edumardo/VK-16.02-Leopard/images/top.png

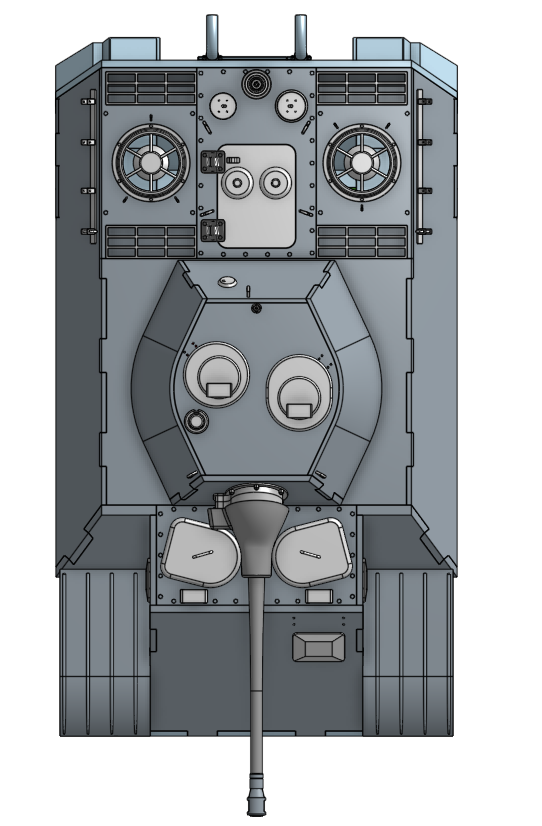
images/top.png
