edumardo/VK-16.02-Leopard/README.md

# STL files for 1/16 RC VK-16.02 Leopard

With this files you can 3D print and build a RC VK-16.02 Leopard tank. The [Leopard](https://en.wikipedia.org/wiki/VK_16.02_Leopard) was a German prototype of light reconnaissance tank, finally canceled and none was built.

## Required non-printable parts

Electronics:

* Gearboxes long shaft.
* For turret rotation, you can choose one:
  * 1 x Continuous rotation servo, like DM-S0090D.
  * 1 x Standard Heng Long motor unit.
* 2 x servos for recoil system and elevation, like MG90S.

Hardware:

* 14 x 5mmx2mm round neodymium magnets.
* 2  x M2x5mm screws.
* 8  x M2x8mm screws.

From Heng Long 3879 Panther or 3869 Jagdpanther:

* 2  x sprocket drive wheels.
* 2  x transmission covers (optional).
* 2  x idler wheels.
* 10 x wheel arms.
* 10 x wheel arm springs.
* 10 x arm screws.
* 10 x wheel bolt cover (optional).
* 6  x double wheels.
* 4  x single wheels.
* 2  x tracks (each one reduced to 67 links).
* 1  x rotating ring, the big one.

## How to build

Follw the assembly documents, preferably in order:

1. [Hull assembly](hull/hull%20assembly.pdf)
2. [Suspension assembly](suspension/suspension%20assembly.pdf)
3. [Rear stuff assembly](rear%20stuff/rear%20stuff%20assembly.pdf)
4. [Upper hull assembly](upper%20hull/upper%20hul%20assembly.pdf)
5. [Turret assembly](turret/turret%20assembly.pdf)

And the all parts STL files:

1. [hull - all parts.stl](hull/hull%20-%20all%20parts.stl)
2. [suspension - all parts.stl](suspension/suspension%20-%20all%20parts.stl)
3. [rear stuff - all parts.stl](rear%20stuff/rear%20stuff%20-%20all%20parts.sql.stl)
4. [upper hull - all parts.stl](upper%20hull/upper%20hull%20-%20all%20parts.stl)
5. [turret - all parts.stl](turret/turret%20-%20all%20parts.stl)
6. [VK16.02 Leopard - all parts.stl](VK16.02%20Leopard%20-%20all%20parts.stl) (entire model)

You can check the `all-parts` files and ungroup it to get the individual files with tools like 3D Builder or Meshmixer. Then, combine them if you want.

Additionally, you can follow the model development and construction on the following forums:

* Topic on [RCTankWarfare forum](https://www.rctankwarfare.co.uk/forums/viewtopic.php?f=23&t=32358) (english).
* Hilo en el foro [La Cadena Herrumbrosa](https://lacadenaherrumbrosa.foroactivo.com/t251-vk-16-02-leopard) (español).

## Bibliography and documentation

Primary source:

* Panzer Tracts 20-2 - Paper Panzers

Secondary sources:

* Panzer Tracts No. 05-1 - Panzerkampfwagen Panther Ausfuehrung D with Versuchs-Serie Panther, Fgst.Nr.V2
* Panzer Tracts No. 05-2 - Panzerkampfwagen Panther Ausfuehrung A
* Panzer Tracts No. 05-3 - Panzerkampfwagen Panther Ausfuehrung G
* Panzer Tracts No. 09-3 - Jagdpanther Panzerjaeger Panther (8.8 cm) (Sd.Kfz.173) Ausf.G 1 und G2

All books by Thomas L. Jentz and Hilary Louis Doyle.
