edumardo/VK-16.02-Leopard/images/front.png

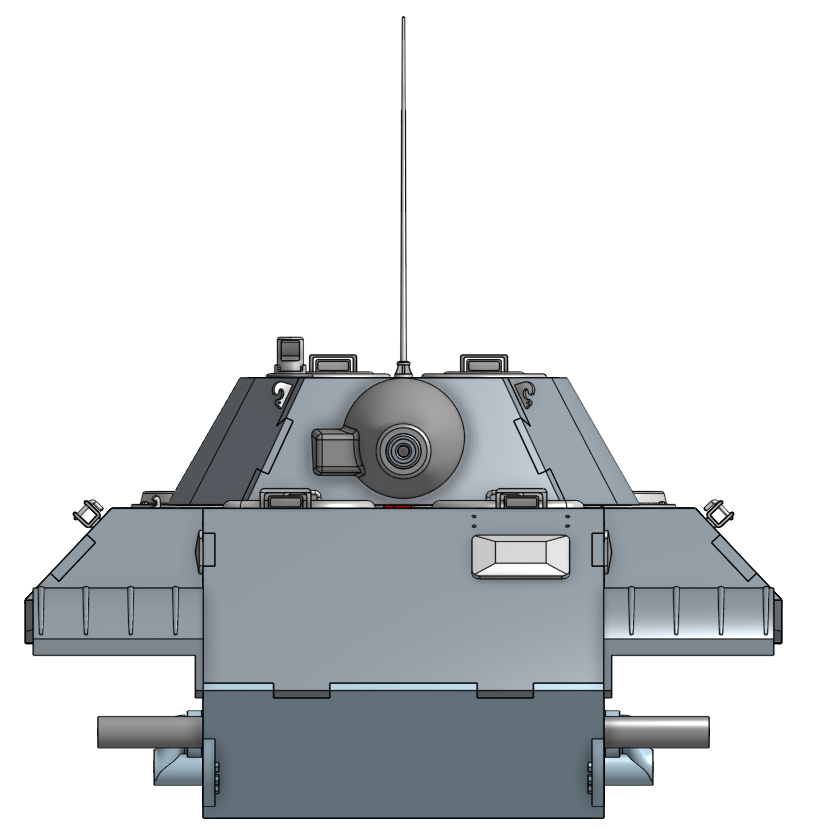
images/front.png
