edumardo/VK-16.02-Leopard/images/isometric 1.png

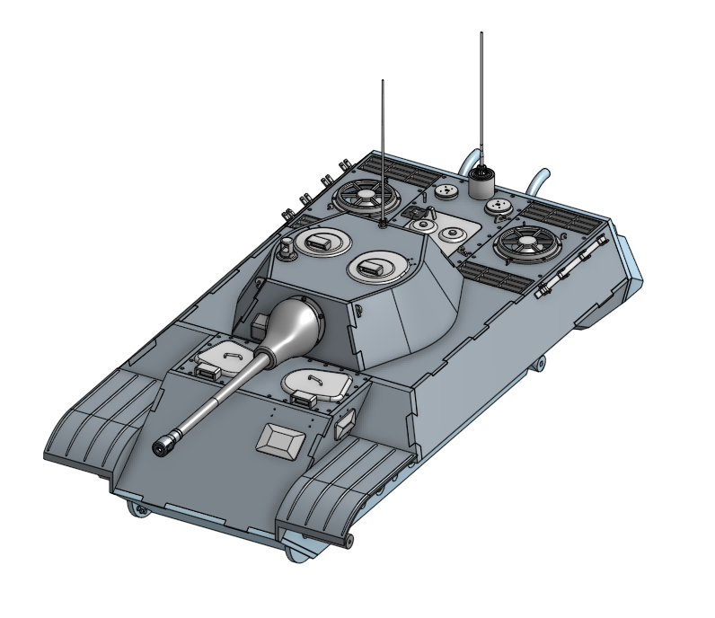
images/isometric 1.png
