edumardo/VK-16.02-Leopard/images/isometric 2.png

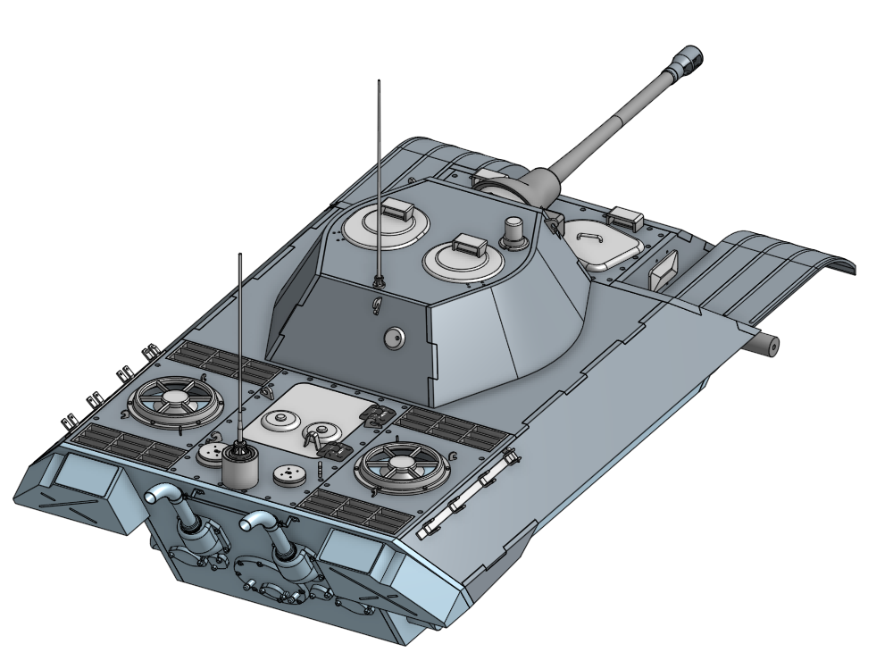
images/isometric 2.png
