edumardo/VK-16.02-Leopard/images/left.png

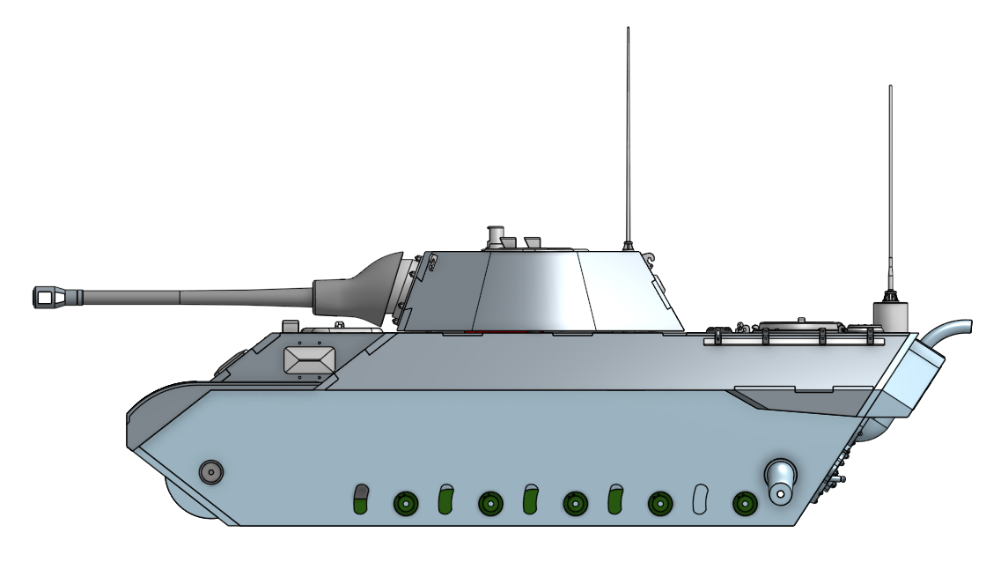
images/left.png
