edumardo/VK-16.02-Leopard/images/rear.png

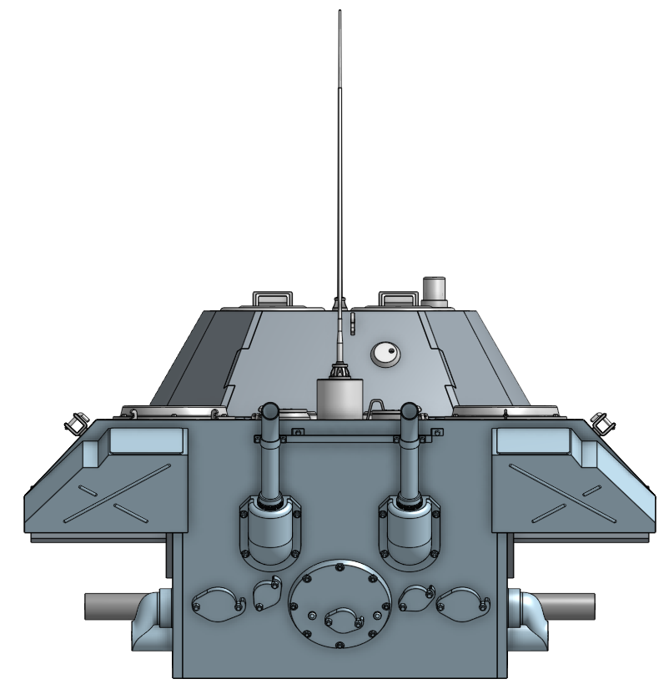
images/rear.png
