edumardo/VK-16.02-Leopard/images/right.png

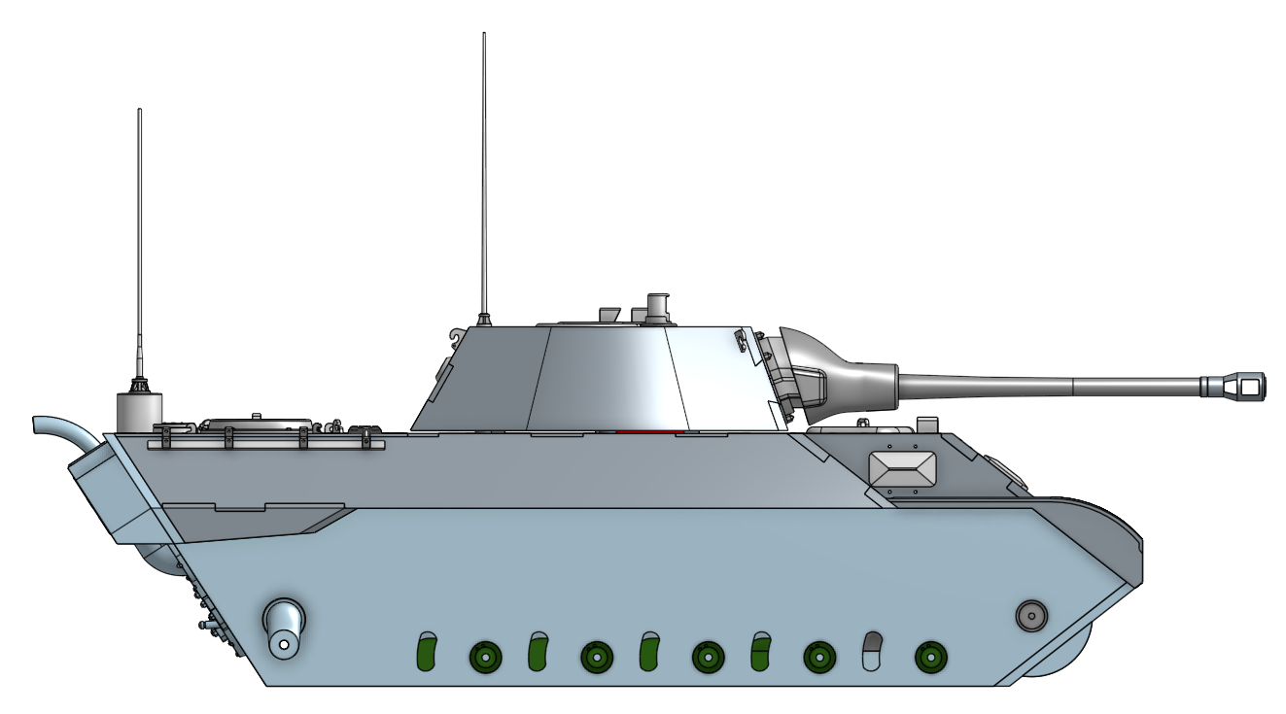
images/right.png
