edumardo/VK-16.02-Leopard/hull/lower hull.stl

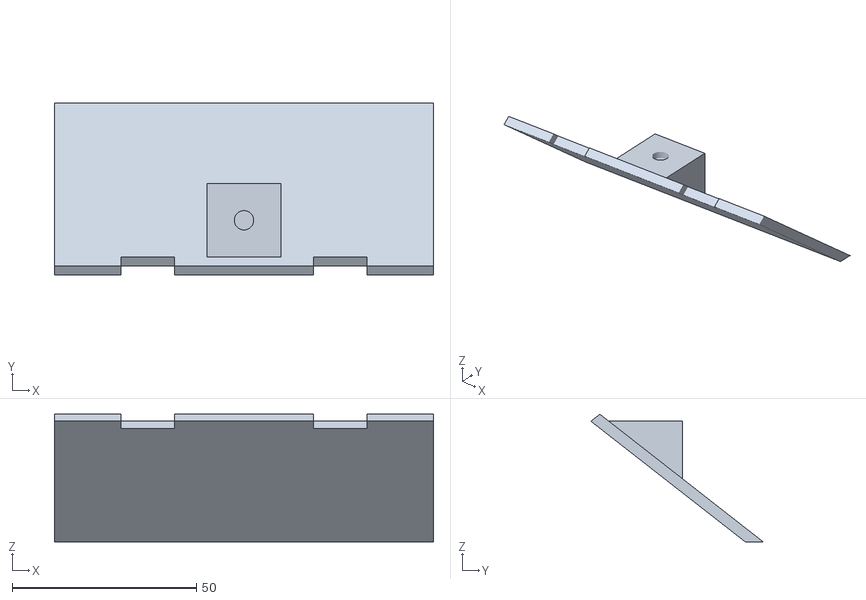
[picture p8: CAD file, 2022-06-27]
hull/lower hull.stl
102.8 x 46.7 x 34.6
