edumardo/VK-16.02-Leopard/rear stuff/exhaust pipe v2 left.stl

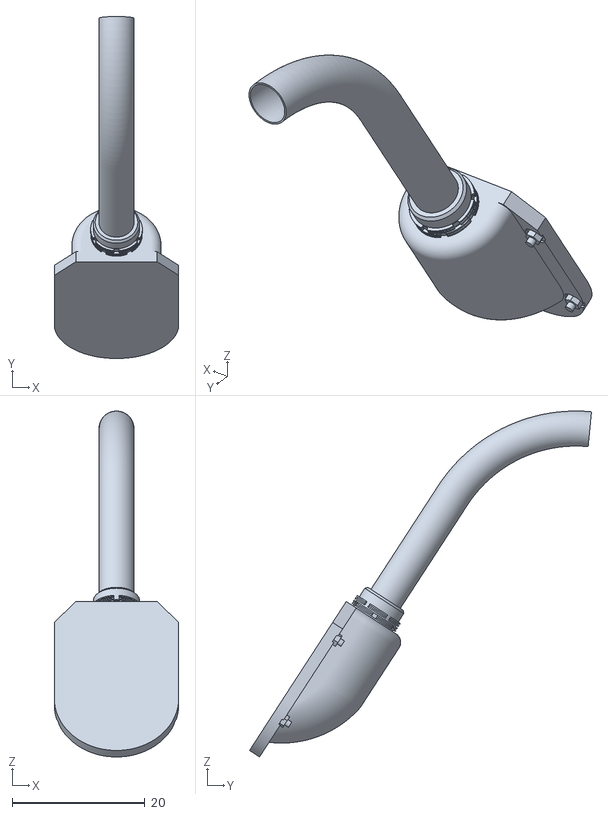
[picture p9: CAD file, 2022-04-29]
rear stuff/exhaust pipe v2 left.stl
18.7 x 51.5 x 52.1
