edumardo/VK-16.02-Leopard/suspension/swing arm support motor left.stl

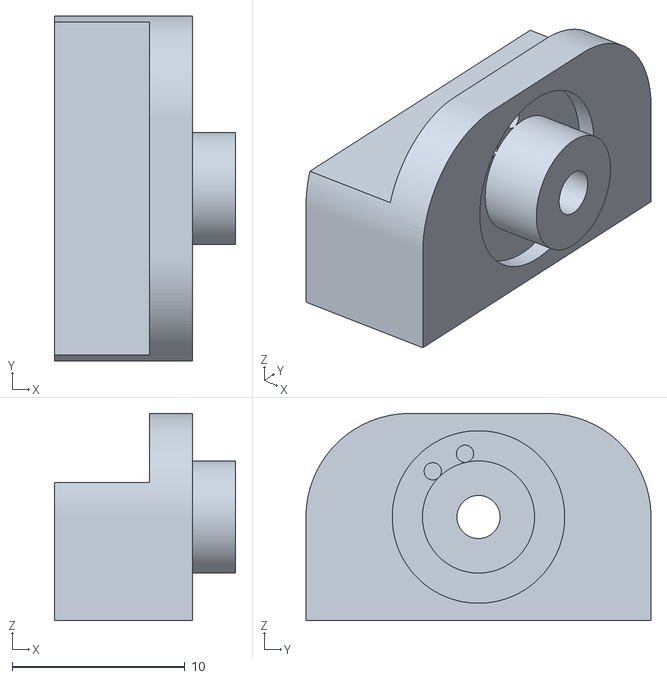
[picture p10: CAD file, 2022-06-21]
suspension/swing arm support motor left.stl
10.5 x 20.0 x 12.0
