edumardo/VK-16.02-Leopard/turret/gun barrel - hollow part b.stl

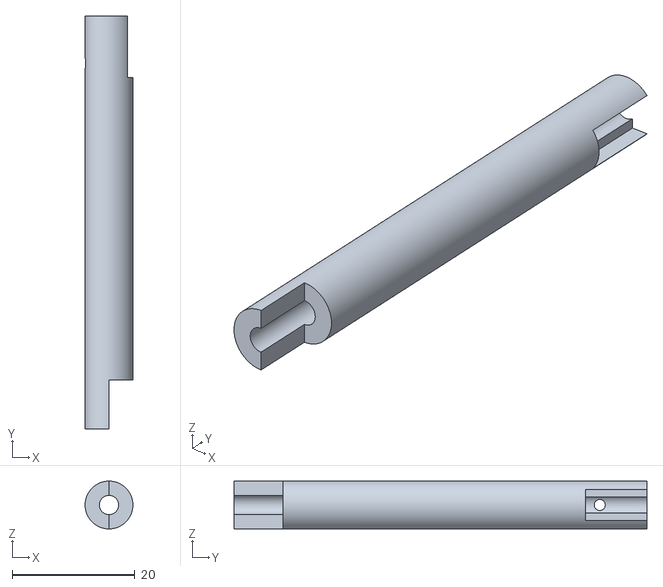
[picture p11: CAD file, 2026-04-24]
turret/gun barrel - hollow part b.stl
7.80 x 67.3 x 7.80
