edumardo/VK-16.02-Leopard/upper hull/radio hatch.stl

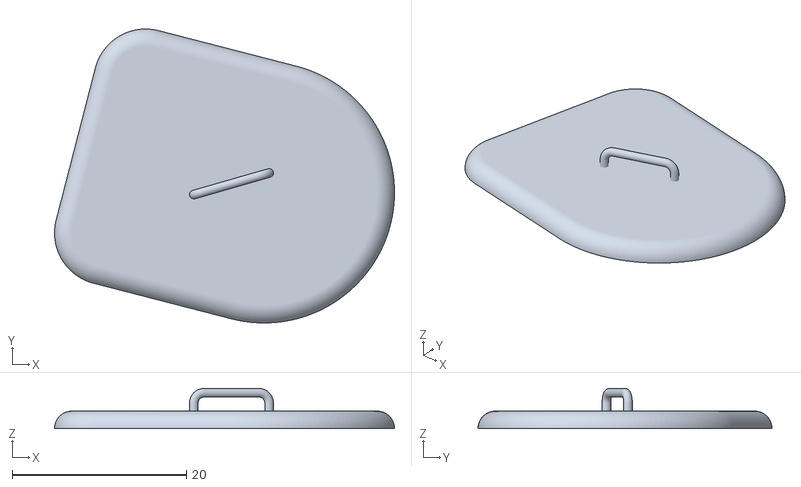
[picture p12: CAD file, 2022-10-20]
upper hull/radio hatch.stl
39.0 x 33.8 x 4.60
