edumardo/VK-16.02-Leopard/hull/hull - all parts.stl

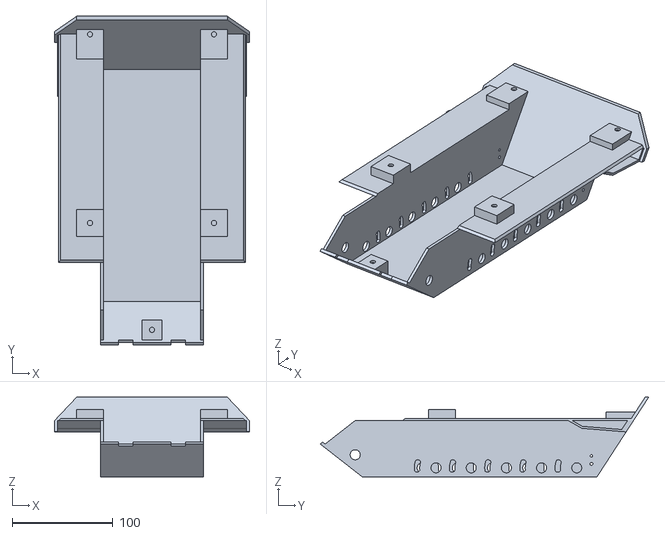
[picture p13: CAD file, 2022-06-27]
hull/hull - all parts.stl
194.0 x 326.8 x 79.4
