edumardo/VK-16.02-Leopard/rear stuff/rear stowage bin right.stl

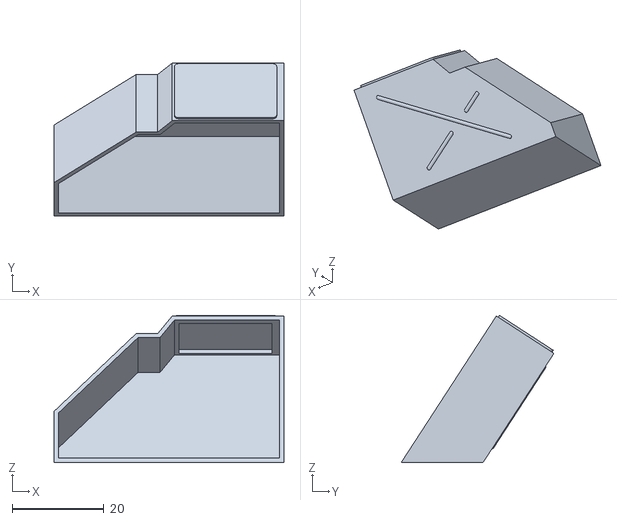
[picture p14: CAD file, 2022-04-29]
rear stuff/rear stowage bin right.stl
50.2 x 33.4 x 32.2
