edumardo/VK-16.02-Leopard/turret/gun barrel hollow.stl

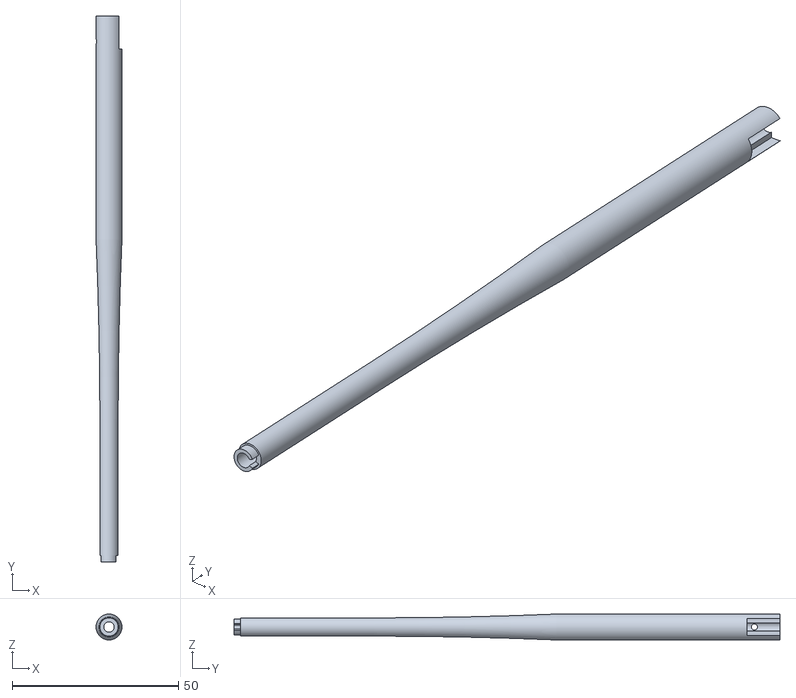
[picture p15: CAD file, 2026-04-24]
turret/gun barrel hollow.stl
7.80 x 164.3 x 7.80
