edumardo/VK-16.02-Leopard/upper hull/spare track link pin.stl

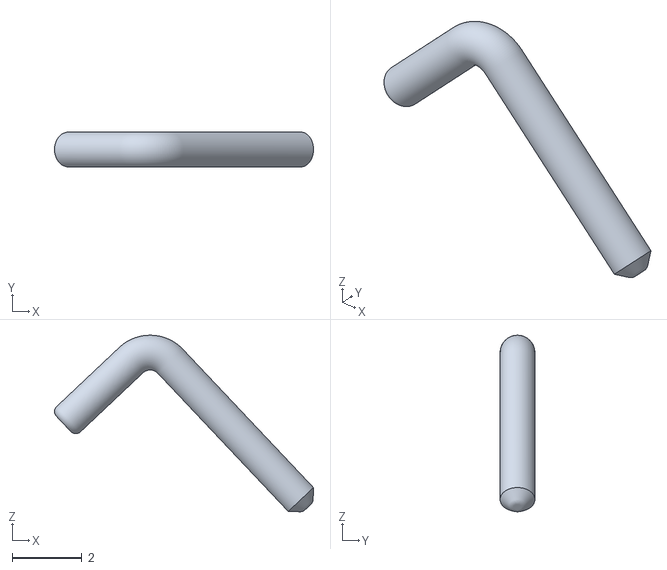
[picture p16: CAD file, 2022-10-20]
upper hull/spare track link pin.stl
7.44 x 1 x 5.07
