edumardo/VK-16.02-Leopard/hull/pannier right.stl

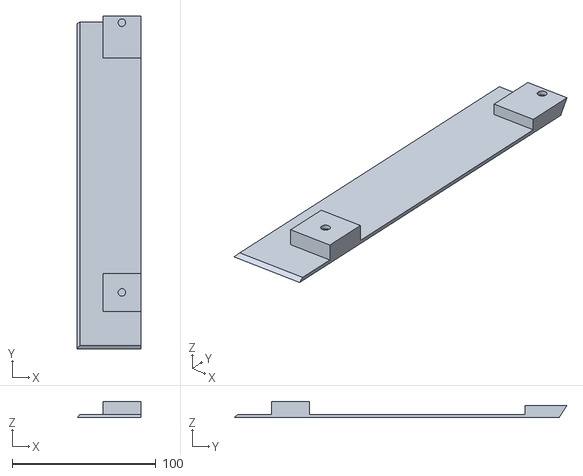
[picture p17: CAD file, 2022-06-15]
hull/pannier right.stl
44.5 x 231.8 x 11.2
