edumardo/VK-16.02-Leopard/suspension/idler arm left.stl

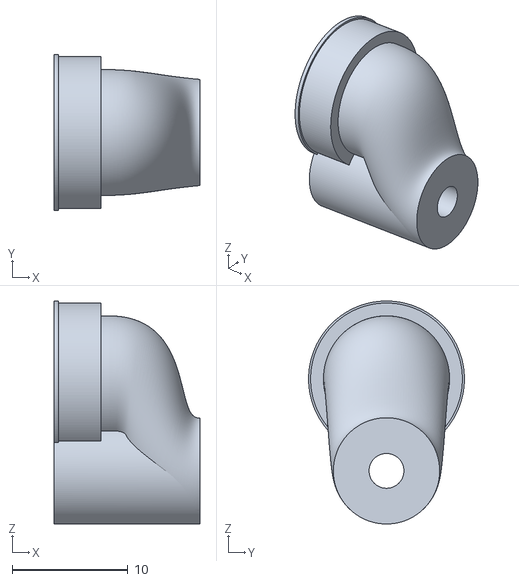
[picture p18: CAD file, 2022-06-15]
suspension/idler arm left.stl
12.6 x 13.4 x 19.2
