edumardo/VK-16.02-Leopard/turret/gun barrel - hollow part a.stl

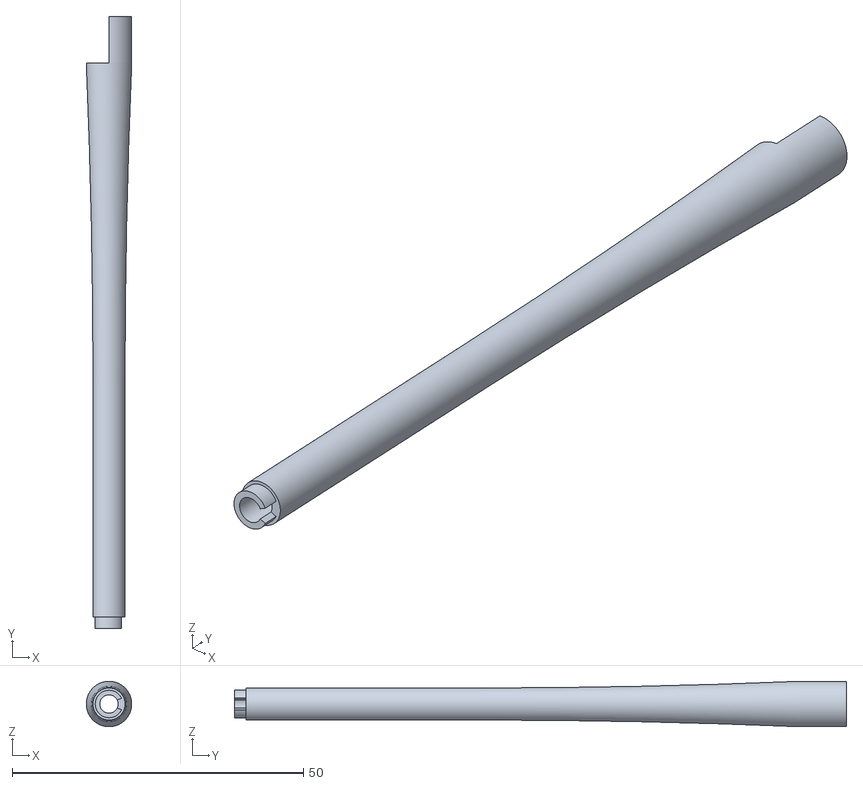
[picture p19: CAD file, 2026-04-24]
turret/gun barrel - hollow part a.stl
7.80 x 105.0 x 7.80
