edumardo/VK-16.02-Leopard/upper hull/spare track link holder.stl

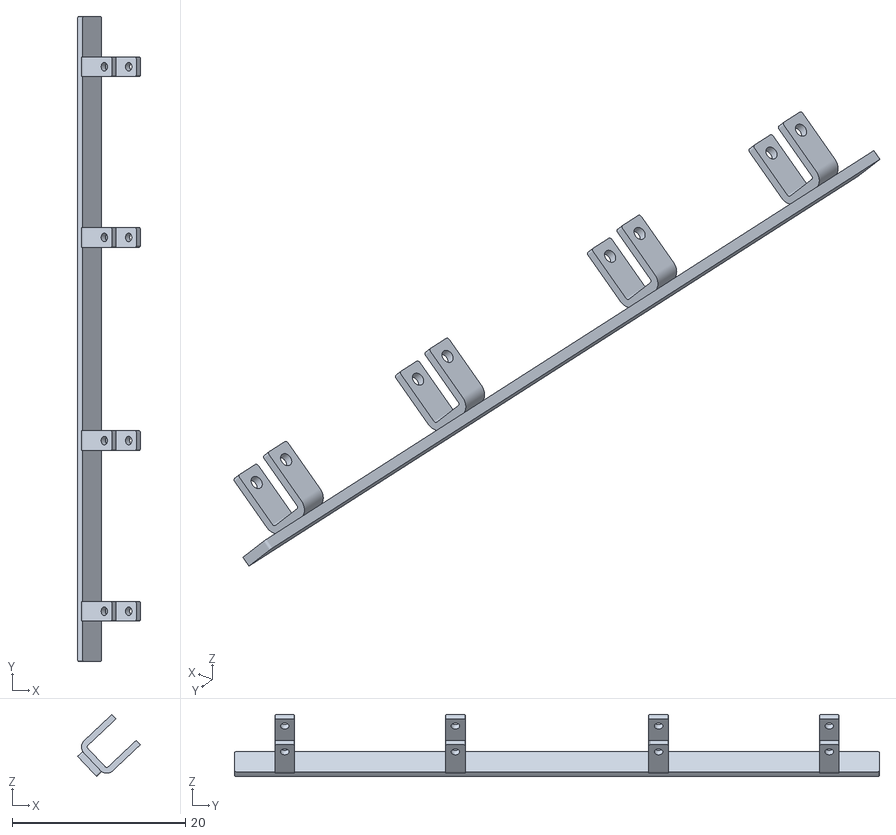
[picture p20: CAD file, 2022-10-20]
upper hull/spare track link holder.stl
7.25 x 74.4 x 7.16
