edumardo/VK-16.02-Leopard/hull/hull right.stl

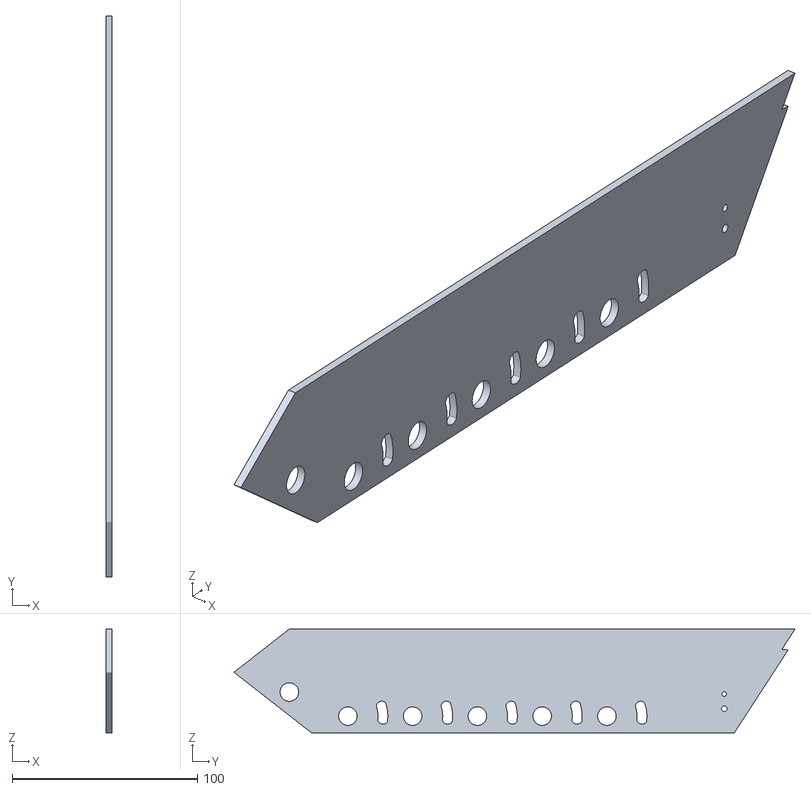
[picture p21: CAD file, 2022-06-15]
hull/hull right.stl
3.00 x 303.2 x 56.0
