edumardo/VK-16.02-Leopard/rear stuff/exhaust brackets inner.stl

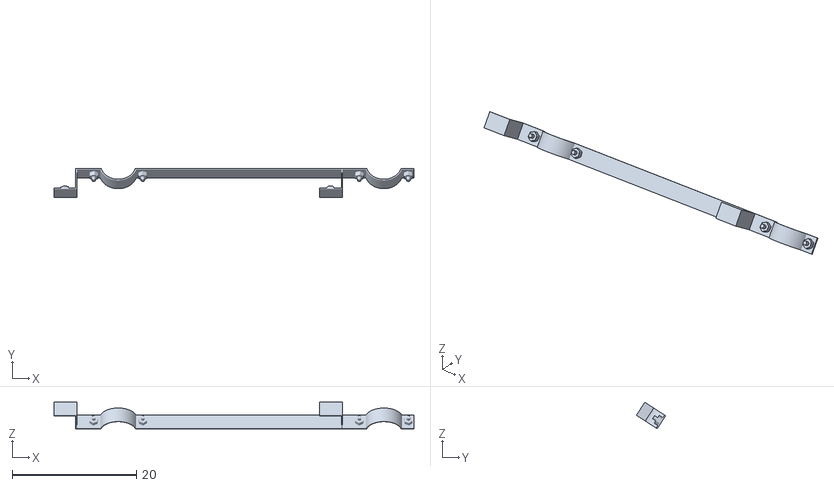
[picture p22: CAD file, 2022-04-29]
rear stuff/exhaust brackets inner.stl
58.0 x 4.72 x 4.28
