edumardo/VK-16.02-Leopard/turret/turret base.stl

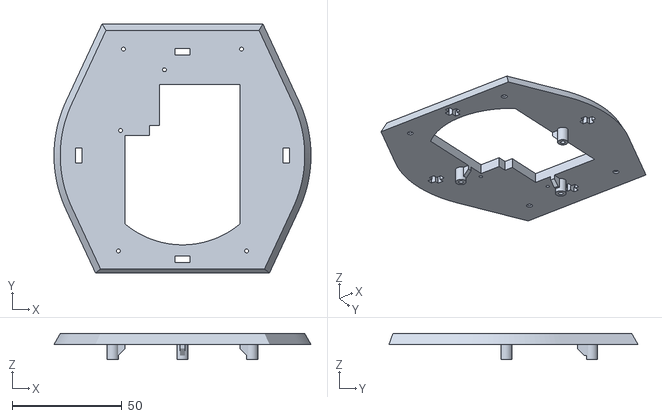
[picture p23: CAD file, 2026-04-24]
turret/turret base.stl
117.2 x 113.6 x 12.0
