edumardo/VK-16.02-Leopard/rear stuff/rear big cover 2.stl

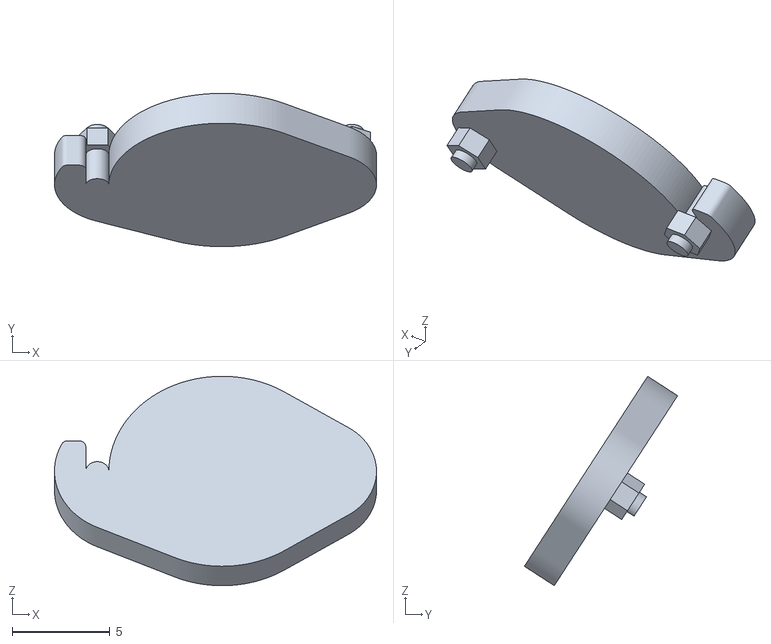
[picture p24: CAD file, 2022-04-29]
rear stuff/rear big cover 2.stl
16.4 x 7.82 x 10.7
