edumardo/VK-16.02-Leopard/suspension/transmission cover left.stl

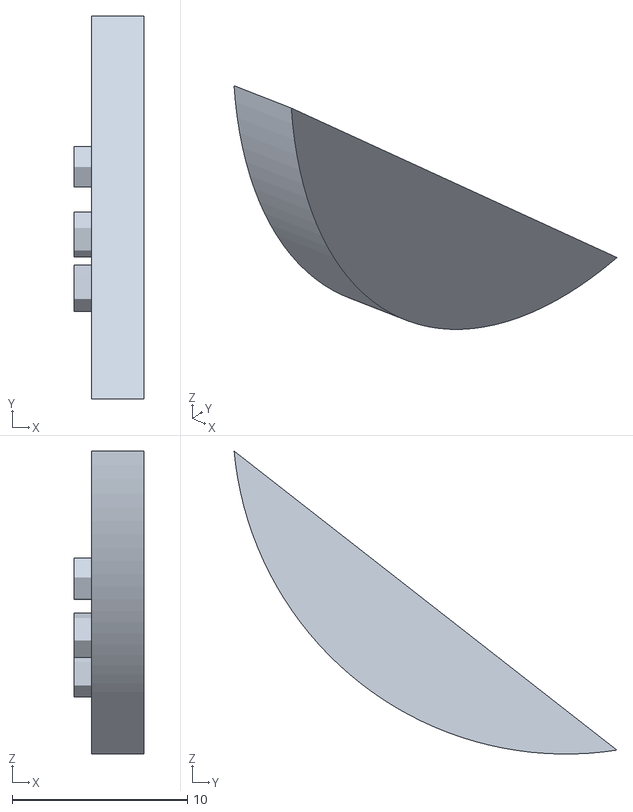
[picture p25: CAD file, 2022-02-18]
suspension/transmission cover left.stl
4.00 x 21.8 x 17.3
