edumardo/VK-16.02-Leopard/turret/gun barrel - part a.stl

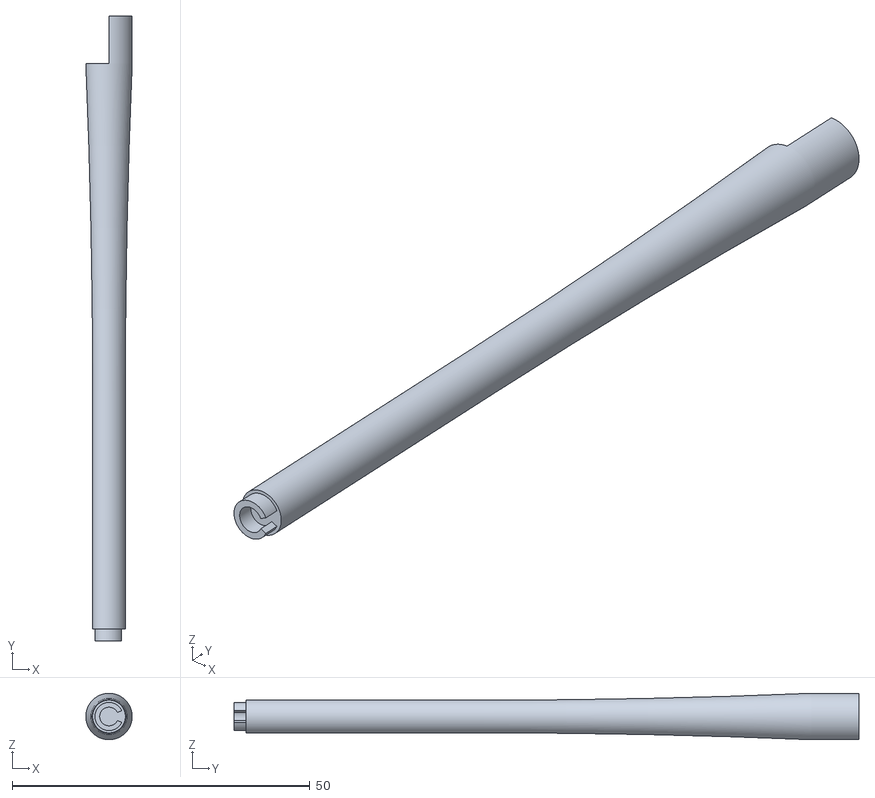
[picture p26: CAD file, 2022-11-24]
turret/gun barrel - part a.stl
7.80 x 105.0 x 7.80
