edumardo/VK-16.02-Leopard/upper hull/upper hull right.stl

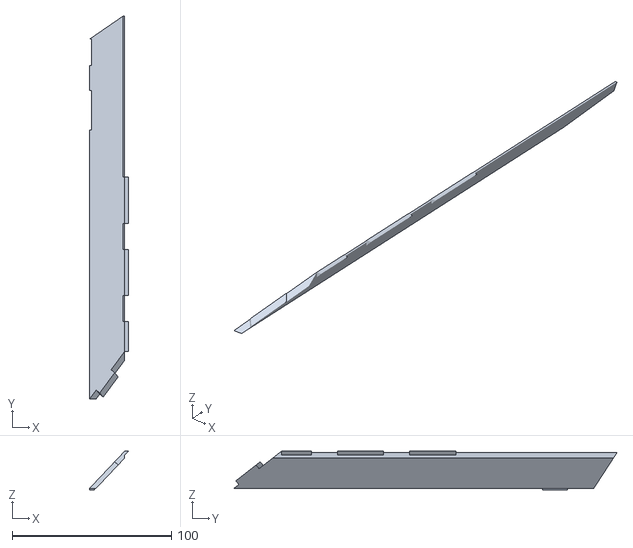
[picture p27: CAD file, 2022-07-21]
upper hull/upper hull right.stl
24.4 x 240.9 x 24.4
