edumardo/VK-16.02-Leopard/rear stuff/rear small cover.stl

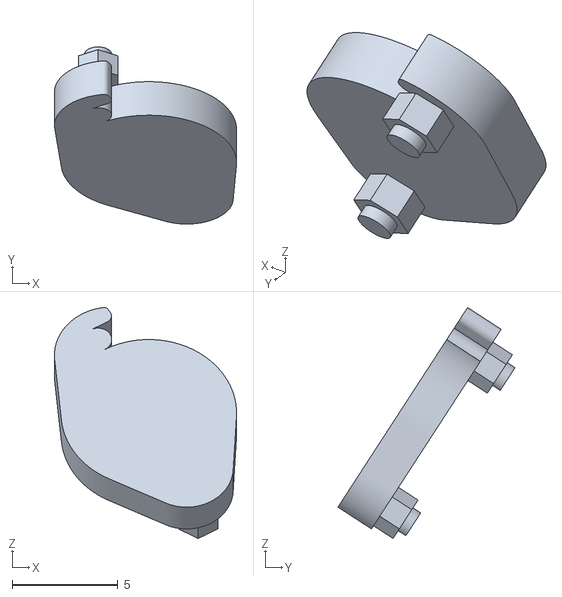
[picture p28: CAD file, 2022-04-29]
rear stuff/rear small cover.stl
8.60 x 8.37 x 10.9
