edumardo/VK-16.02-Leopard/turret/turret right.stl

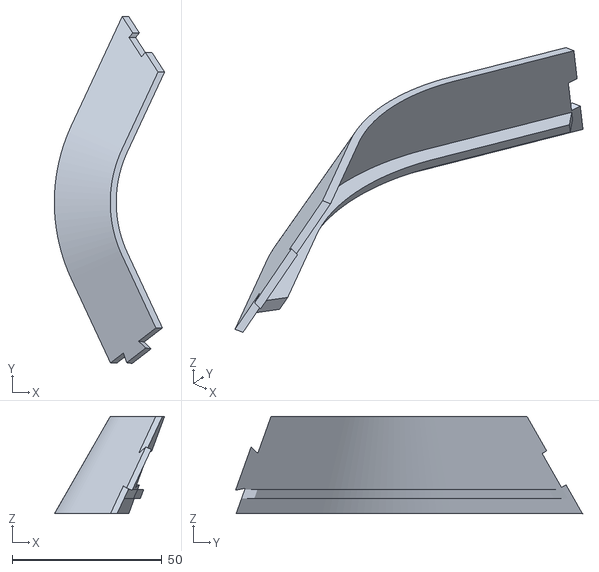
[picture p29: CAD file, 2022-11-24]
turret/turret right.stl
36.8 x 115.8 x 32.5
