edumardo/VK-16.02-Leopard/upper hull/small hook x6.stl

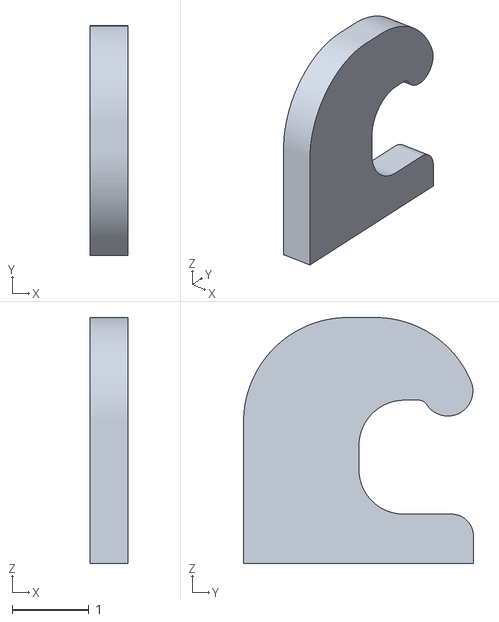
[picture p30: CAD file, 2022-07-21]
upper hull/small hook x6.stl
0.5 x 3.00 x 3.21
