edumardo/VK-16.02-Leopard/hull/pannier right extra.stl

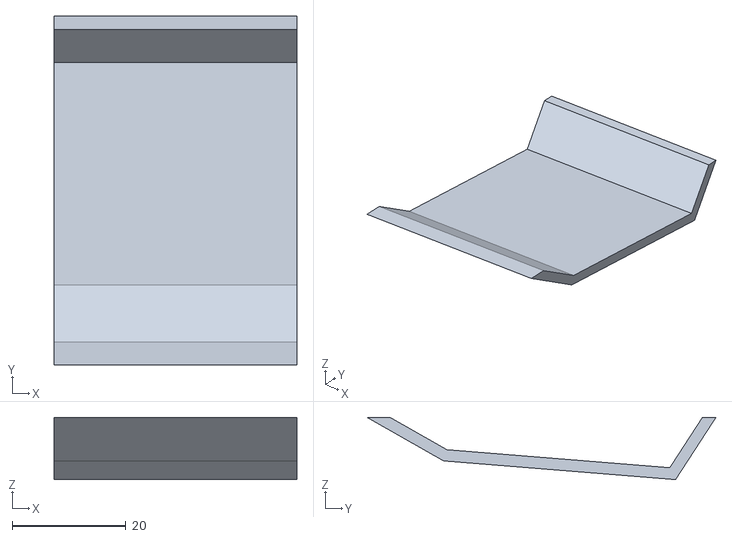
[picture p31: CAD file, 2022-01-26]
hull/pannier right extra.stl
42.6 x 61.3 x 10.9
