edumardo/VK-16.02-Leopard/rear stuff/exhaust bracket outer right.stl

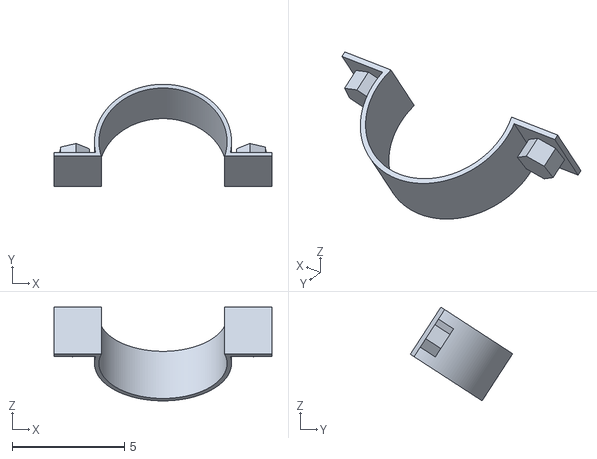
[picture p32: CAD file, 2022-04-29]
rear stuff/exhaust bracket outer right.stl
9.70 x 4.56 x 4.17
