edumardo/VK-16.02-Leopard/turret/antenna.stl

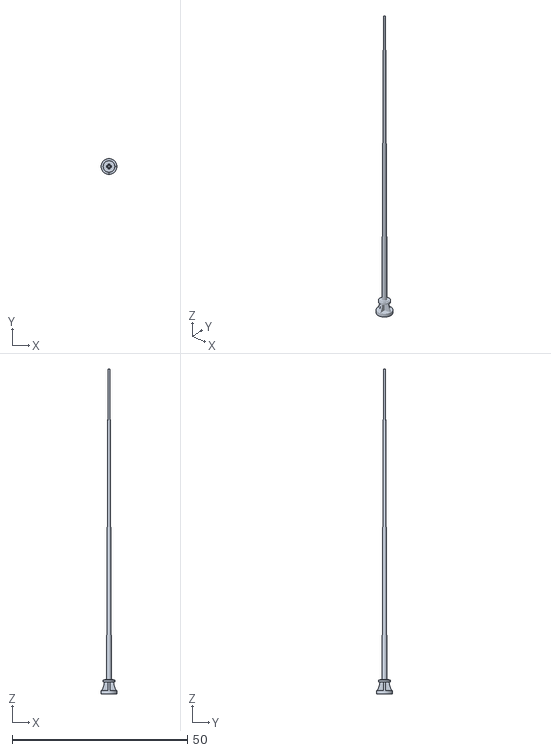
[picture p33: CAD file, 2022-11-24]
turret/antenna.stl
4.50 x 4.50 x 92.6
