edumardo/VK-16.02-Leopard/upper hull/extra side left.stl

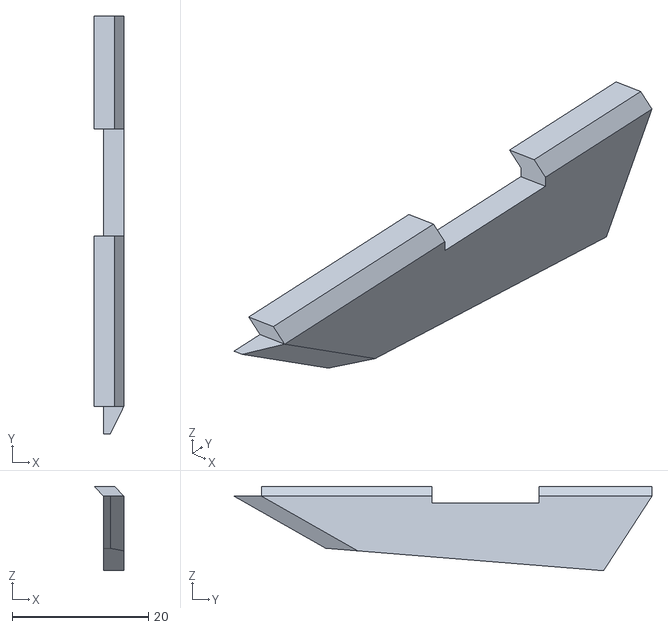
[picture p34: CAD file, 2022-07-21]
upper hull/extra side left.stl
4.37 x 61.3 x 12.4
