edumardo/VK-16.02-Leopard/hull/belly.stl

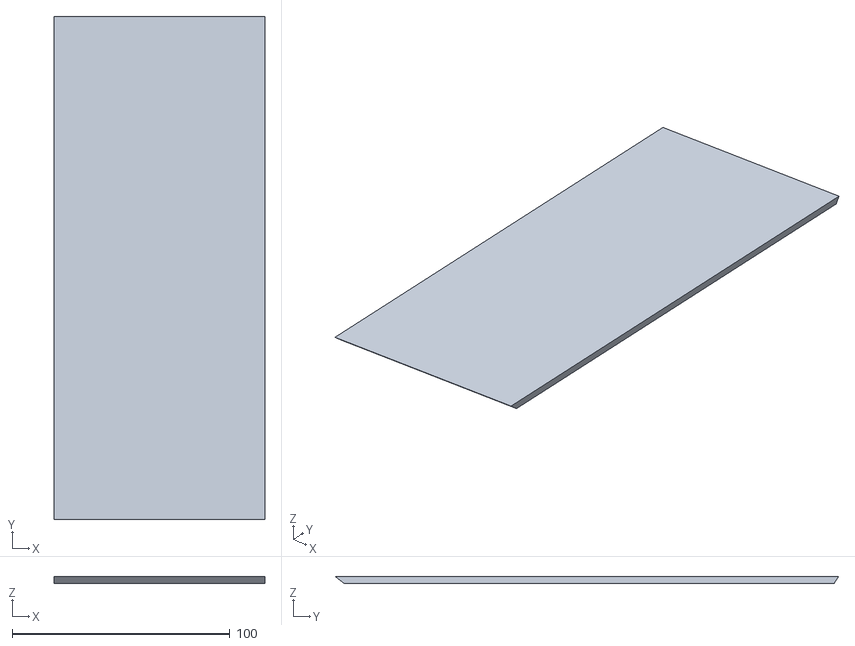
[picture p35: CAD file, 2022-01-26]
hull/belly.stl
96.8 x 230.8 x 3.00
