edumardo/VK-16.02-Leopard/turret/periscope turret x2.stl

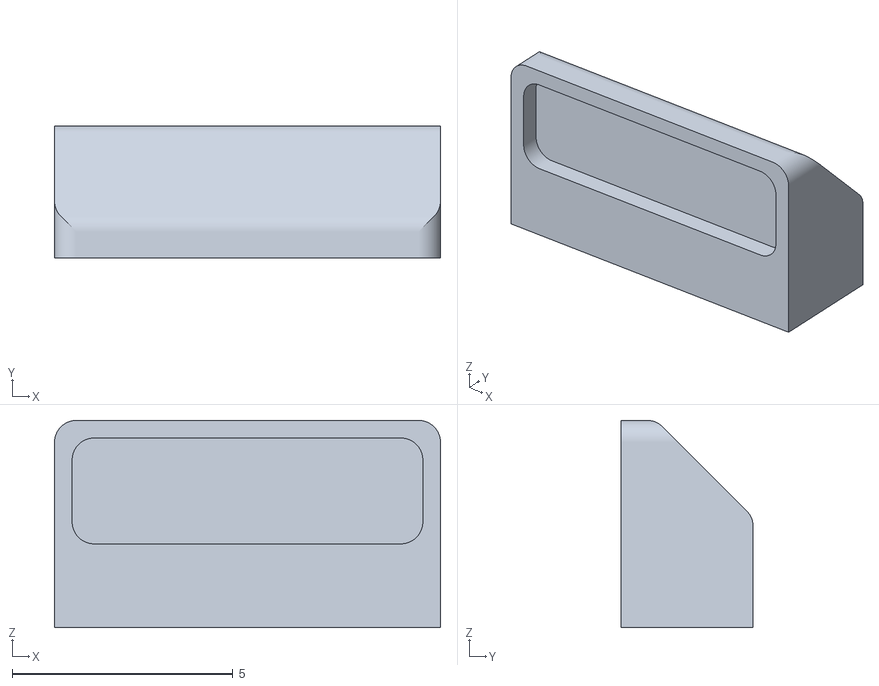
[picture p36: CAD file, 2022-11-24]
turret/periscope turret x2.stl
8.75 x 3.00 x 4.70
