edumardo/VK-16.02-Leopard/upper hull/air intake cover front x2.stl

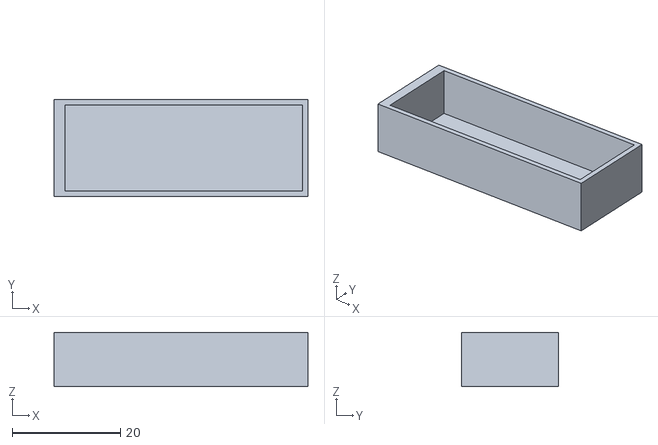
[picture p37: CAD file, 2022-07-21]
upper hull/air intake cover front x2.stl
47.0 x 18.0 x 10.0
