edumardo/VK-16.02-Leopard/hull/rear.stl

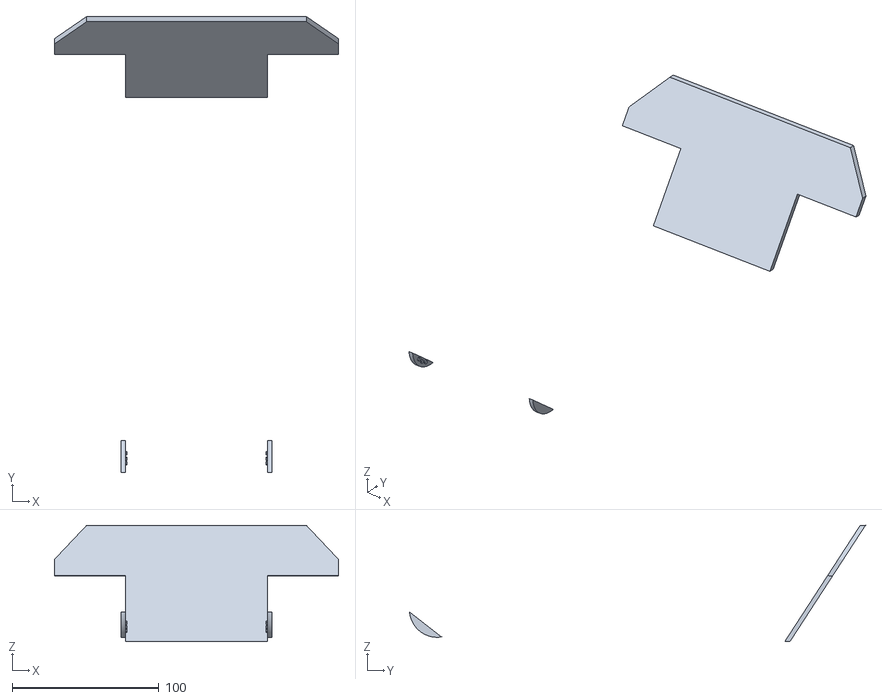
[picture p38: CAD file, 2022-01-26]
hull/rear.stl
194.0 x 311.0 x 79.4
