edumardo/VK-16.02-Leopard/rear stuff/rear engine access hatch.stl

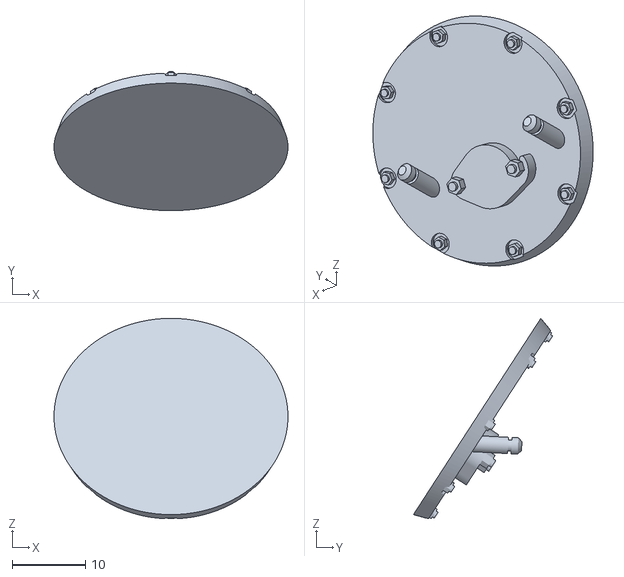
[picture p39: CAD file, 2022-04-29]
rear stuff/rear engine access hatch.stl
31.9 x 19.0 x 27.3
