edumardo/VK-16.02-Leopard/turret/rotation servo bracket 2.stl

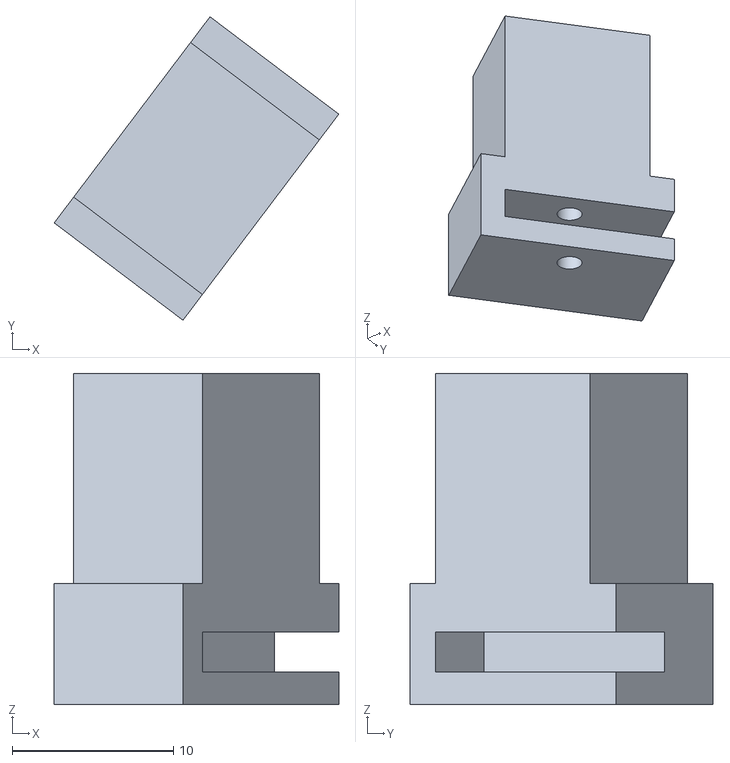
[picture p40: CAD file, 2022-11-24]
turret/rotation servo bracket 2.stl
17.6 x 18.8 x 20.5
