edumardo/VK-16.02-Leopard/upper hull/fender left.stl

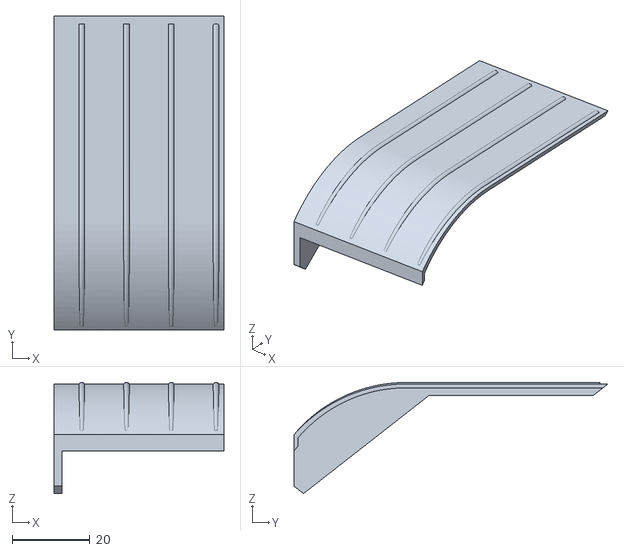
[picture p41: CAD file, 2022-07-21]
upper hull/fender left.stl
43.6 x 80.7 x 28.6
