edumardo/VK-16.02-Leopard/turret/rotation servo gear.stl

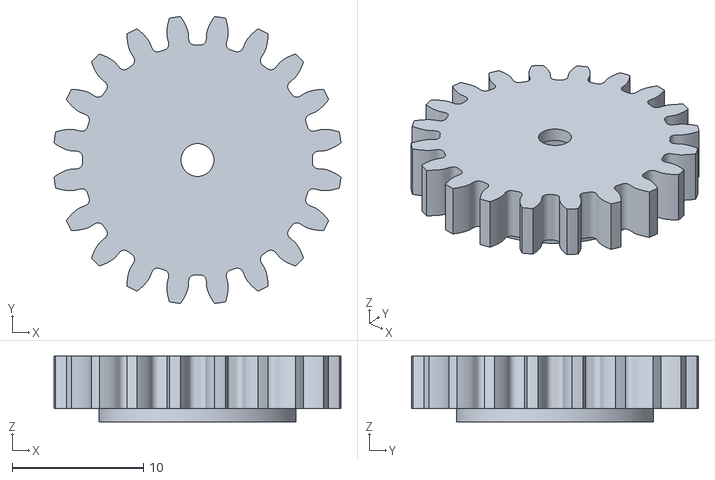
[picture p42: CAD file, 2022-11-24]
turret/rotation servo gear.stl
21.8 x 21.8 x 5.00
