edumardo/VK-16.02-Leopard/upper hull/engine hatch air intake x2.stl

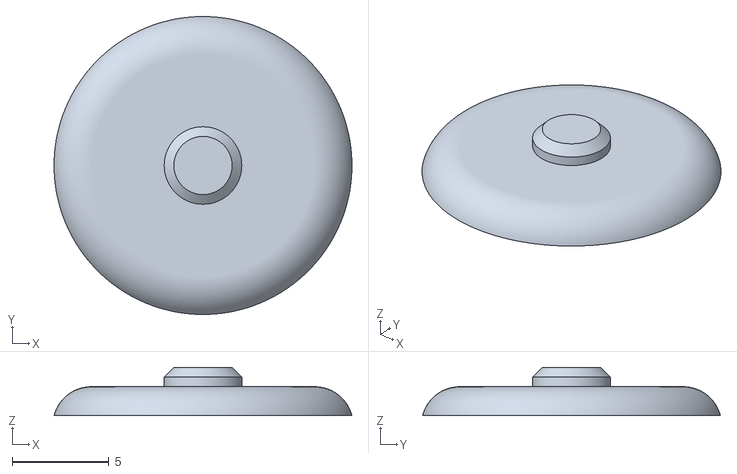
[picture p43: CAD file, 2022-07-21]
upper hull/engine hatch air intake x2.stl
15.4 x 15.4 x 2.50
