edumardo/VK-16.02-Leopard/hull/transmission cover right.stl

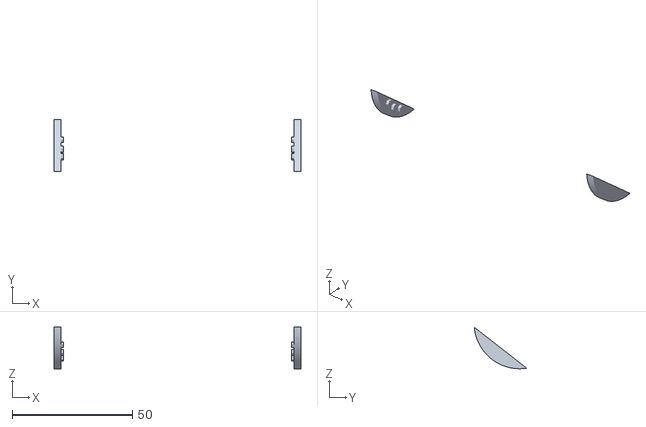
[picture p44: CAD file, 2022-01-26]
hull/transmission cover right.stl
102.8 x 21.8 x 17.3
