edumardo/VK-16.02-Leopard/rear stuff/rear small cover 2.stl

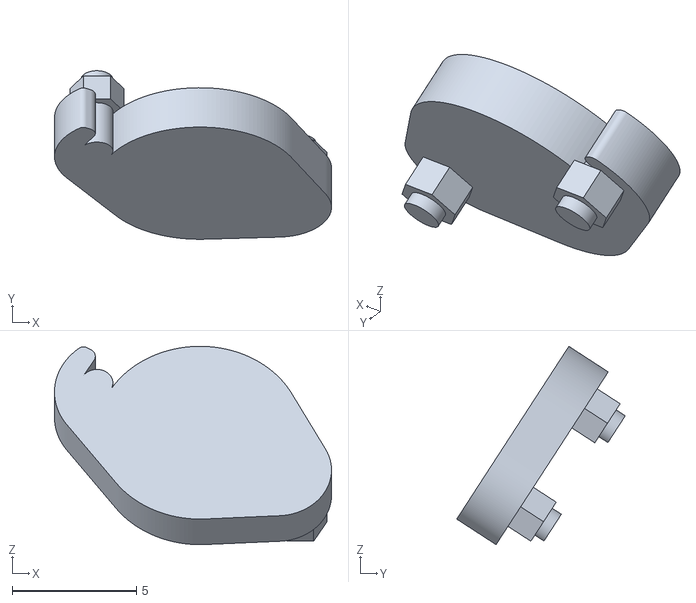
[picture p45: CAD file, 2022-04-29]
rear stuff/rear small cover 2.stl
11.2 x 6.79 x 7.98
