edumardo/VK-16.02-Leopard/turret/servo elevation fixer right.stl

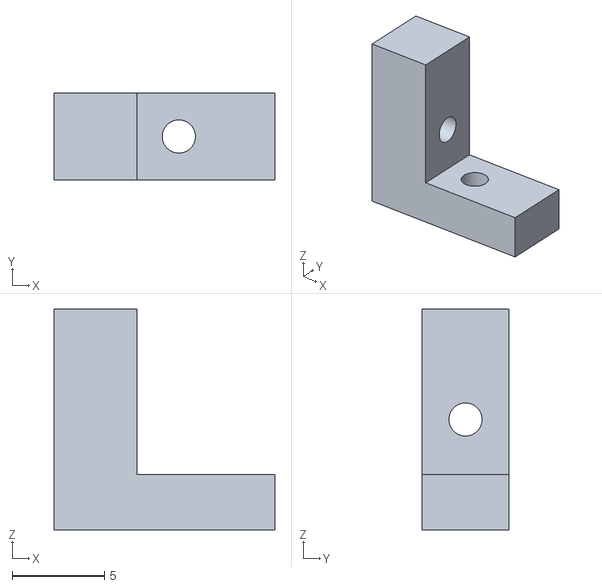
[picture p46: CAD file, 2022-11-24]
turret/servo elevation fixer right.stl
12.0 x 4.70 x 12.0
