edumardo/VK-16.02-Leopard/upper hull/side vision port x2.stl

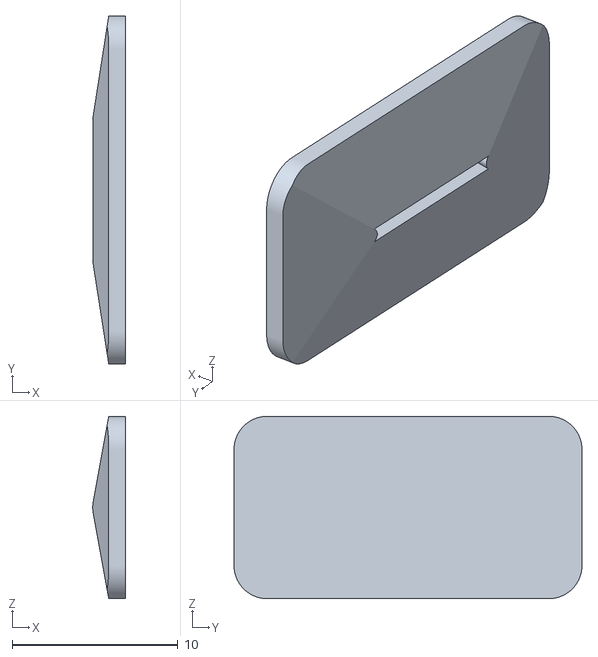
[picture p47: CAD file, 2022-07-21]
upper hull/side vision port x2.stl
1.97 x 21.0 x 11.0
