edumardo/VK-16.02-Leopard/turret/turret front.stl

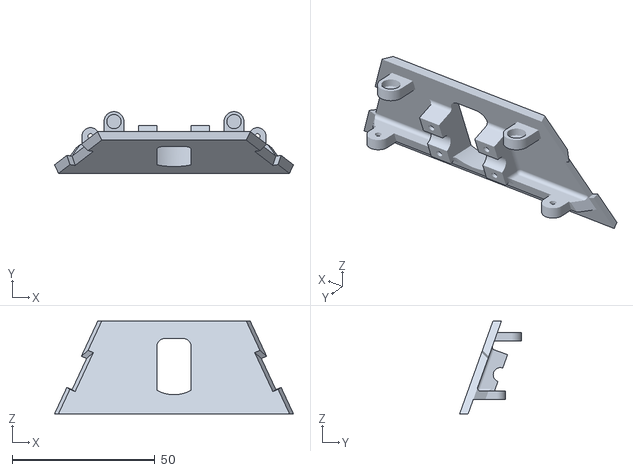
[picture p48: CAD file, 2022-11-24]
turret/turret front.stl
83.8 x 21.7 x 32.5
