edumardo/VK-16.02-Leopard/upper hull/sternantenne.stl

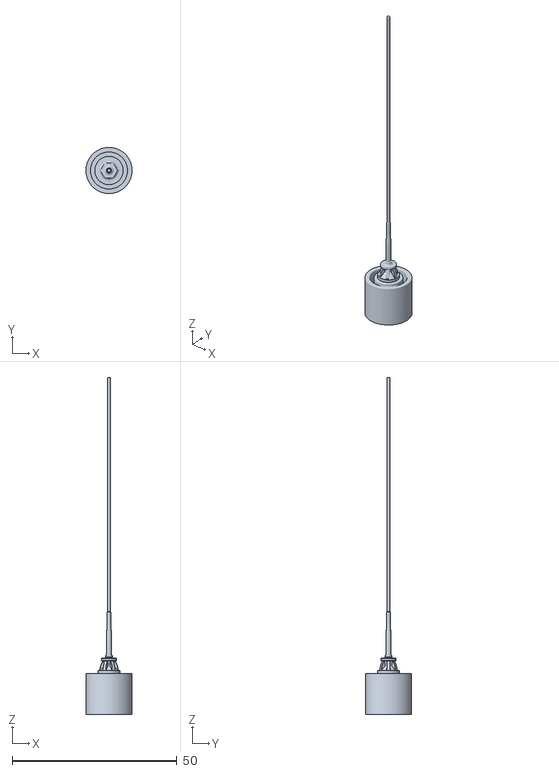
[picture p49: CAD file, 2022-07-21]
upper hull/sternantenne.stl
14.0 x 14.0 x 102.2
