edumardo/VK-16.02-Leopard/turret/gun support.stl

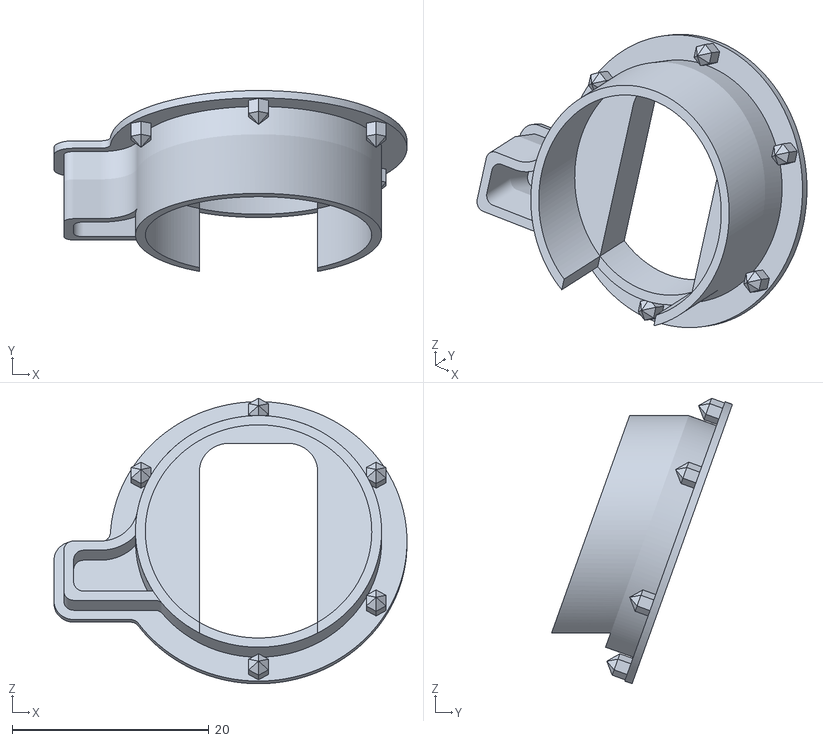
[picture p50: CAD file, 2022-11-24]
turret/gun support.stl
35.9 x 18.4 x 29.0
