edumardo/VK-16.02-Leopard/upper hull/periscope armor guard x2.stl

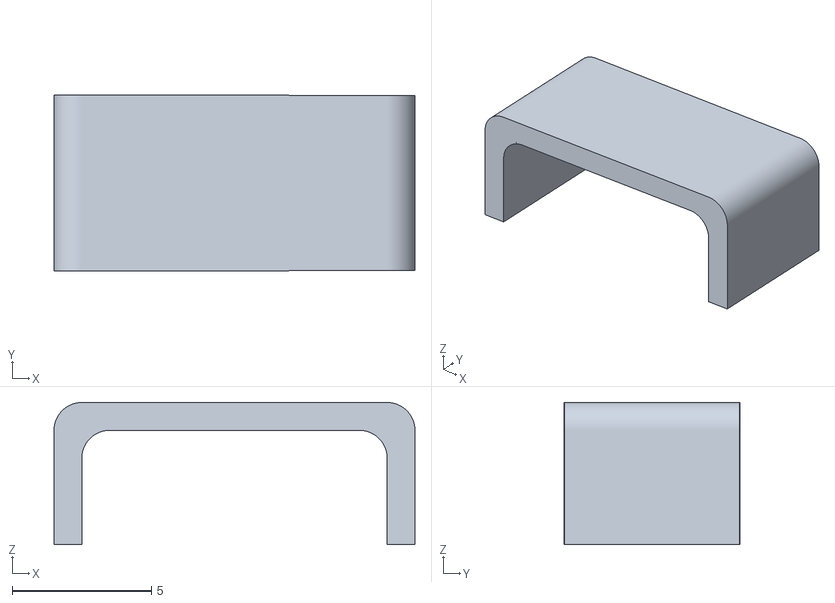
[picture p51: CAD file, 2022-07-21]
upper hull/periscope armor guard x2.stl
13.0 x 6.33 x 5.10
