edumardo/VK-16.02-Leopard/turret/gun pivot support.stl

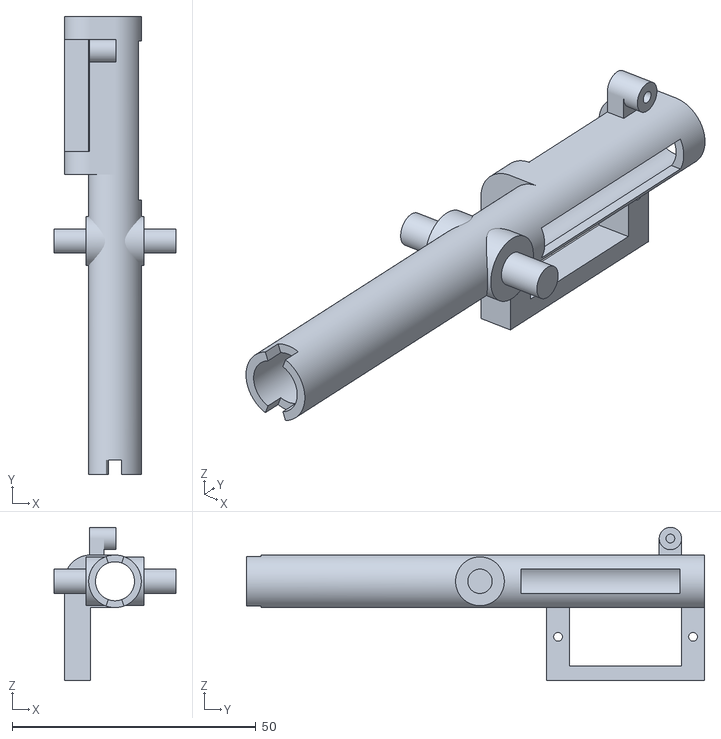
[picture p52: CAD file, 2022-11-24]
turret/gun pivot support.stl
25.0 x 94.0 x 31.5
