edumardo/VK-16.02-Leopard/upper hull/glacis left.stl

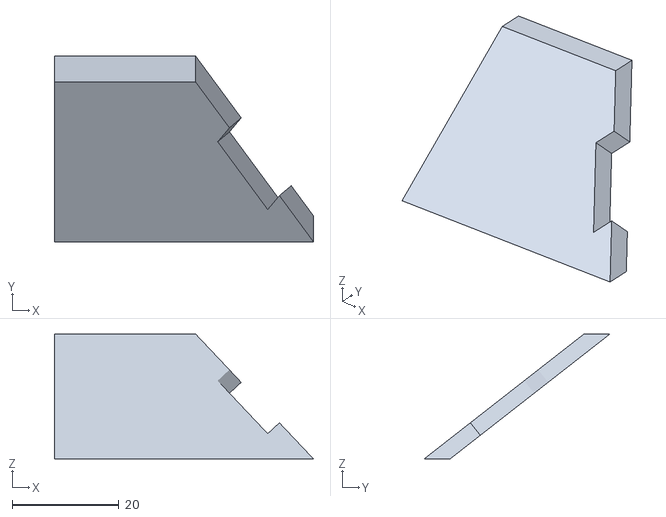
[picture p53: CAD file, 2022-07-21]
upper hull/glacis left.stl
48.6 x 34.8 x 23.4
