edumardo/VK-16.02-Leopard/turret/turret roof.stl

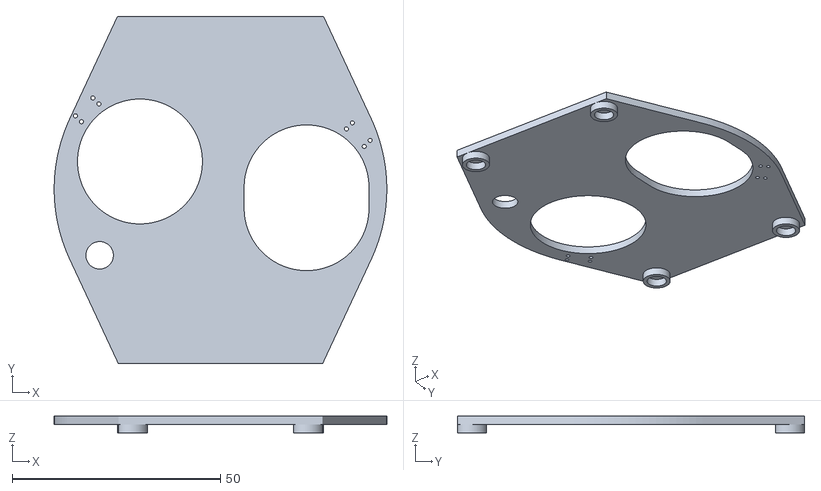
[picture p54: CAD file, 2022-11-24]
turret/turret roof.stl
79.9 x 83.4 x 4.00
