edumardo/VK-16.02-Leopard/upper hull/deck A.stl

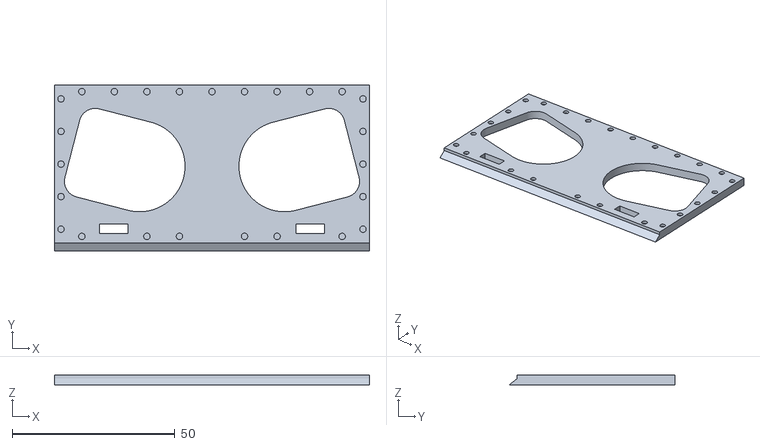
[picture p55: CAD file, 2022-07-21]
upper hull/deck A.stl
96.8 x 50.9 x 3.00
