edumardo/VK-16.02-Leopard/turret/turret hatch 1.stl

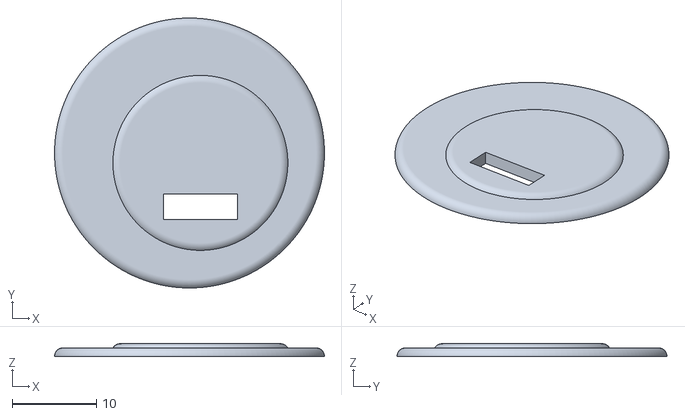
[picture p56: CAD file, 2022-11-24]
turret/turret hatch 1.stl
32.0 x 32.0 x 1.50
