edumardo/VK-16.02-Leopard/upper hull/stop for opened engine hatch.stl

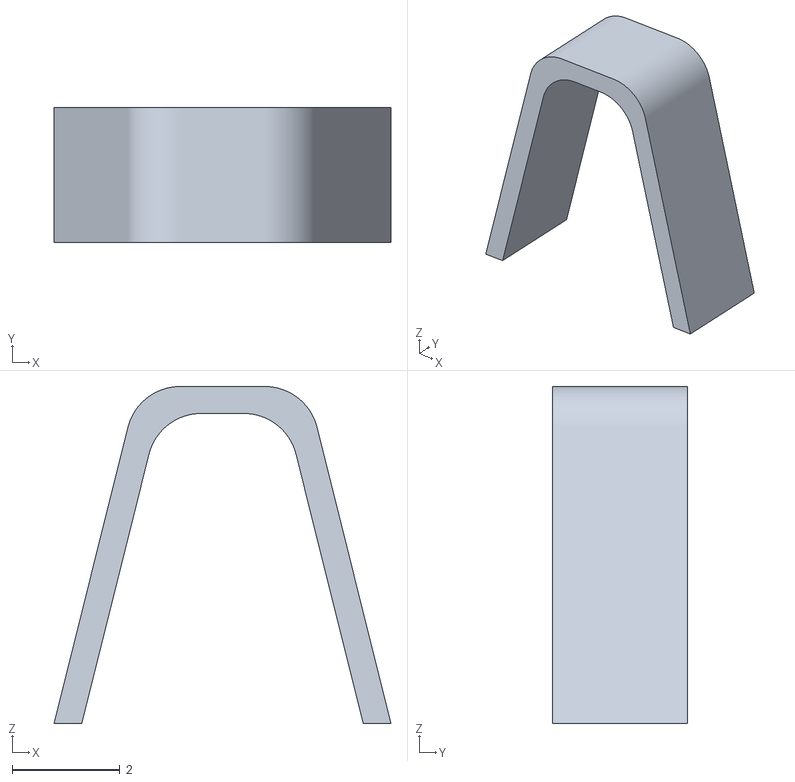
[picture p57: CAD file, 2022-07-21]
upper hull/stop for opened engine hatch.stl
6.25 x 2.50 x 6.25
