edumardo/VK-16.02-Leopard/turret/gun bracket x2.stl

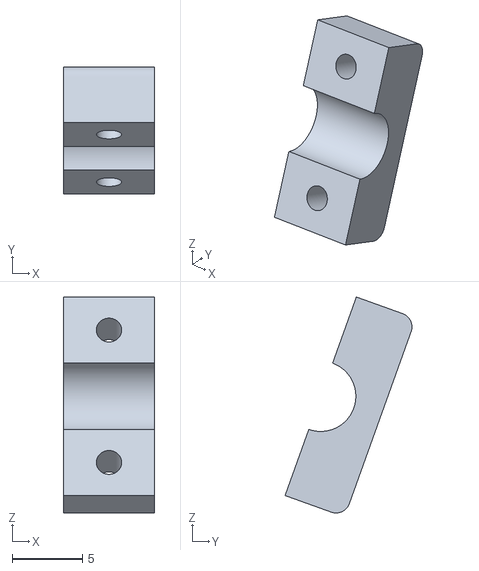
[picture p58: CAD file, 2022-11-24]
turret/gun bracket x2.stl
6.50 x 9.03 x 15.4
