edumardo/VK-16.02-Leopard/upper hull/fuel filler cap.stl

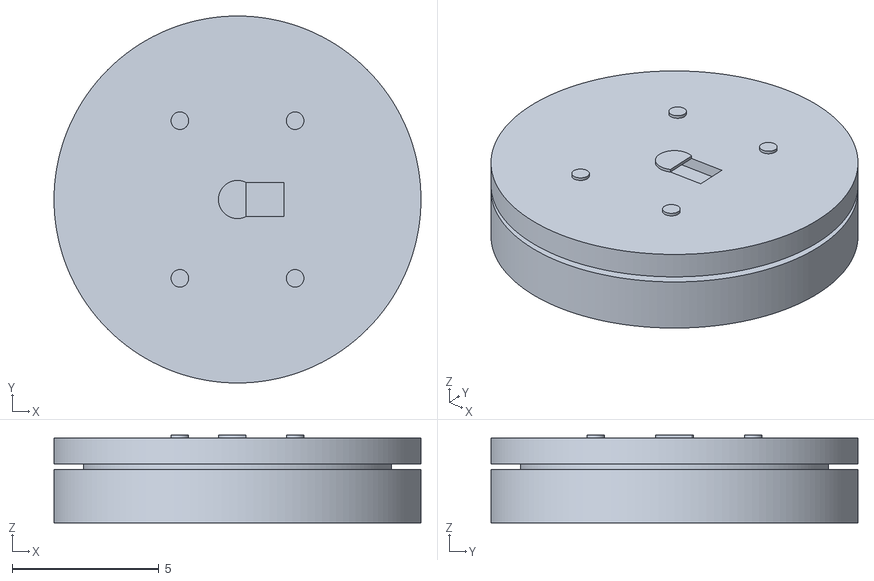
[picture p59: CAD file, 2022-07-21]
upper hull/fuel filler cap.stl
12.5 x 12.5 x 3.00
