edumardo/VK-16.02-Leopard/turret/turret rear.stl

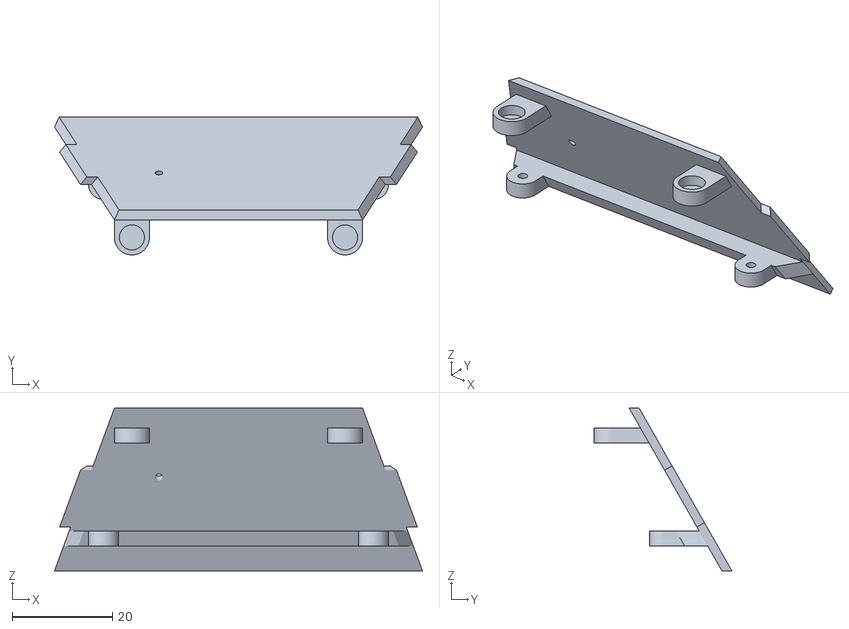
[picture p60: CAD file, 2022-11-24]
turret/turret rear.stl
73.4 x 27.5 x 32.5
