edumardo/VK-16.02-Leopard/upper hull/glacis.stl

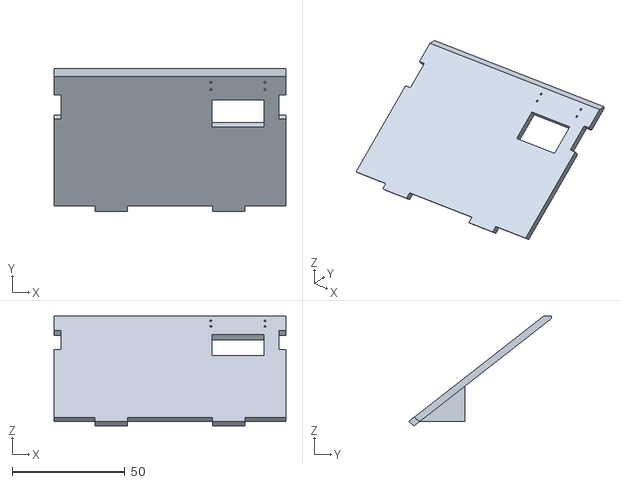
[picture p61: CAD file, 2022-07-21]
upper hull/glacis.stl
102.8 x 63.2 x 48.6
