edumardo/VK-16.02-Leopard/turret/periscope armor guard x2.stl

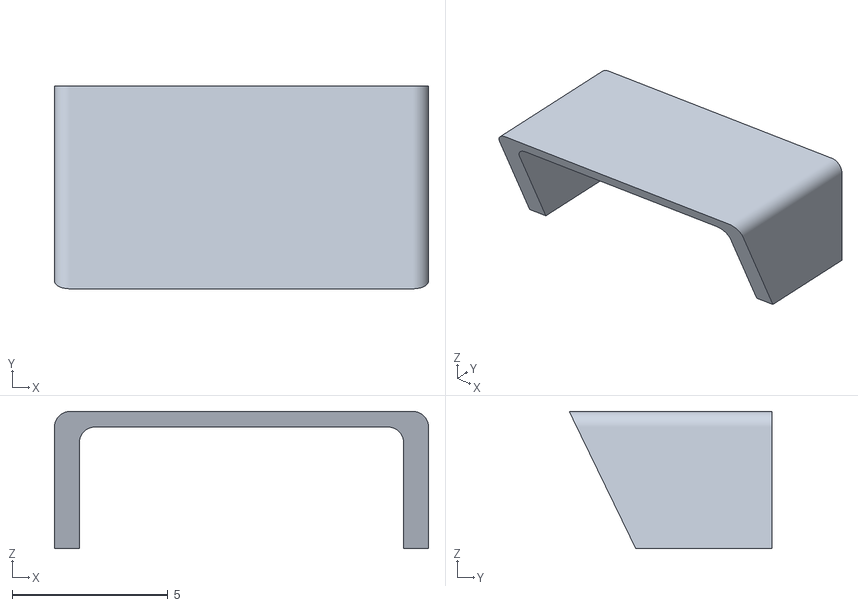
[picture p62: CAD file, 2022-11-24]
turret/periscope armor guard x2.stl
12.0 x 6.50 x 4.40
