edumardo/VK-16.02-Leopard/upper hull/deck D.stl

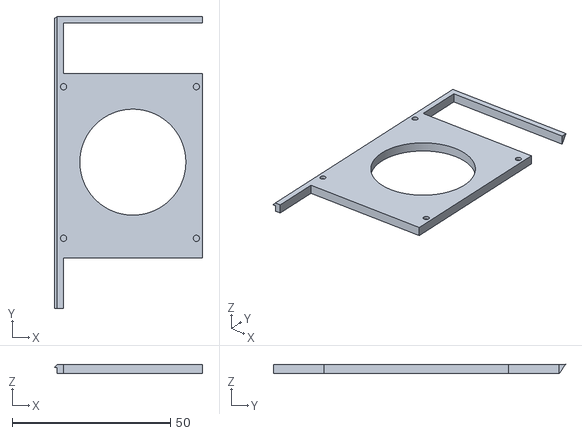
[picture p63: CAD file, 2022-07-21]
upper hull/deck D.stl
46.9 x 92.3 x 3.00
