edumardo/VK-16.02-Leopard/upper hull/hull left little.stl

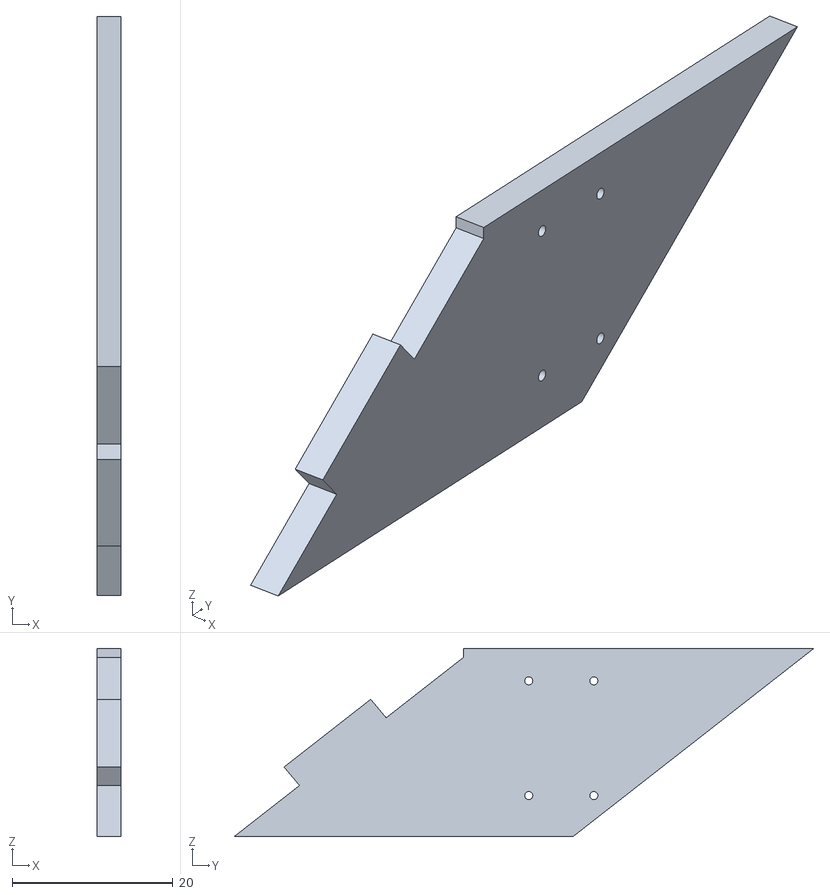
[picture p64: CAD file, 2022-07-21]
upper hull/hull left little.stl
3.00 x 72.2 x 23.4
