edumardo/VK-16.02-Leopard/turret/gun servo recoil arm.stl

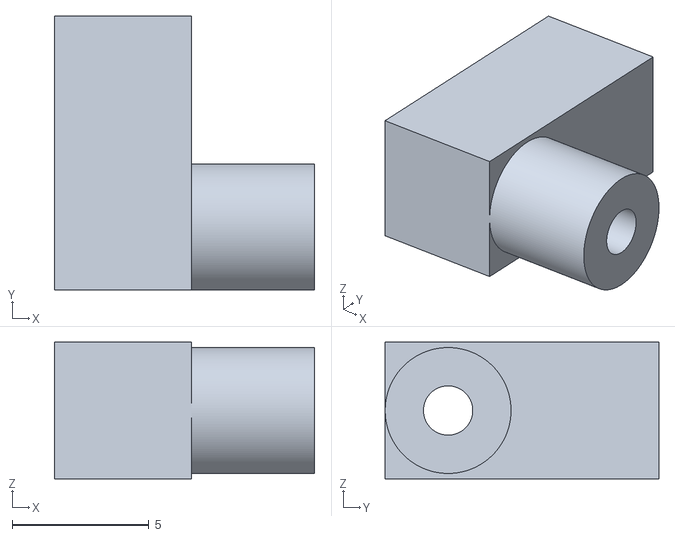
[picture p65: CAD file, 2022-11-24]
turret/gun servo recoil arm.stl
9.50 x 10.0 x 5.00
