edumardo/VK-16.02-Leopard/upper hull/engine hatch bumper.stl

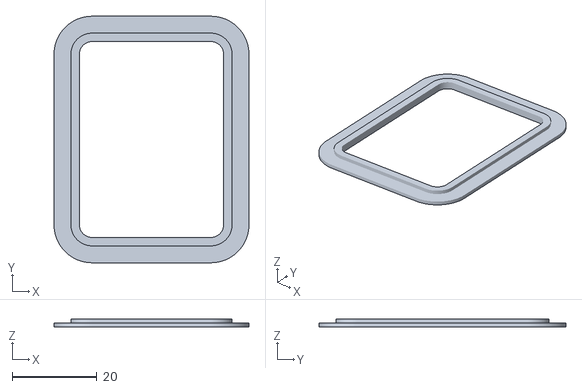
[picture p66: CAD file, 2022-07-21]
upper hull/engine hatch bumper.stl
46.1 x 58.3 x 2.00
