edumardo/VK-16.02-Leopard/turret/gun mantlet.stl

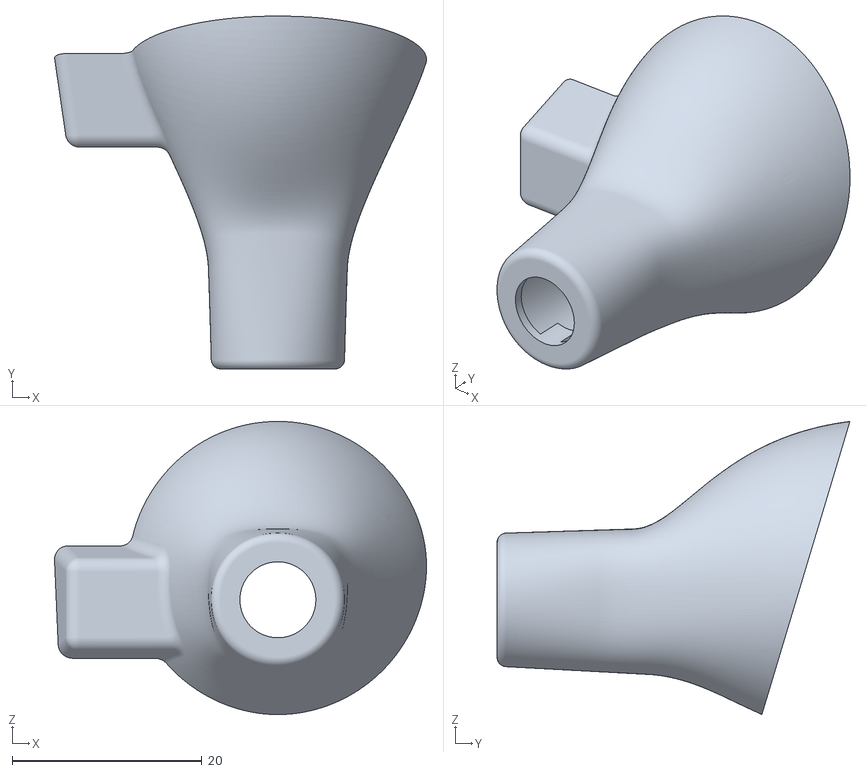
[picture p67: CAD file, 2022-11-24]
turret/gun mantlet.stl
39.2 x 37.2 x 30.9
