edumardo/VK-16.02-Leopard/turret/turret hatch 2.stl

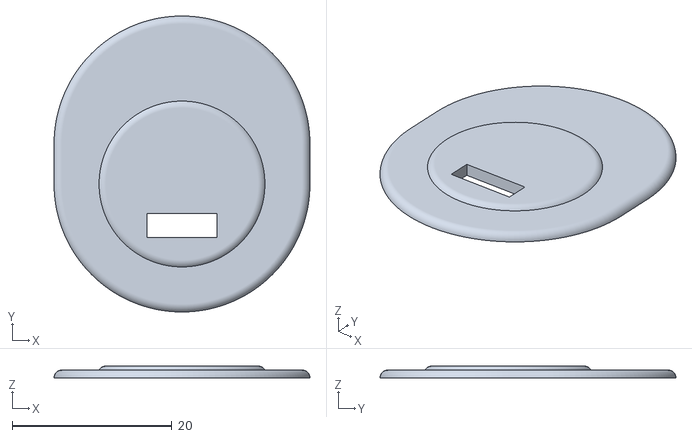
[picture p68: CAD file, 2022-11-24]
turret/turret hatch 2.stl
32.0 x 37.0 x 1.50
