edumardo/VK-16.02-Leopard/upper hull/coolant filler cap.stl

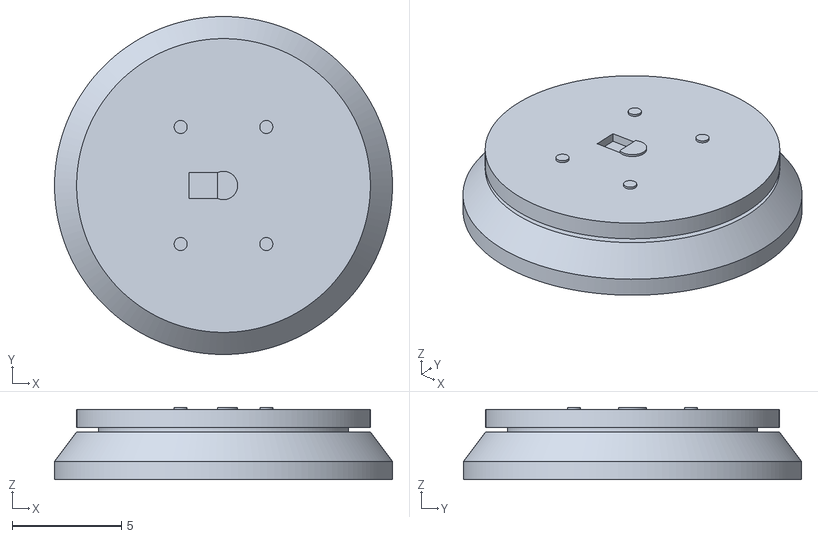
[picture p69: CAD file, 2022-07-21]
upper hull/coolant filler cap.stl
15.5 x 15.5 x 3.32
