edumardo/VK-16.02-Leopard/turret/big hook x3.stl

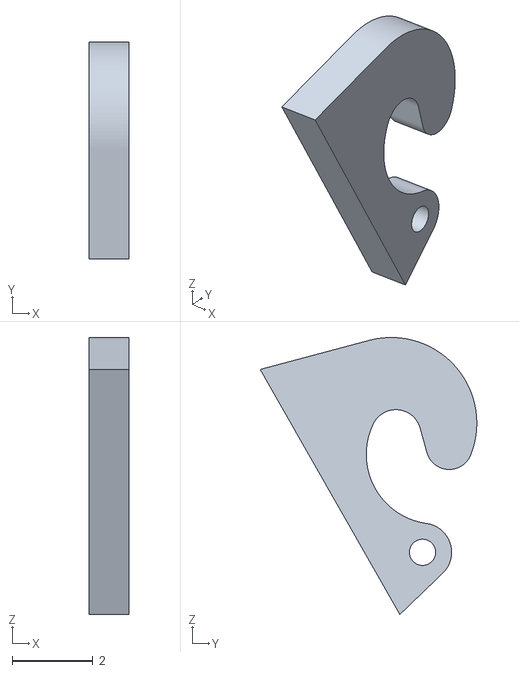
[picture p71: CAD file, 2022-11-24]
turret/big hook x3.stl
1.00 x 5.38 x 6.87
