edumardo/VK-16.02-Leopard/upper hull/big hook x6.stl

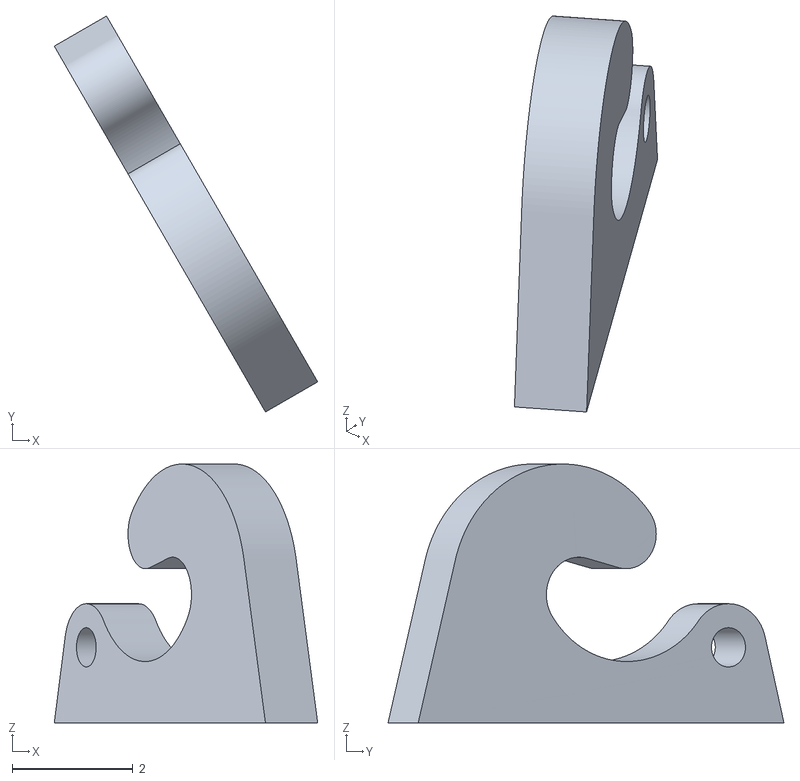
[picture p72: CAD file, 2022-07-21]
upper hull/big hook x6.stl
4.37 x 6.56 x 4.29
