edumardo/VK-16.02-Leopard/turret/servo elevation fixer left.stl

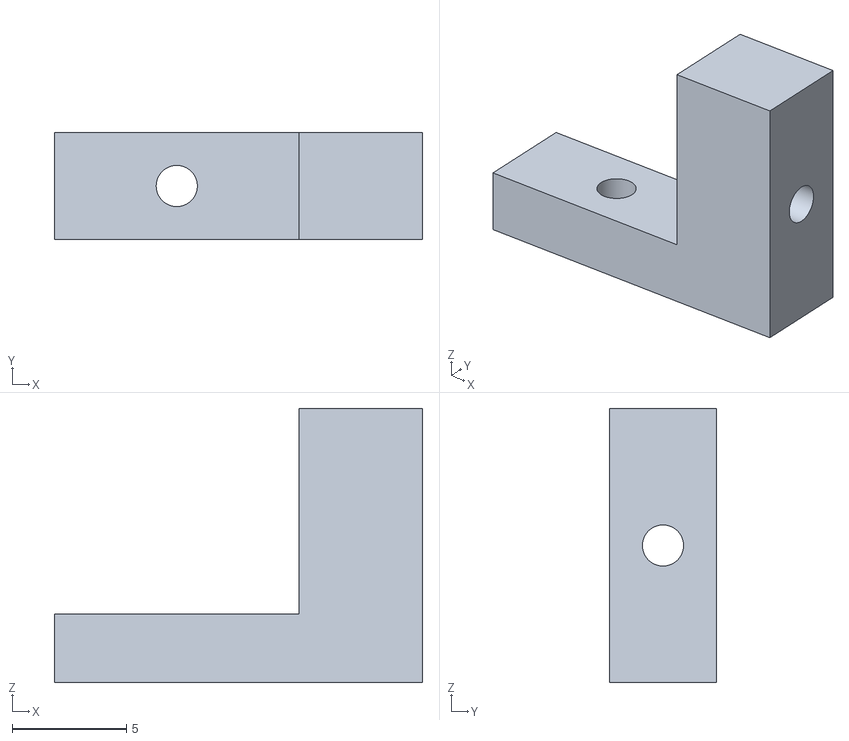
[picture p73: CAD file, 2022-11-24]
turret/servo elevation fixer left.stl
16.1 x 4.70 x 12.0
