edumardo/VK-16.02-Leopard/upper hull/deck B.stl

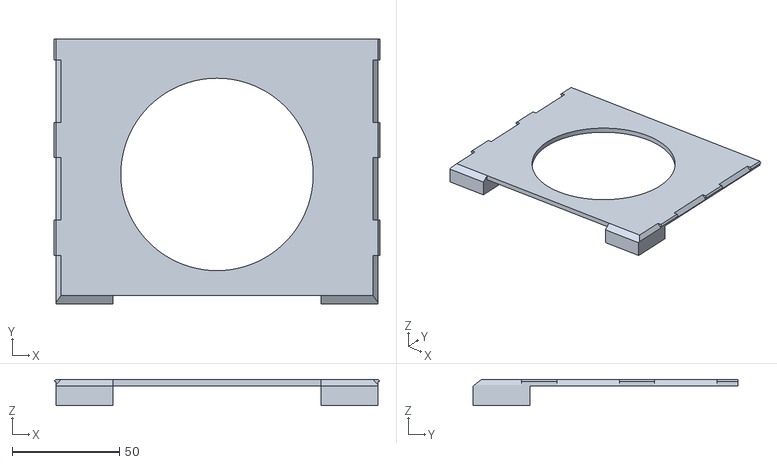
[picture p74: CAD file, 2022-07-21]
upper hull/deck B.stl
151.7 x 123.1 x 12.2
