edumardo/VK-16.02-Leopard/turret/rotation servo bracket 1.stl

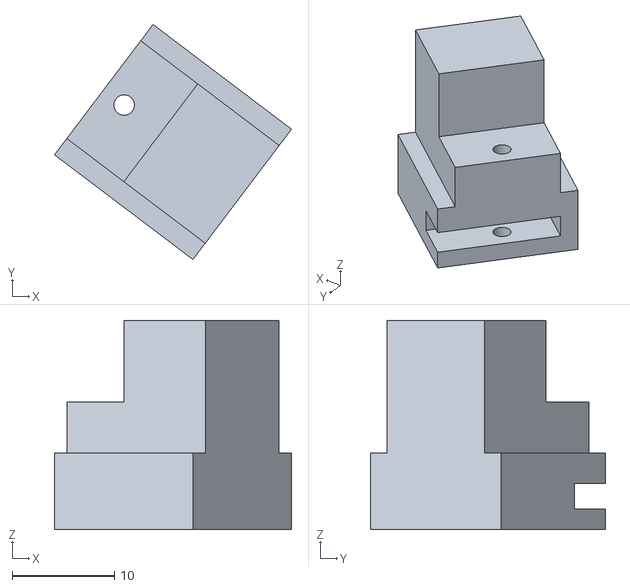
[picture p75: CAD file, 2022-11-24]
turret/rotation servo bracket 1.stl
23.2 x 23.0 x 20.5
