edumardo/VK-16.02-Leopard/turret/gun barrel.stl

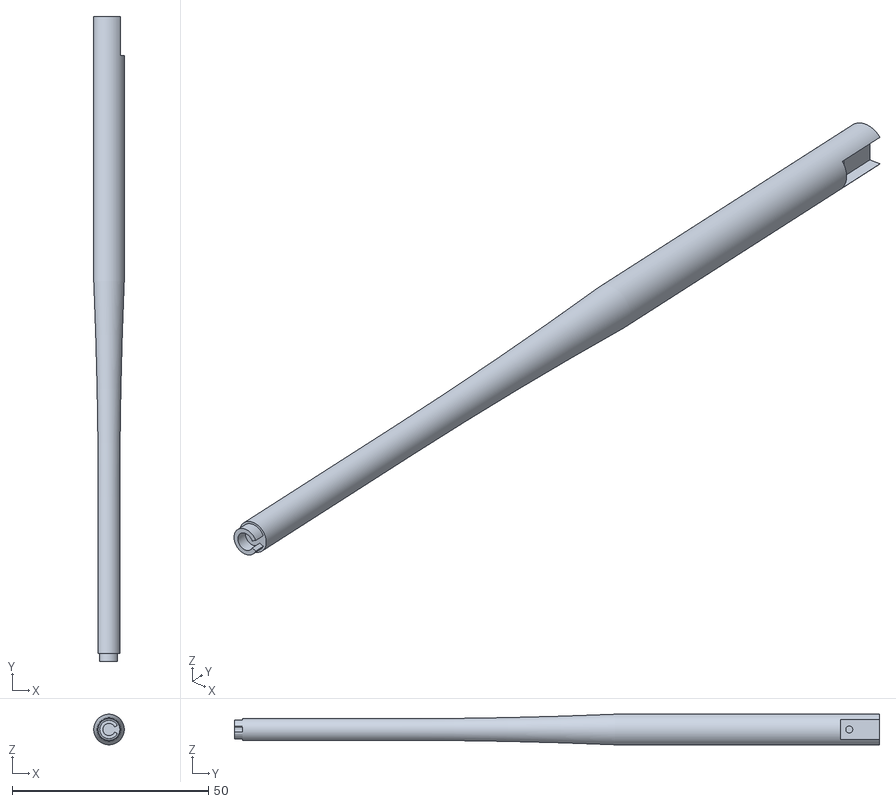
[picture p76: CAD file, 2022-11-24]
turret/gun barrel.stl
7.80 x 164.3 x 7.80
