edumardo/VK-16.02-Leopard/upper hull/deck E.stl

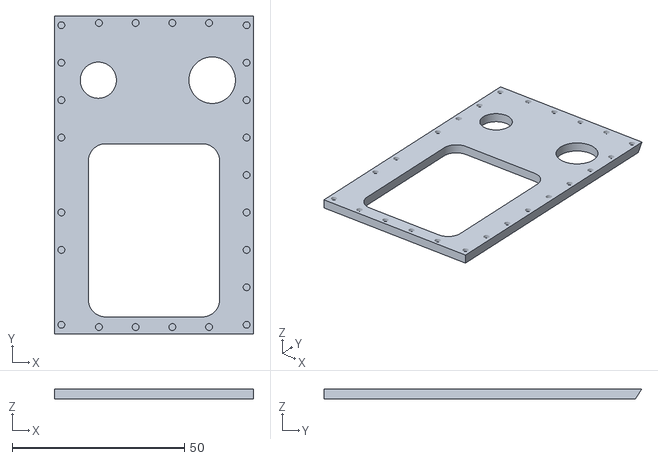
[picture p77: CAD file, 2022-07-21]
upper hull/deck E.stl
57.8 x 92.3 x 3.00
