edumardo/VK-16.02-Leopard/turret/gunner sight.stl

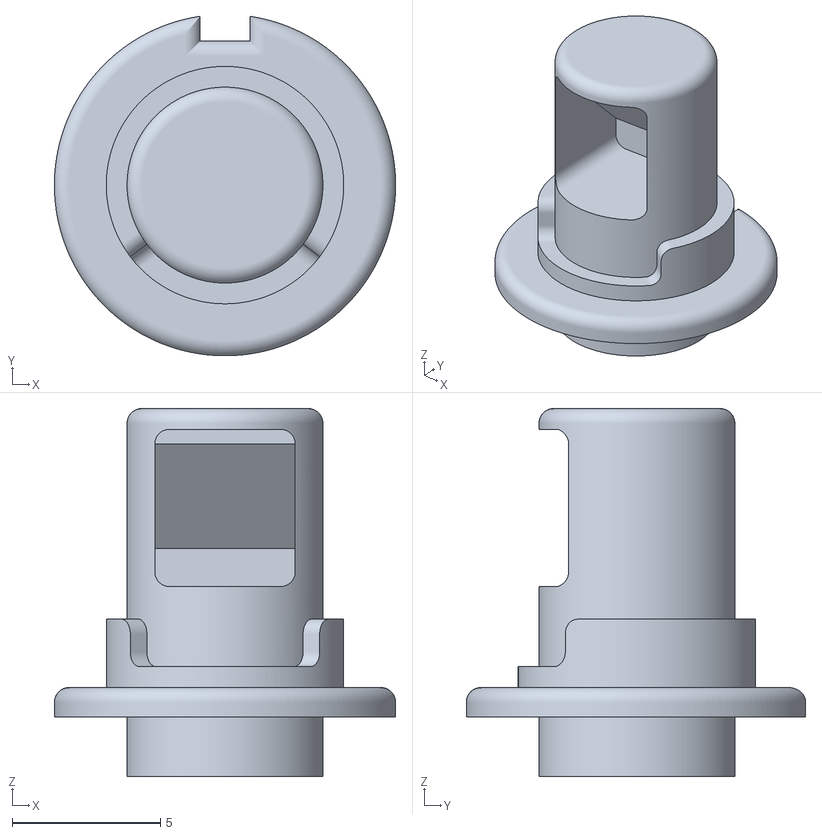
[picture p78: CAD file, 2022-11-24]
turret/gunner sight.stl
11.5 x 11.4 x 12.4
