edumardo/VK-16.02-Leopard/upper hull/driver vision port.stl

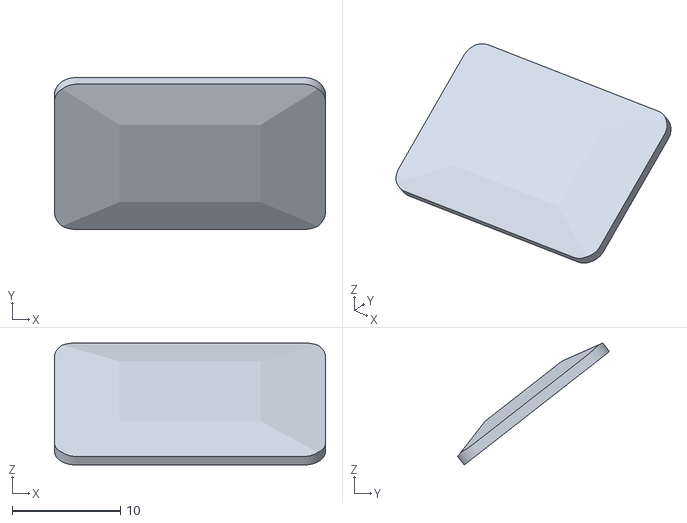
[picture p79: CAD file, 2022-07-21]
upper hull/driver vision port.stl
25.0 x 14.0 x 11.3
