edumardo/VK-16.02-Leopard/turret/turret pistol port.stl

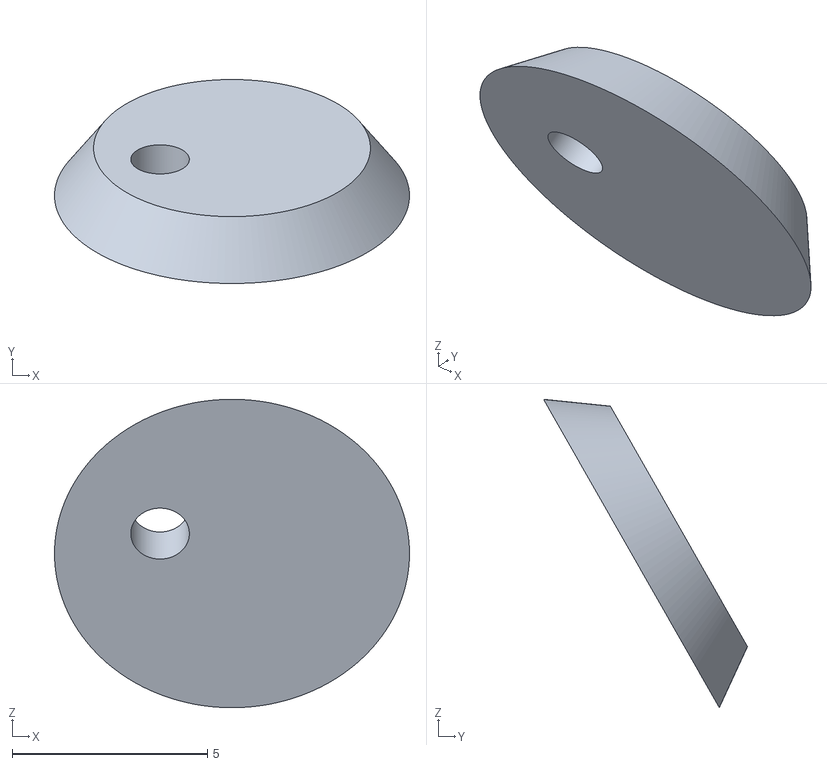
[picture p80: CAD file, 2022-11-24]
turret/turret pistol port.stl
9.08 x 5.22 x 7.89
