edumardo/VK-16.02-Leopard/upper hull/air intake x4.stl

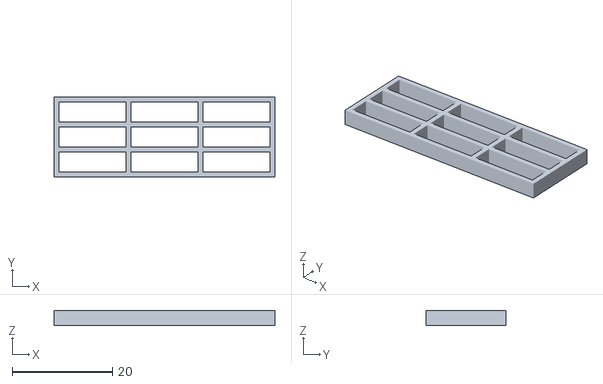
[picture p81: CAD file, 2022-07-21]
upper hull/air intake x4.stl
44.0 x 16.0 x 3.00
