edumardo/VK-16.02-Leopard/upper hull/periscope x2.stl

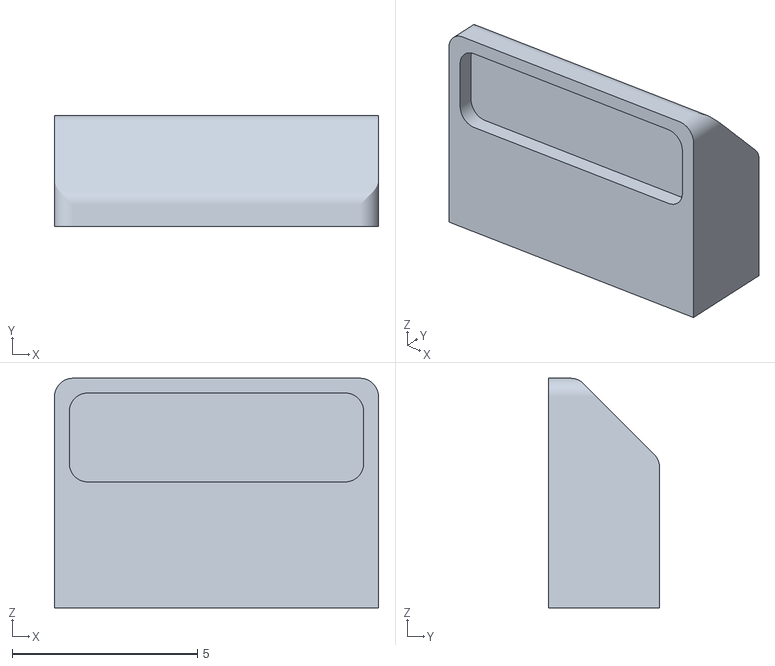
[picture p82: CAD file, 2022-07-21]
upper hull/periscope x2.stl
8.75 x 3.00 x 6.20
