edumardo/VK-16.02-Leopard/upper hull/air exhaust cover x2.stl

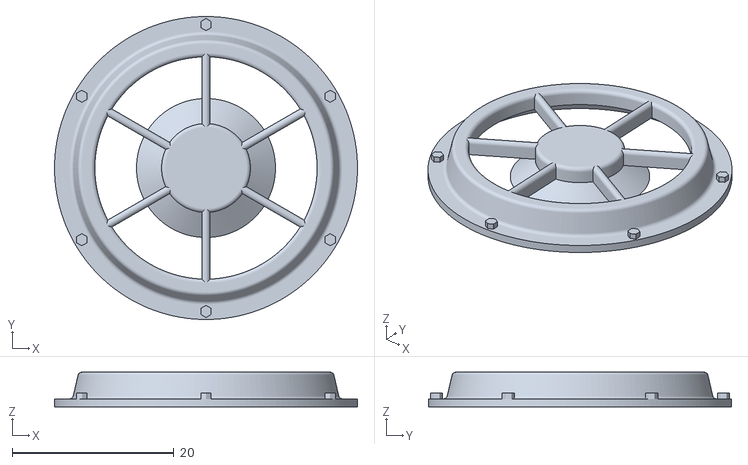
[picture p83: CAD file, 2022-07-21]
upper hull/air exhaust cover x2.stl
37.5 x 37.5 x 4.30
