edumardo/VK-16.02-Leopard/upper hull/air intake cover rear x2.stl

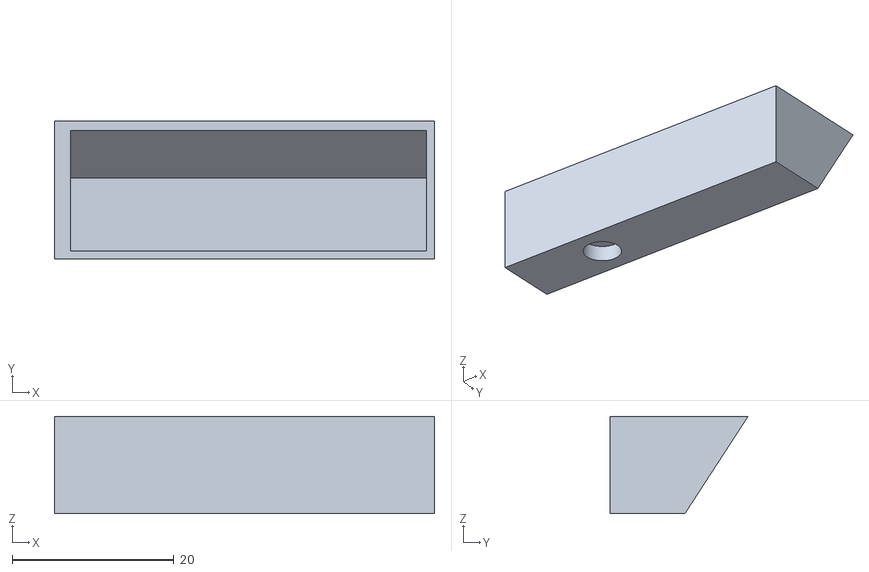
[picture p84: CAD file, 2022-07-21]
upper hull/air intake cover rear x2.stl
47.0 x 17.1 x 12.0
