edumardo/VK-16.02-Leopard/upper hull/engine hatch.stl

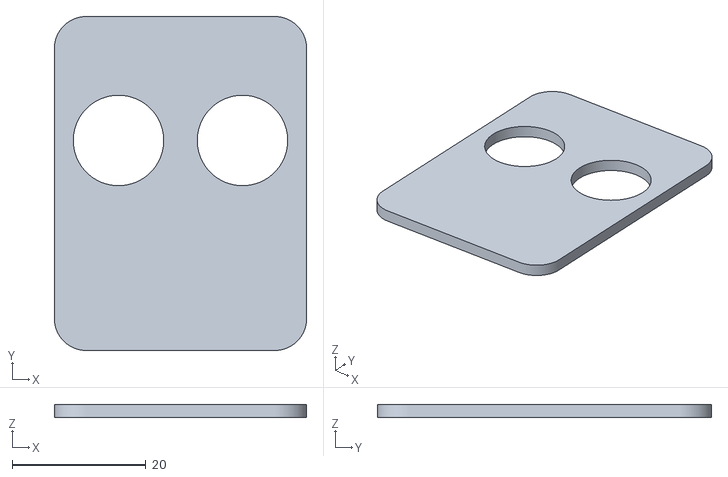
[picture p85: CAD file, 2022-07-21]
upper hull/engine hatch.stl
37.7 x 49.9 x 2.00
