edumardo/VK-16.02-Leopard/(list of files, cad)

Other CAD files:
suspension/swing arm support motor right.stl
rear stuff/rear stowage bin left.stl
suspension/idler arm right.stl
upper hull/driver hatch.stl
hull/hull left.stl
hull/pannier left.stl
suspension/transmission cover right.stl
suspension/swing arm support left x4.stl
rear stuff/exhaust bracket outer left.stl
suspension/swing arm support right x4.stl
hull/pannier left extra.stl
rear stuff/exhaust pipe v2 right.stl
hull/transmission cover left.stl
rear stuff/rear big cover.stl
turret/turret left.stl
upper hull/upper hull left.stl
upper hull/glacis right.stl
upper hull/deck C.stl
upper hull/hull right little.stl
upper hull/extra side right.stl
upper hull/fender right.stl
