edumardo/VK-16.02-Leopard/hull/hull assembly.png

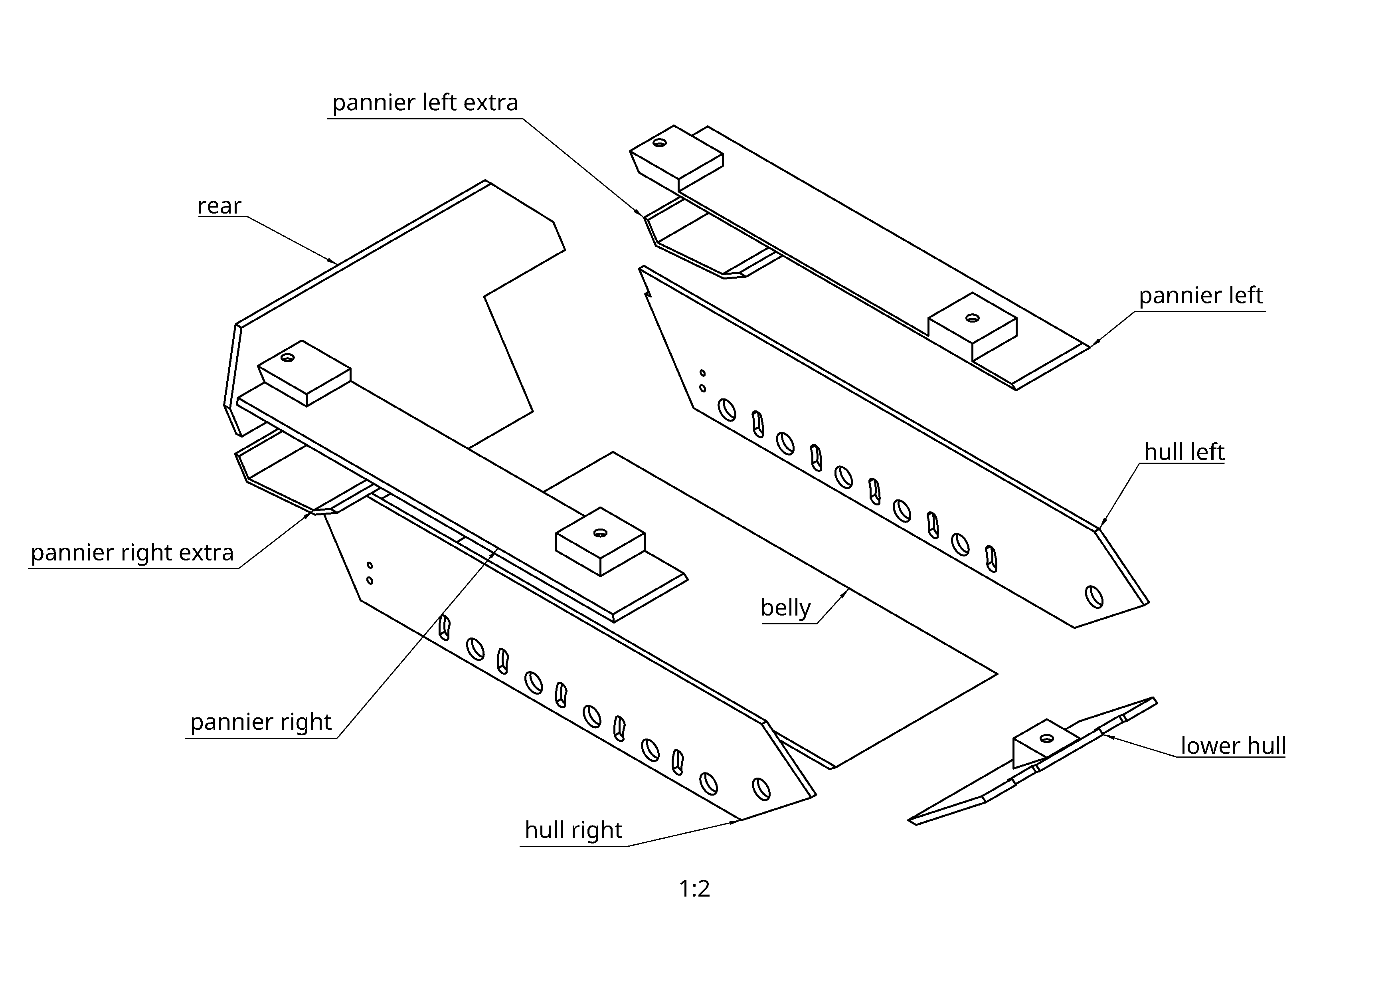
hull/hull assembly.png
