edumardo/VK-16.02-Leopard/rear stuff/rear stuff assembly.png

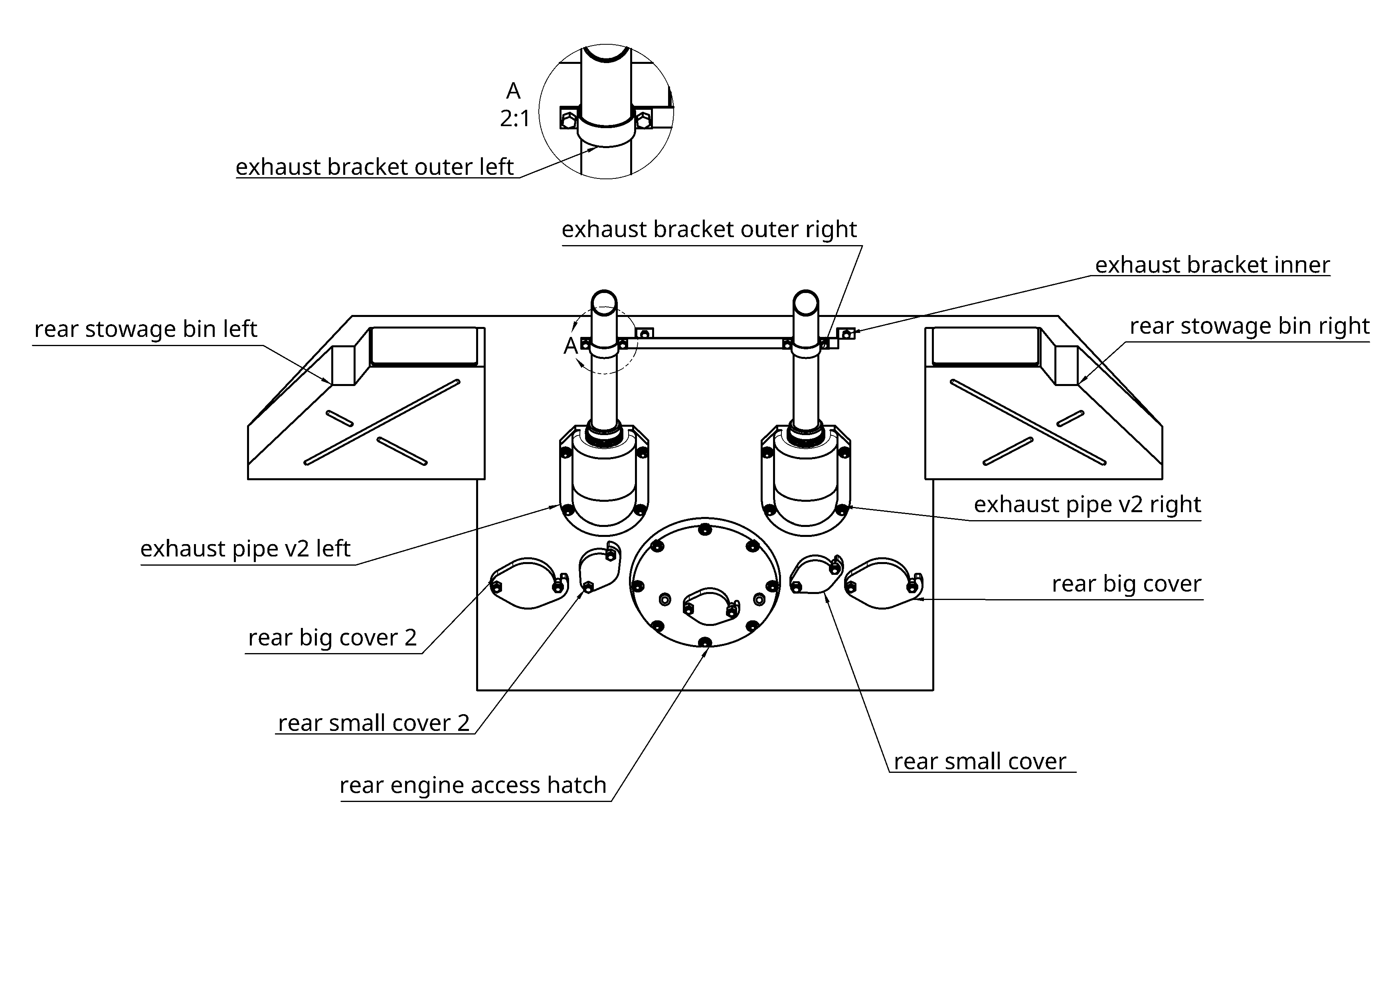
rear stuff/rear stuff assembly.png
