edumardo/VK-16.02-Leopard/suspension/suspension assembly.png

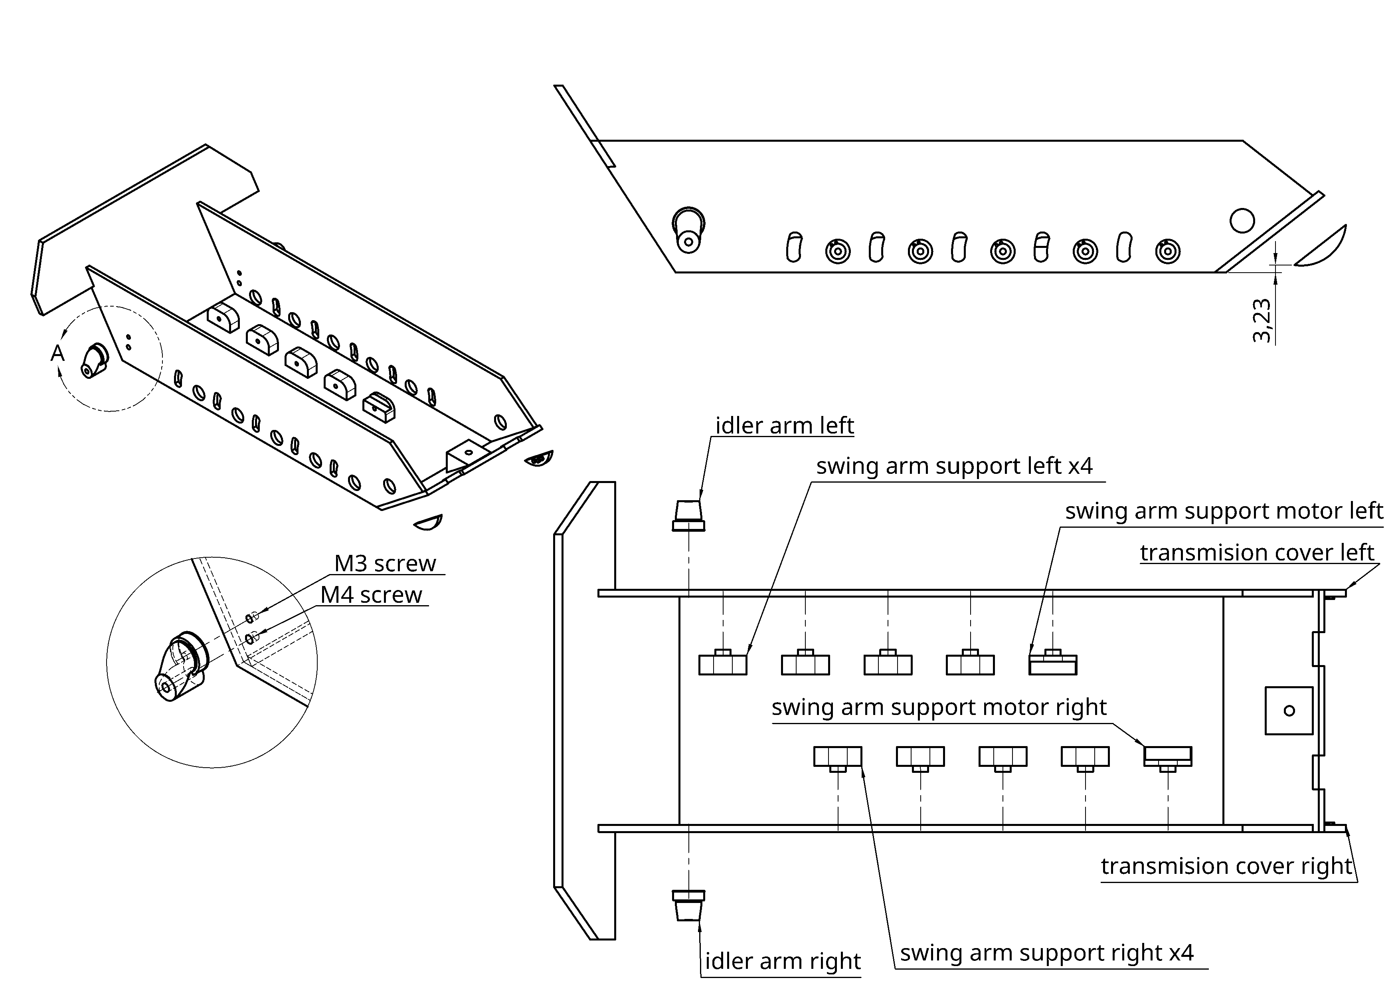
suspension/suspension assembly.png
