edumardo/VK-16.02-Leopard/turret/turret assembly 1.png

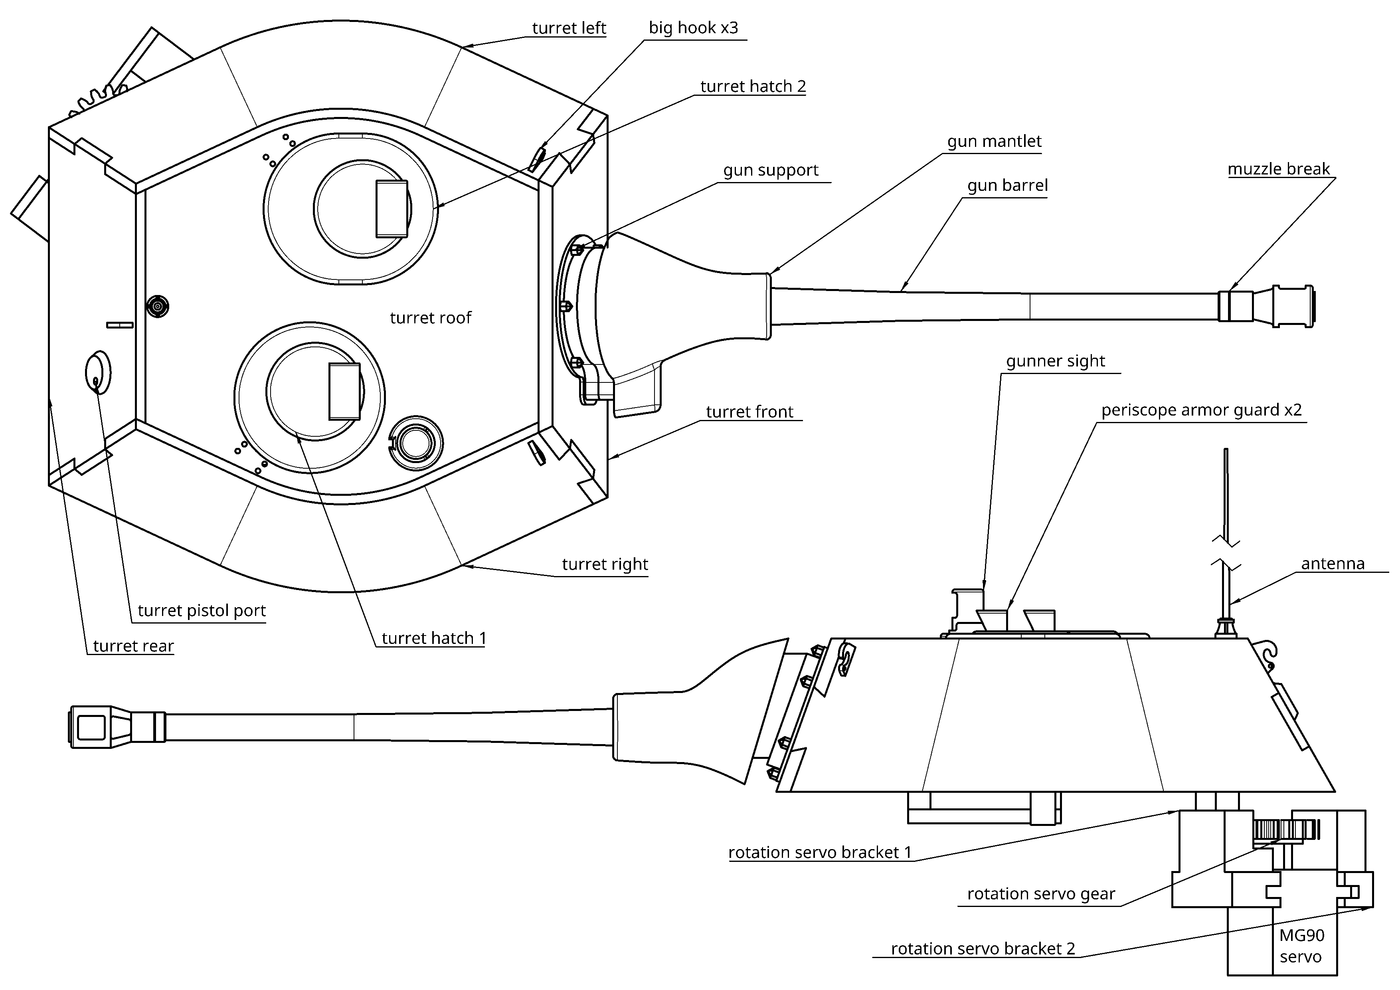
turret/turret assembly 1.png
