edumardo/VK-16.02-Leopard/turret/turret assembly 2.png

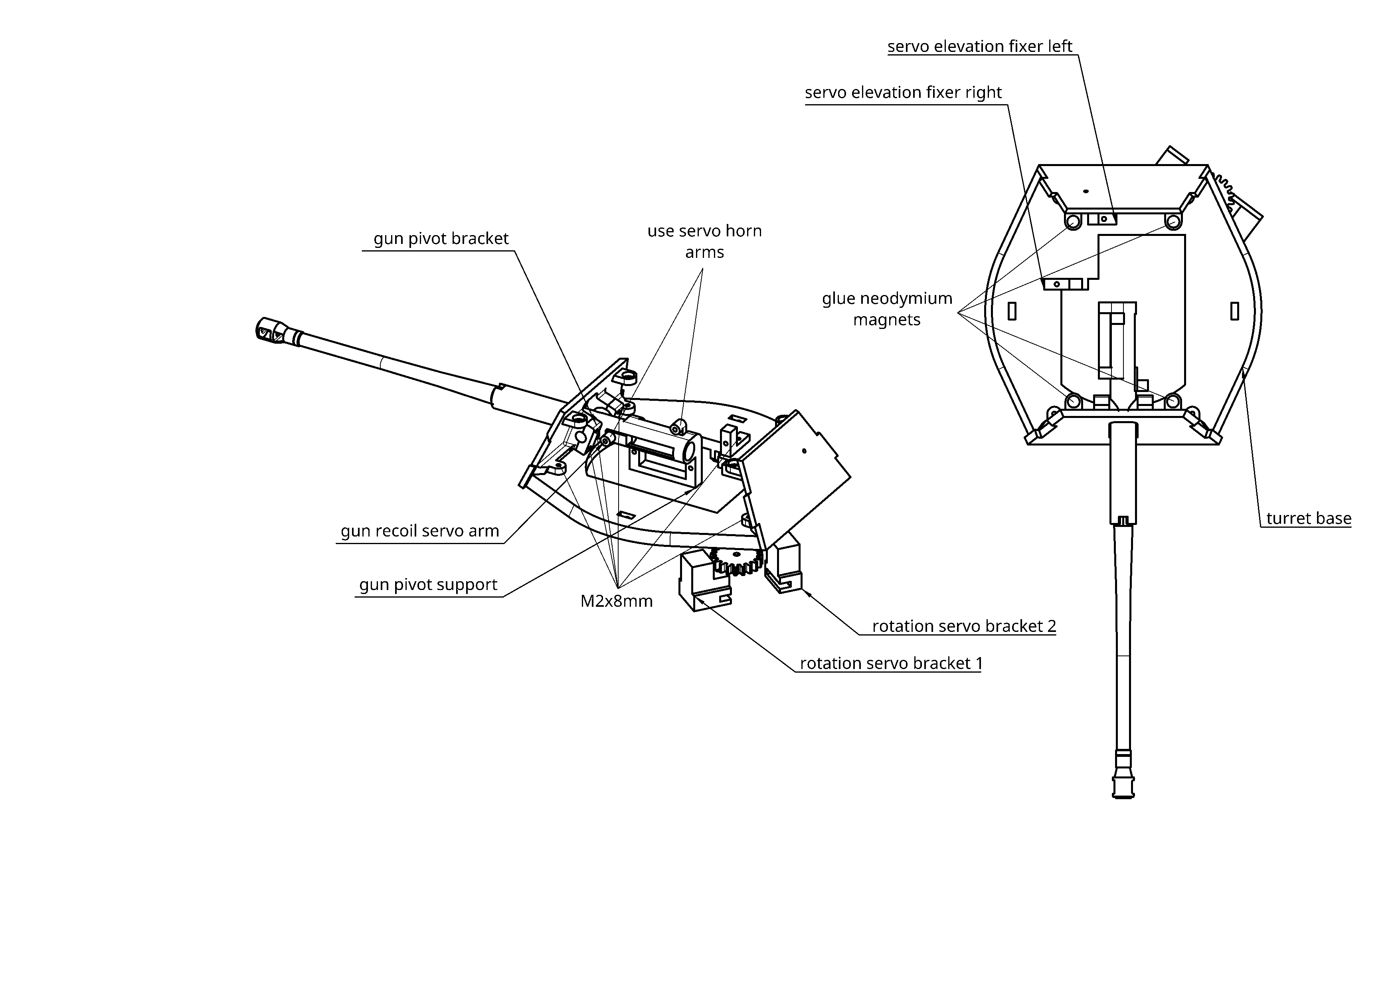
turret/turret assembly 2.png
