edumardo/VK-16.02-Leopard/upper hull/upper hull assembly 1.png

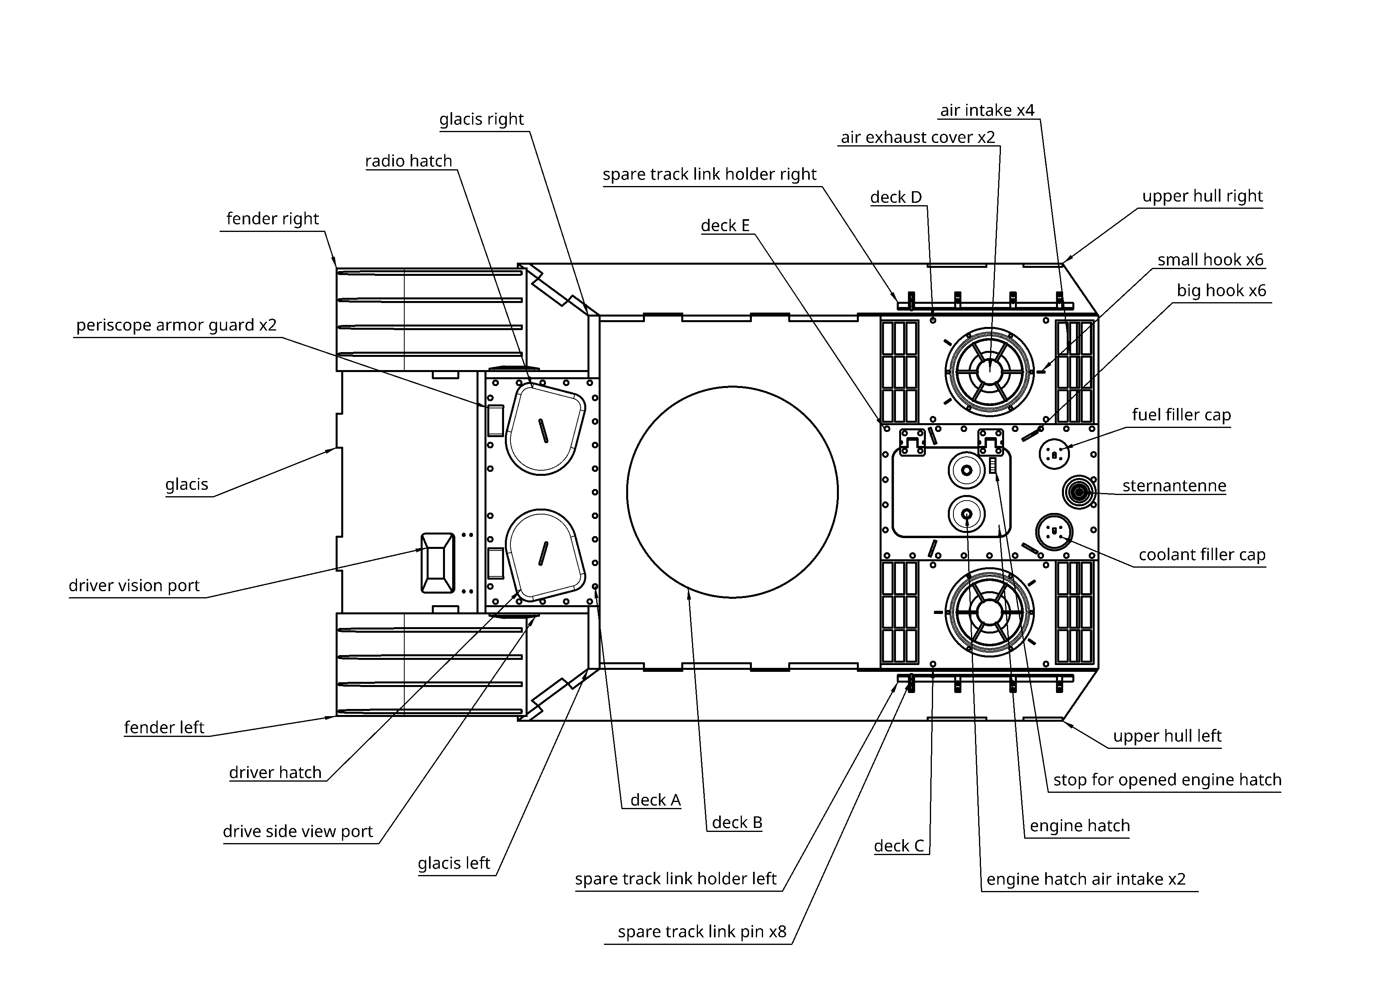
upper hull/upper hull assembly 1.png
