edumardo/VK-16.02-Leopard/turret/turret assembly 2.pdf

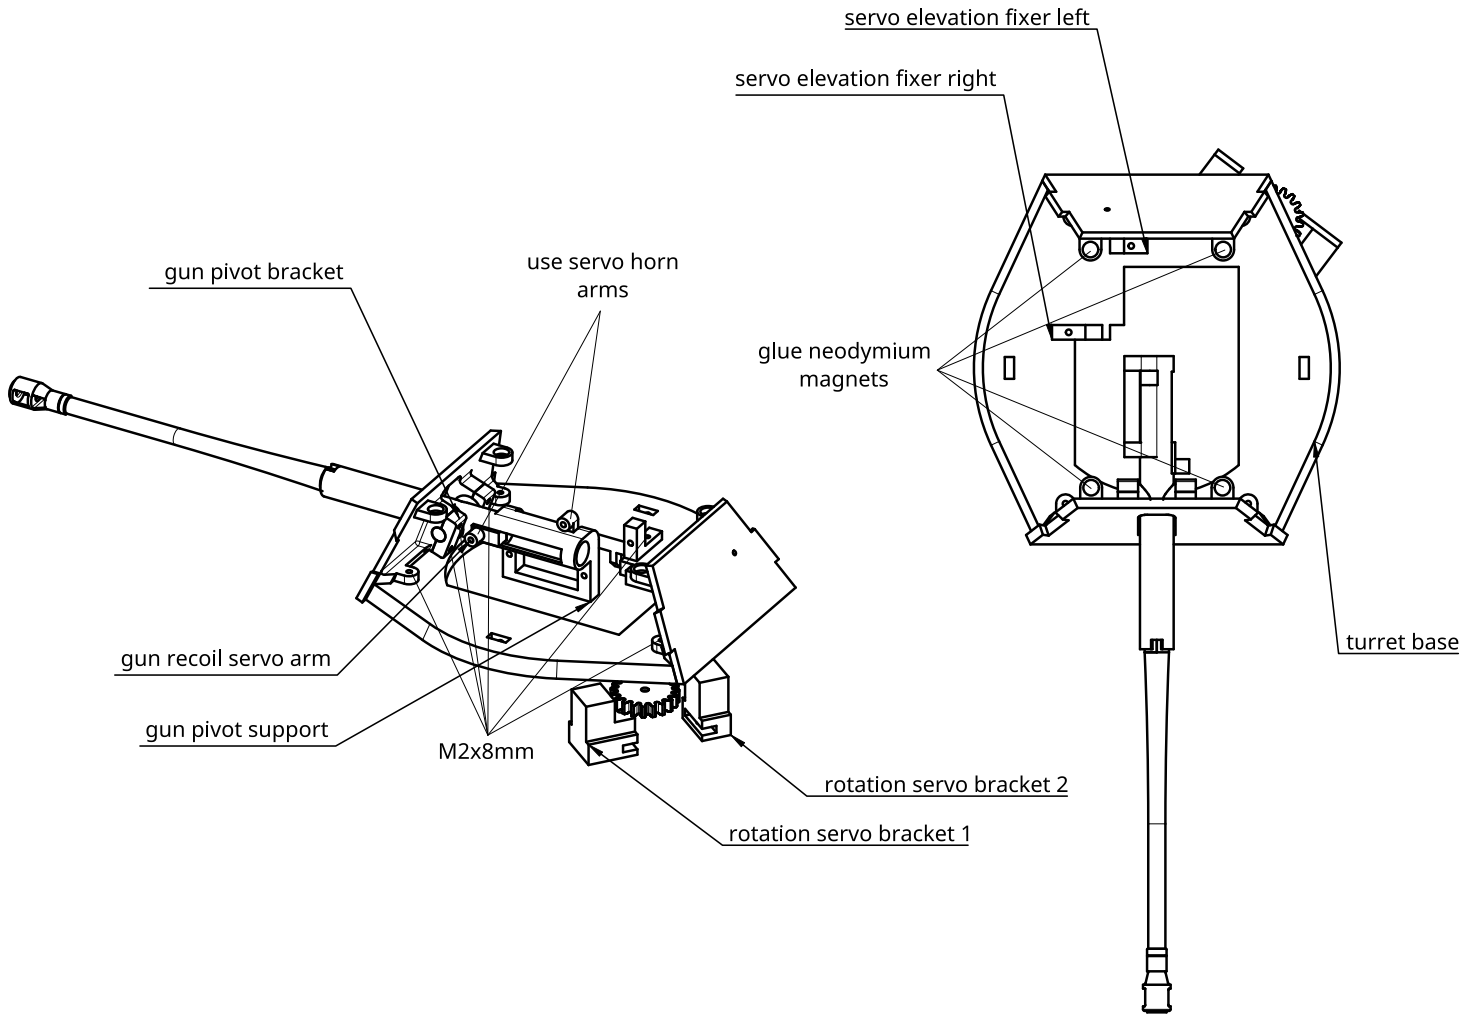
[picture p93: page 1]
