edumardo/VK-16.02-Leopard/turret/turret assembly 1.pdf

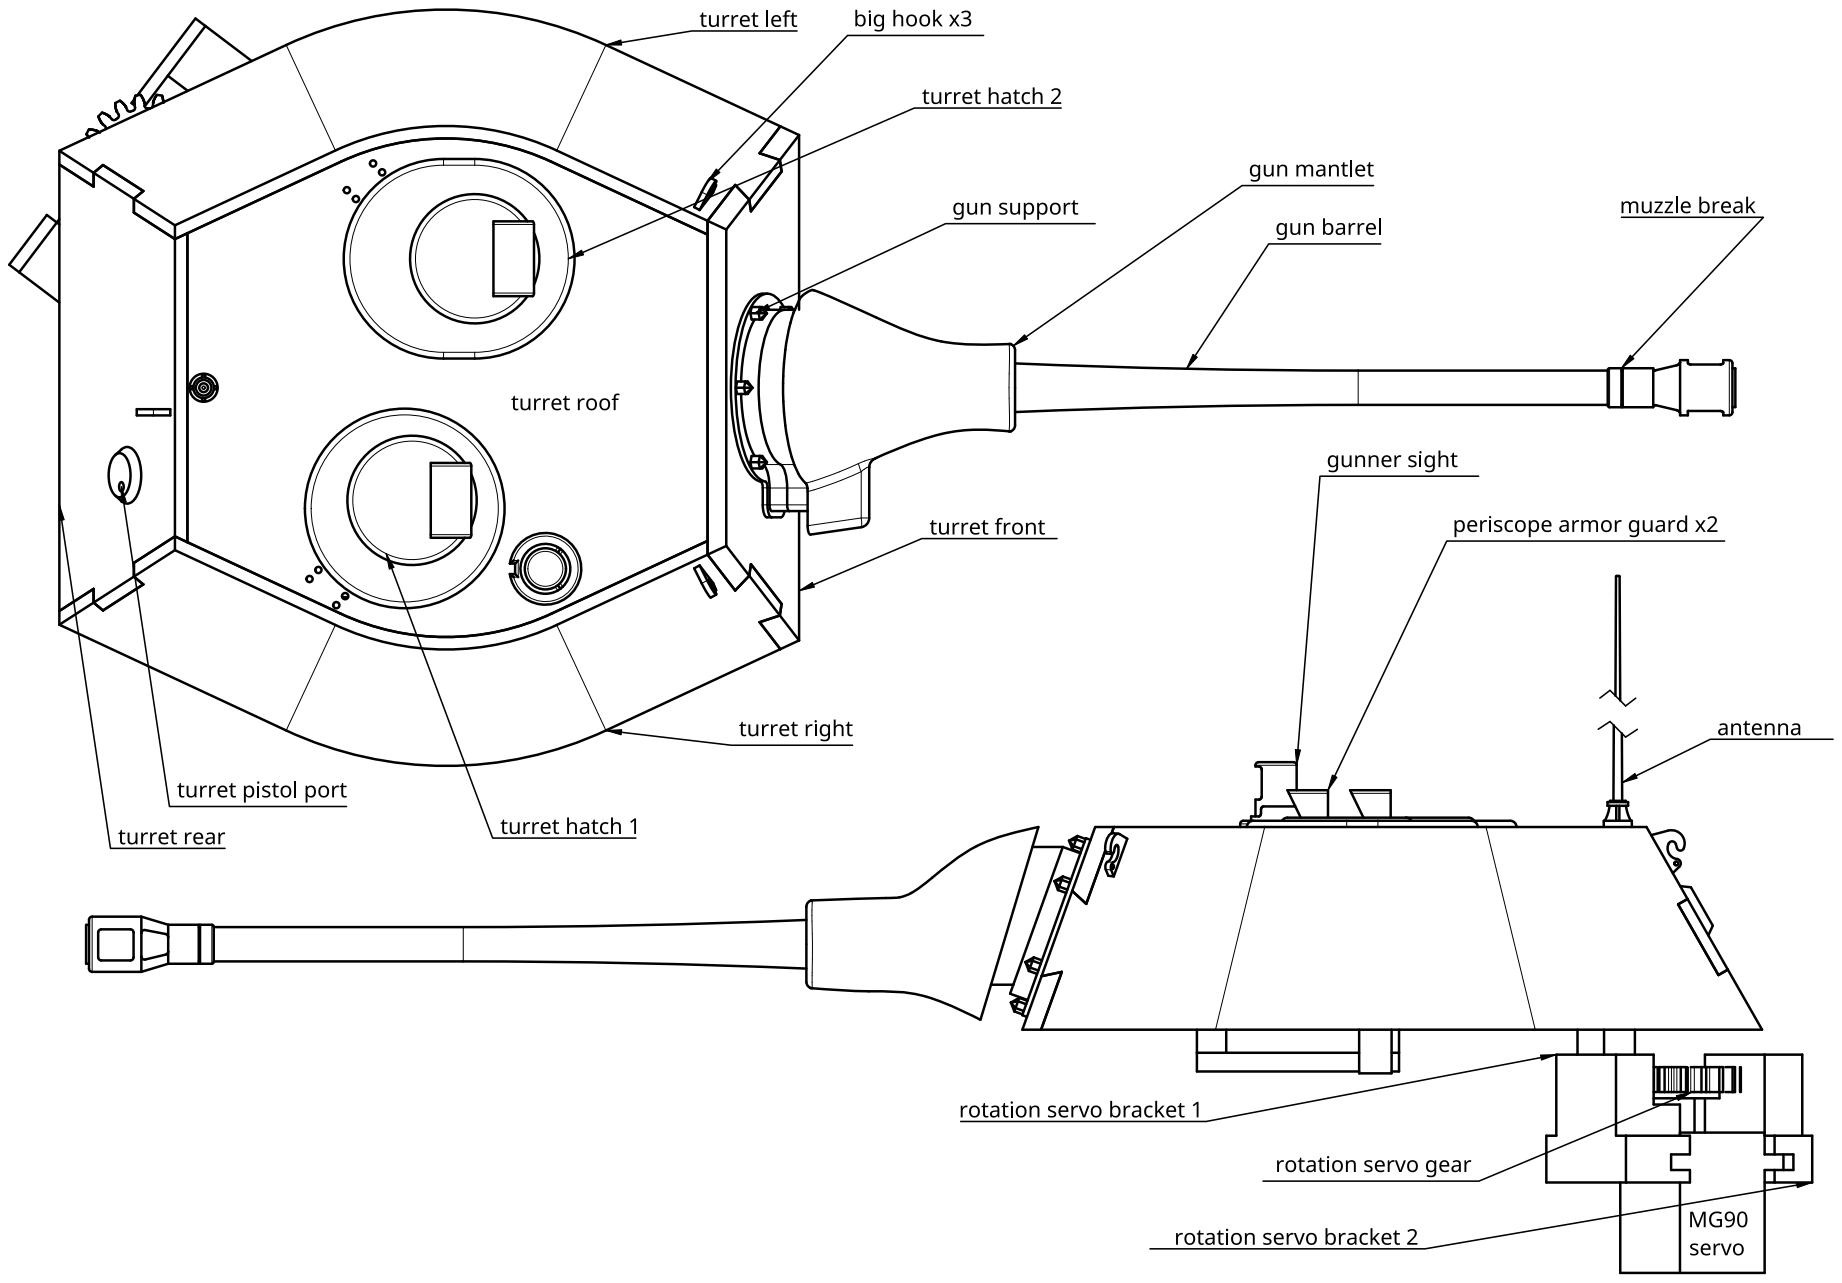
[picture p94: page 1]
