edumardo/VK-16.02-Leopard/turret/turret assembly.pdf

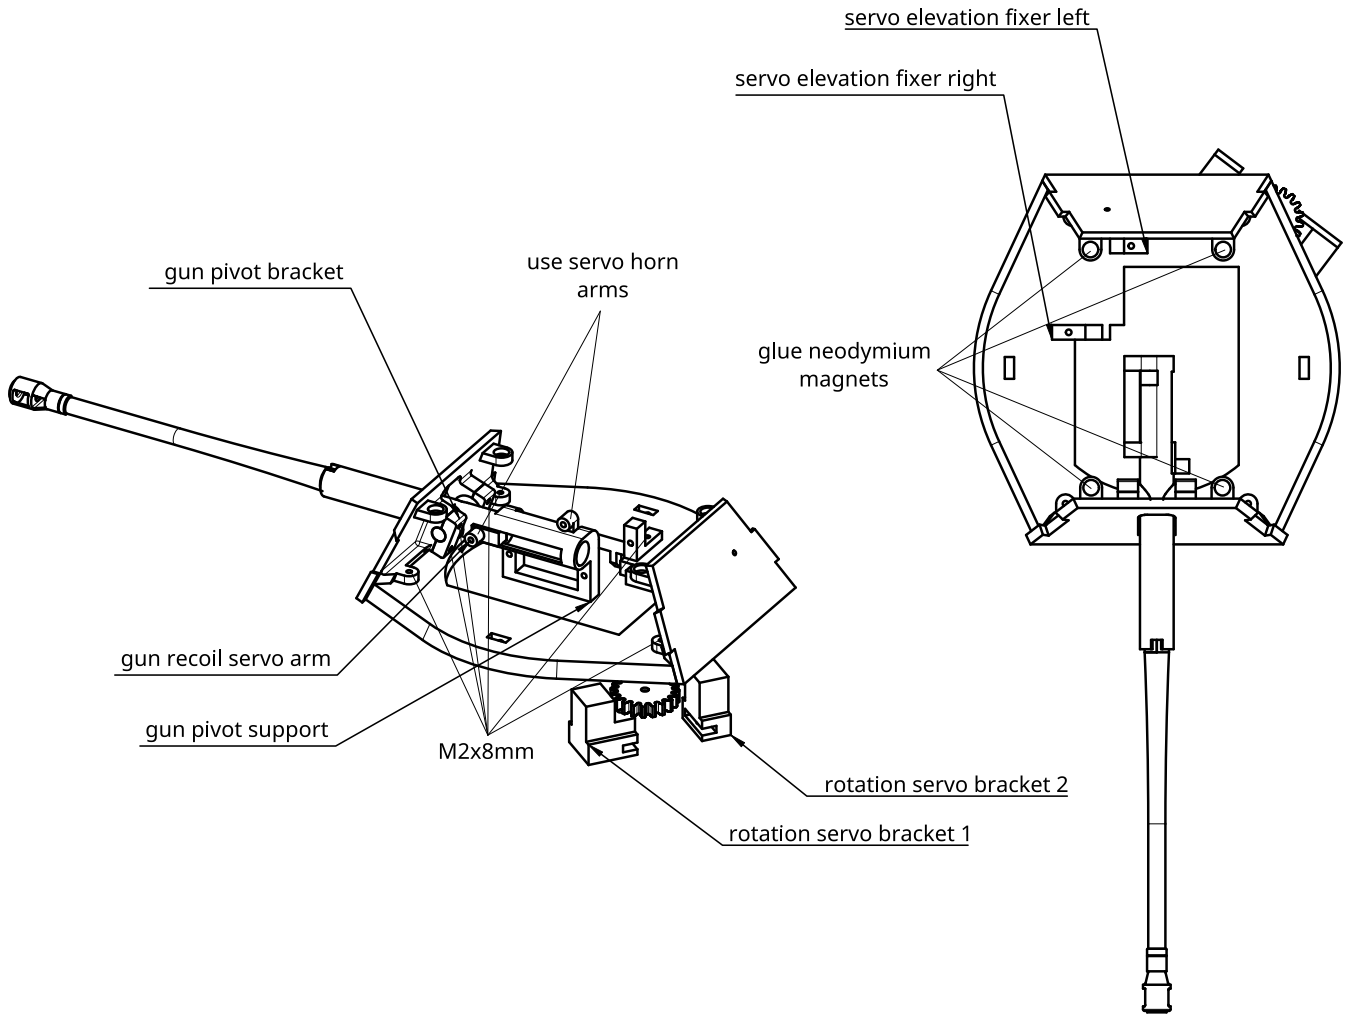
[picture p95: page 2]
