edumardo/VK-16.02-Leopard/upper hull/upper hull assembly 1.pdf

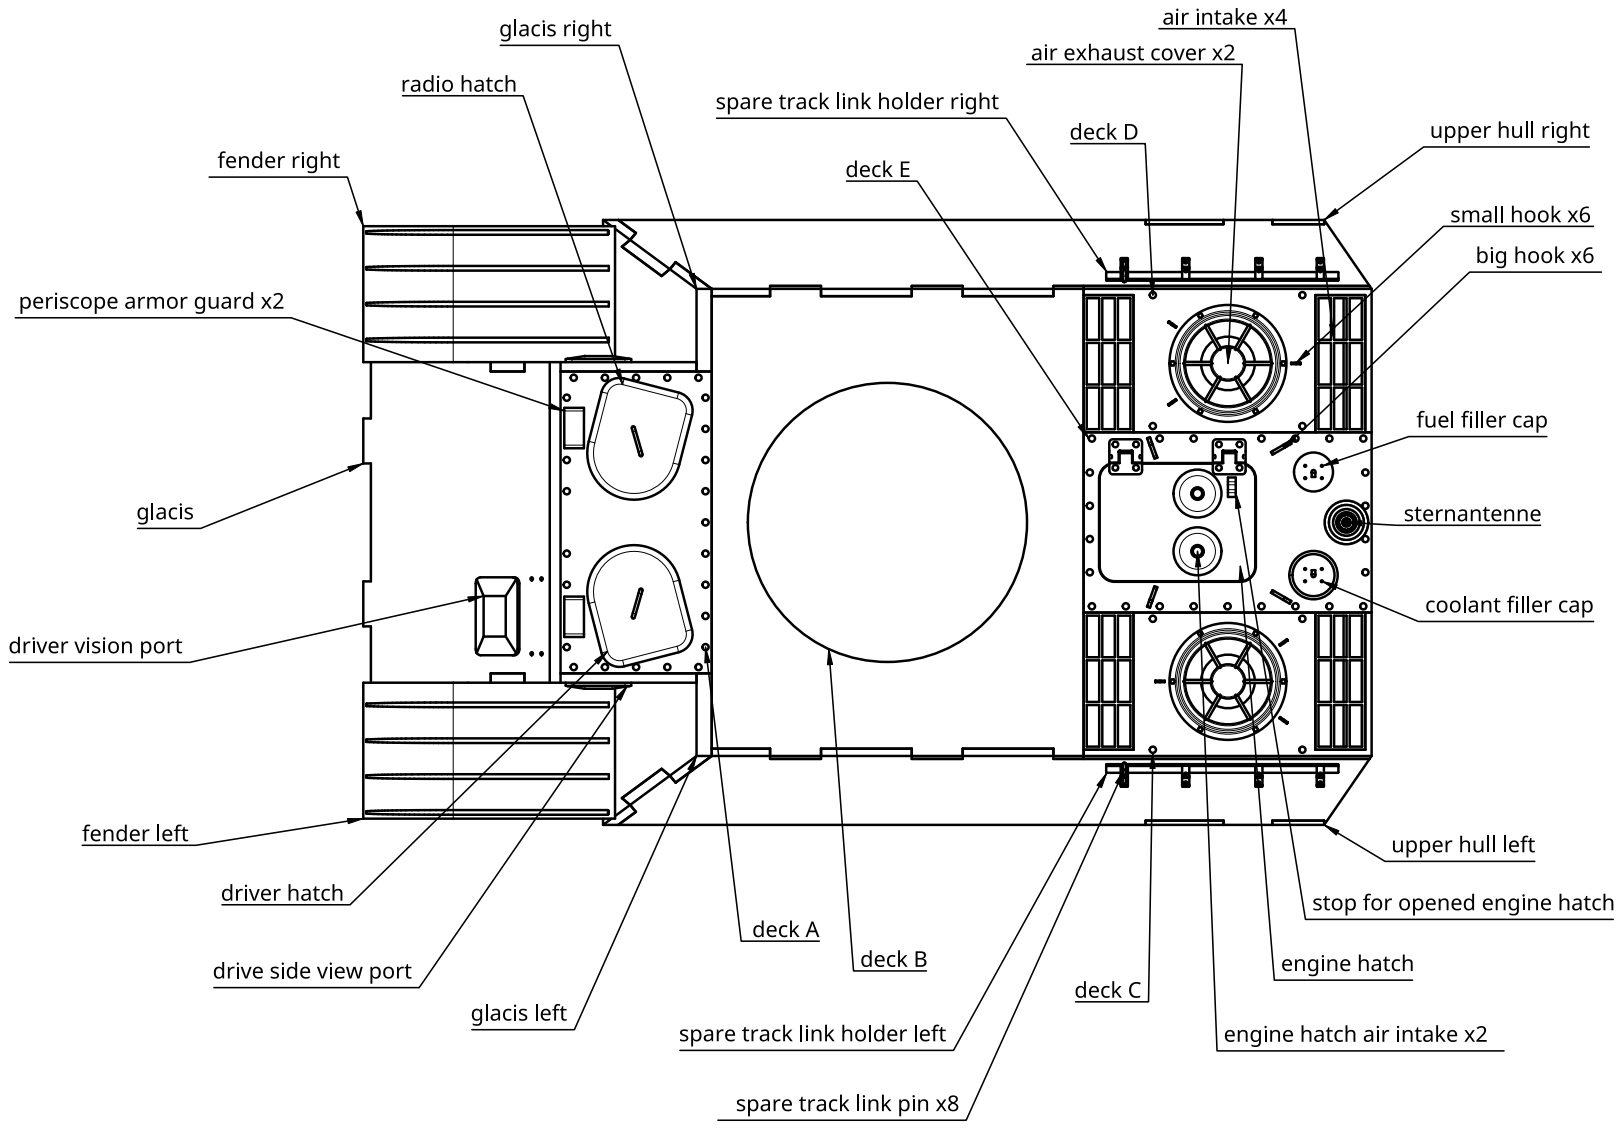
[picture p96: page 1]
