edumardo/VK-16.02-Leopard/upper hull/upper hull assembly 2.pdf

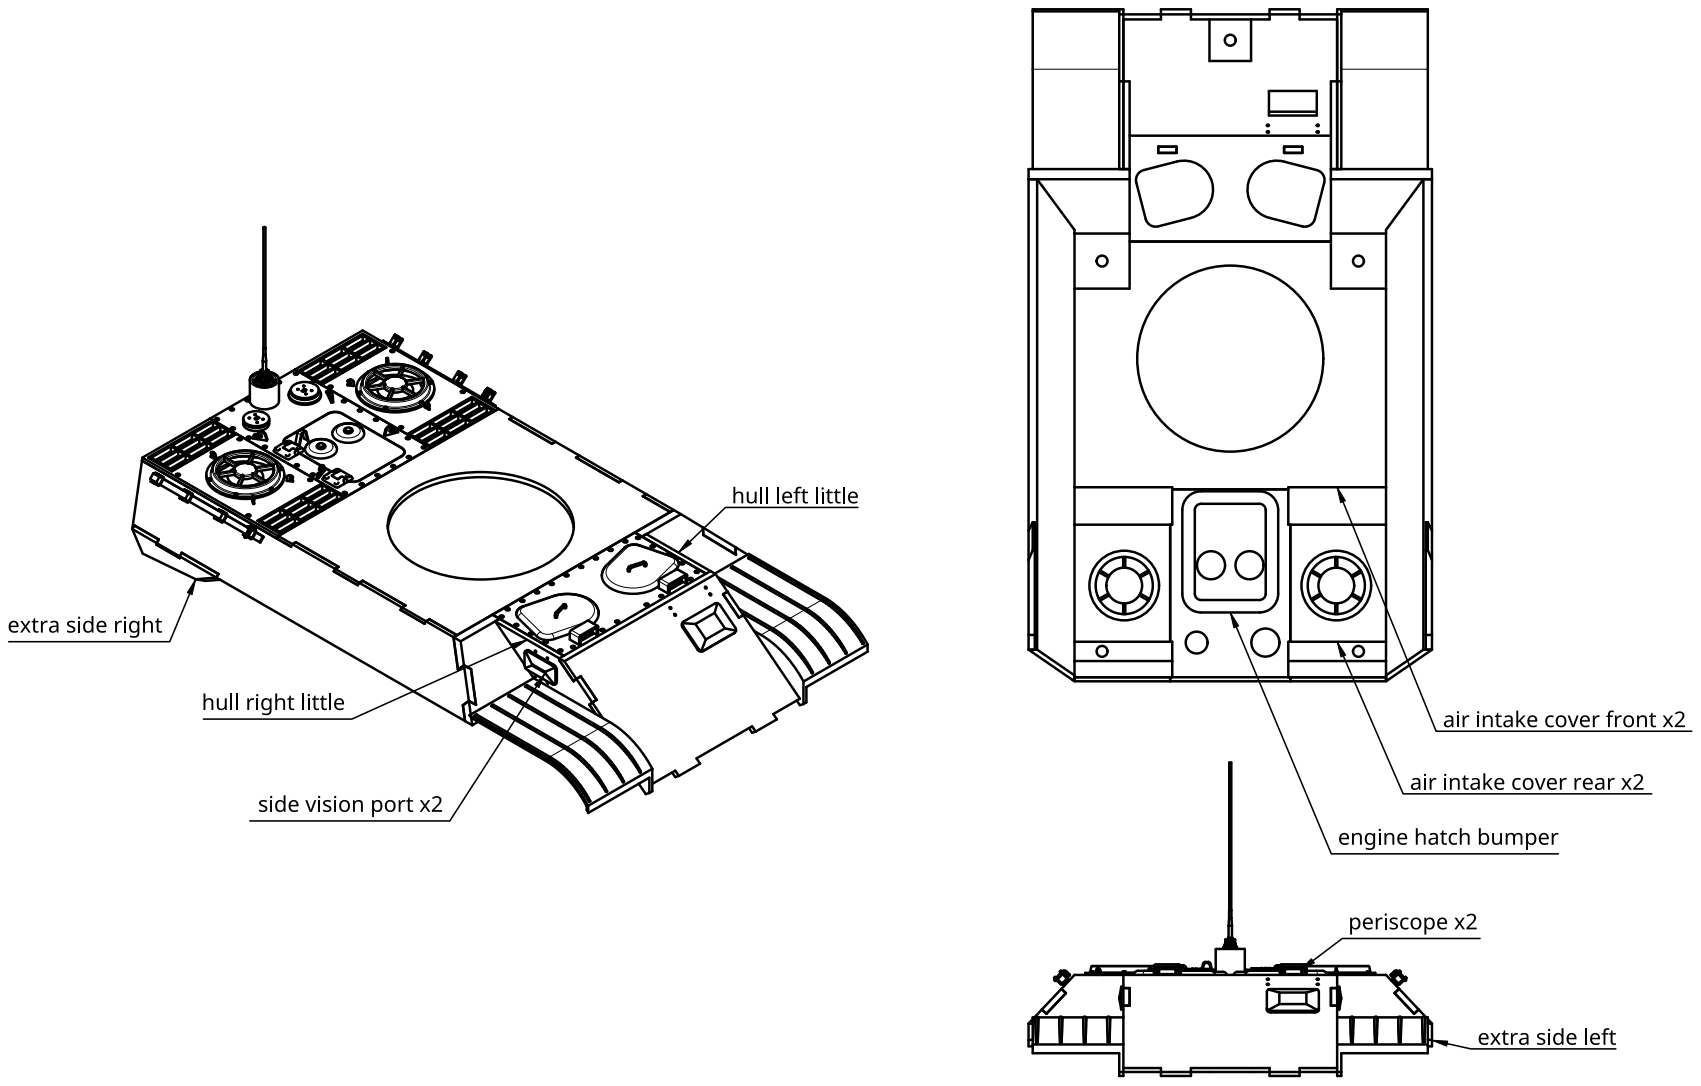
[picture p97: page 1]
