edumardo/VK-16.02-Leopard/upper hull/upper hul assembly.pdf

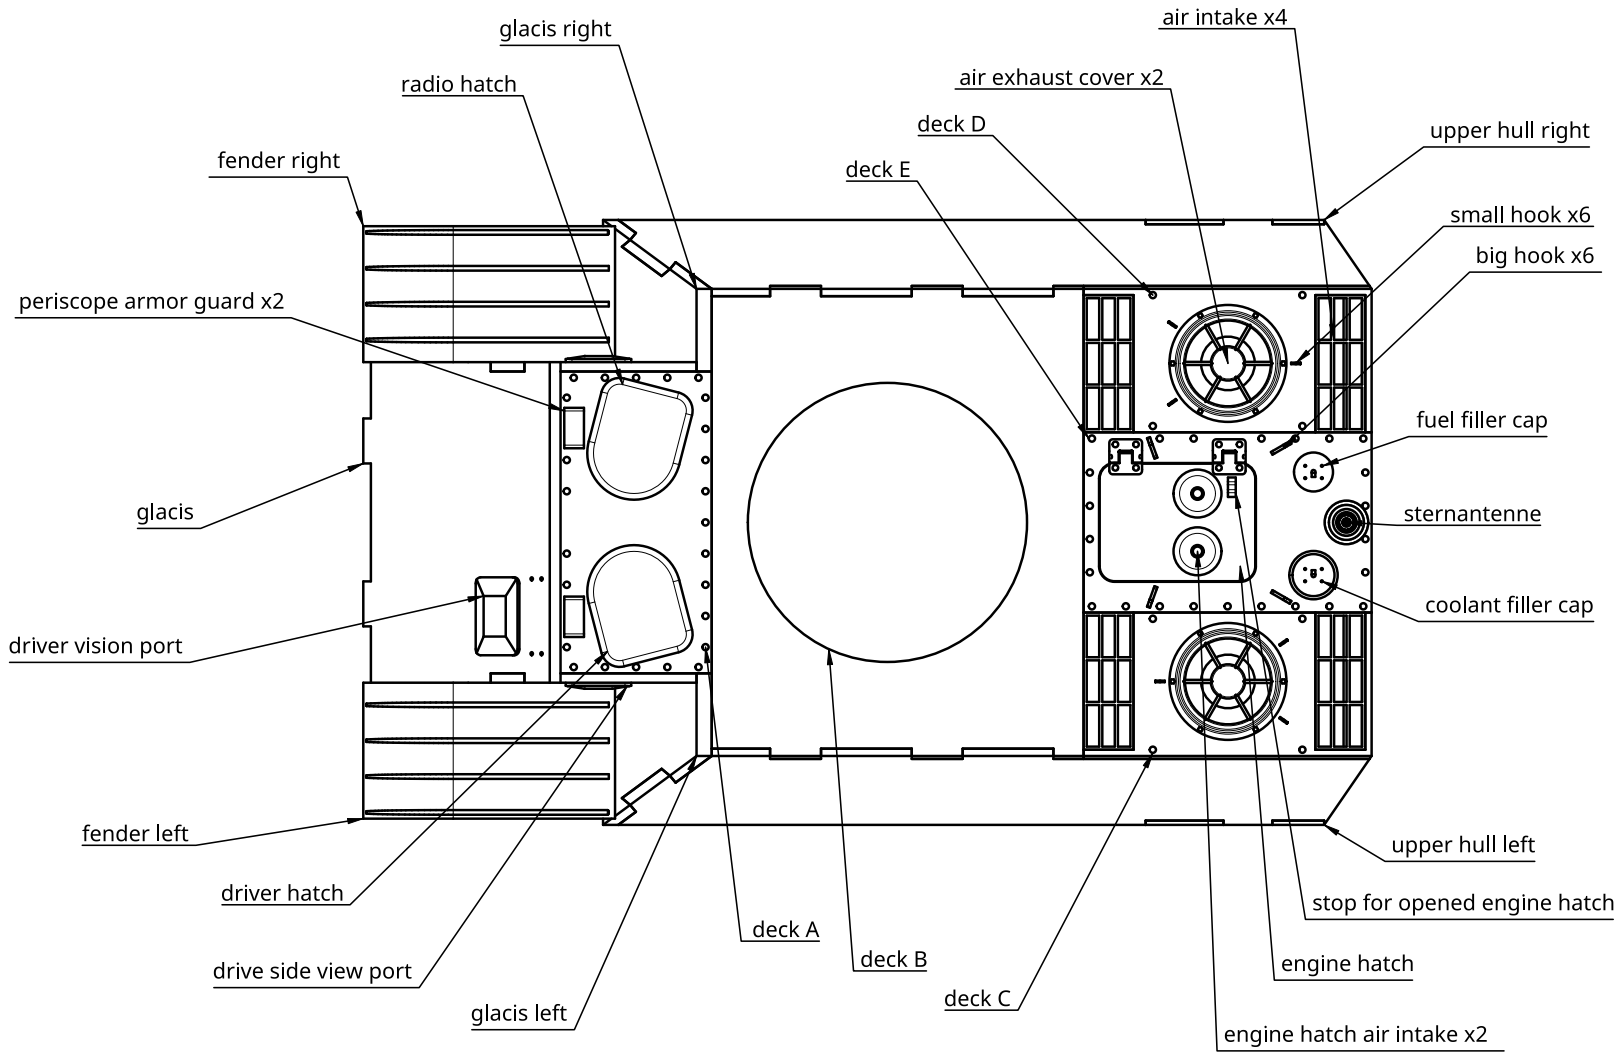
[picture p98: page 1]

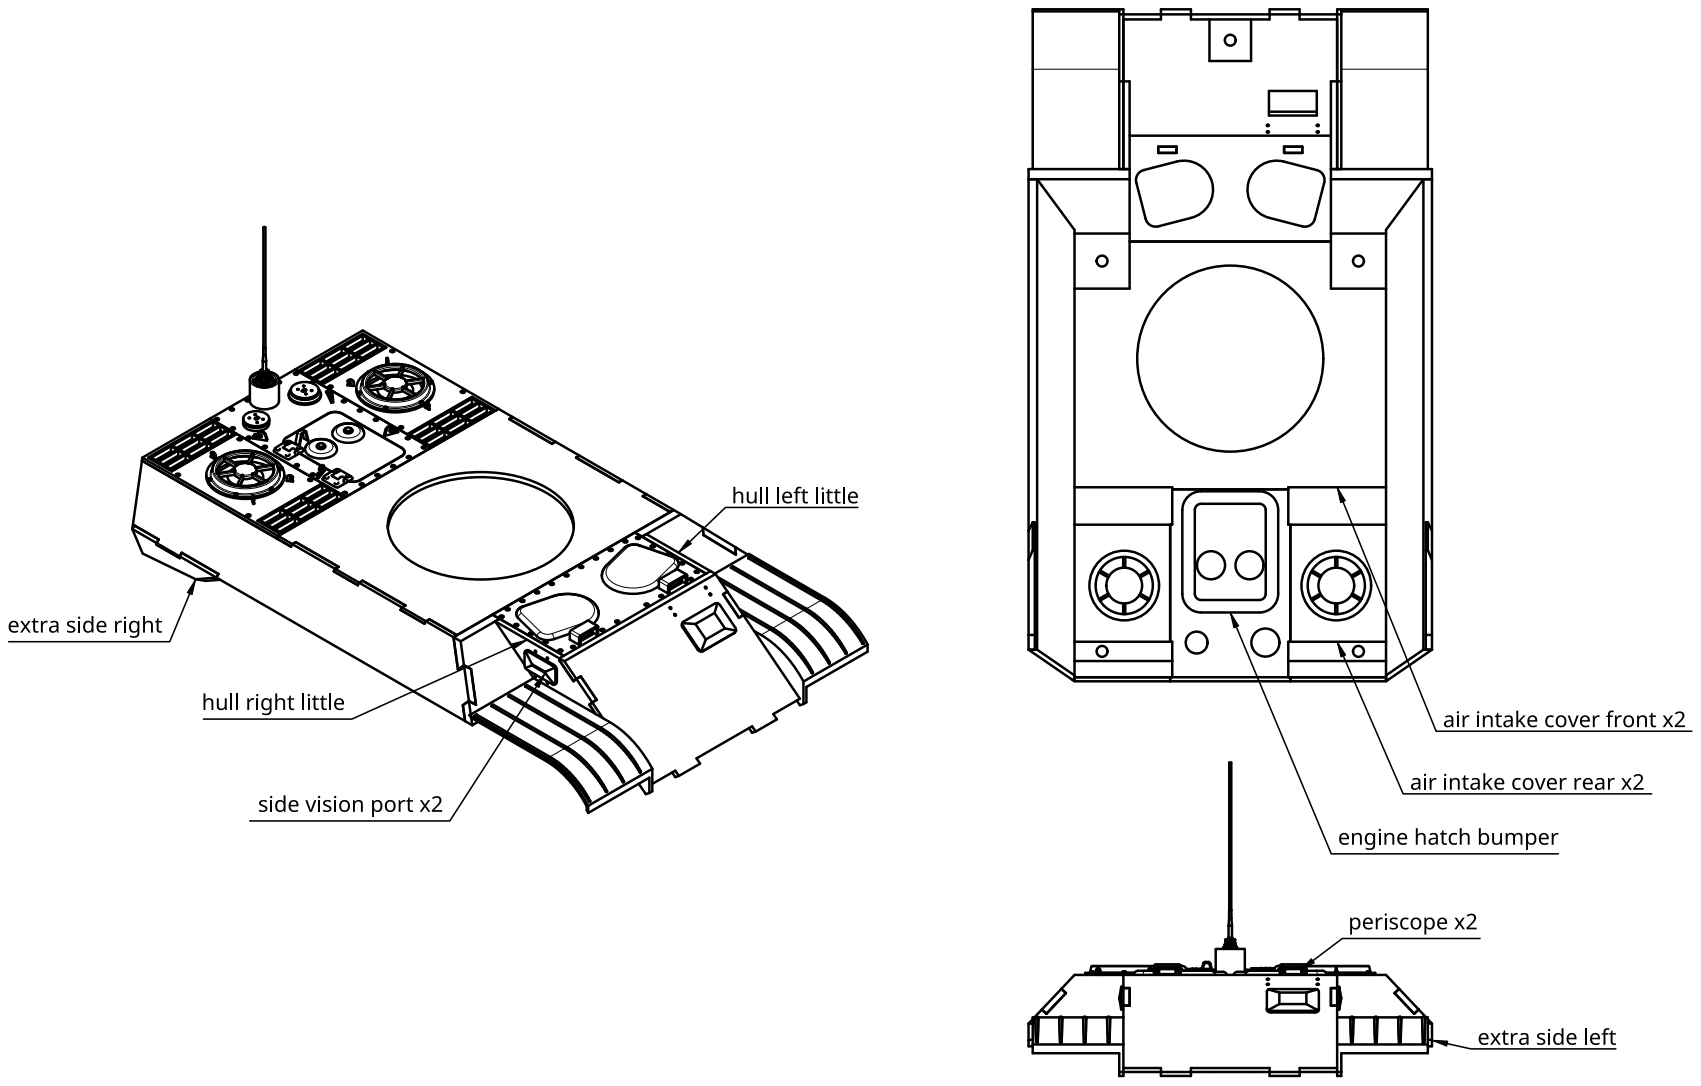
[picture p99: page 2]
