edumardo/VK-16.02-Leopard/hull/hull assembly.pdf

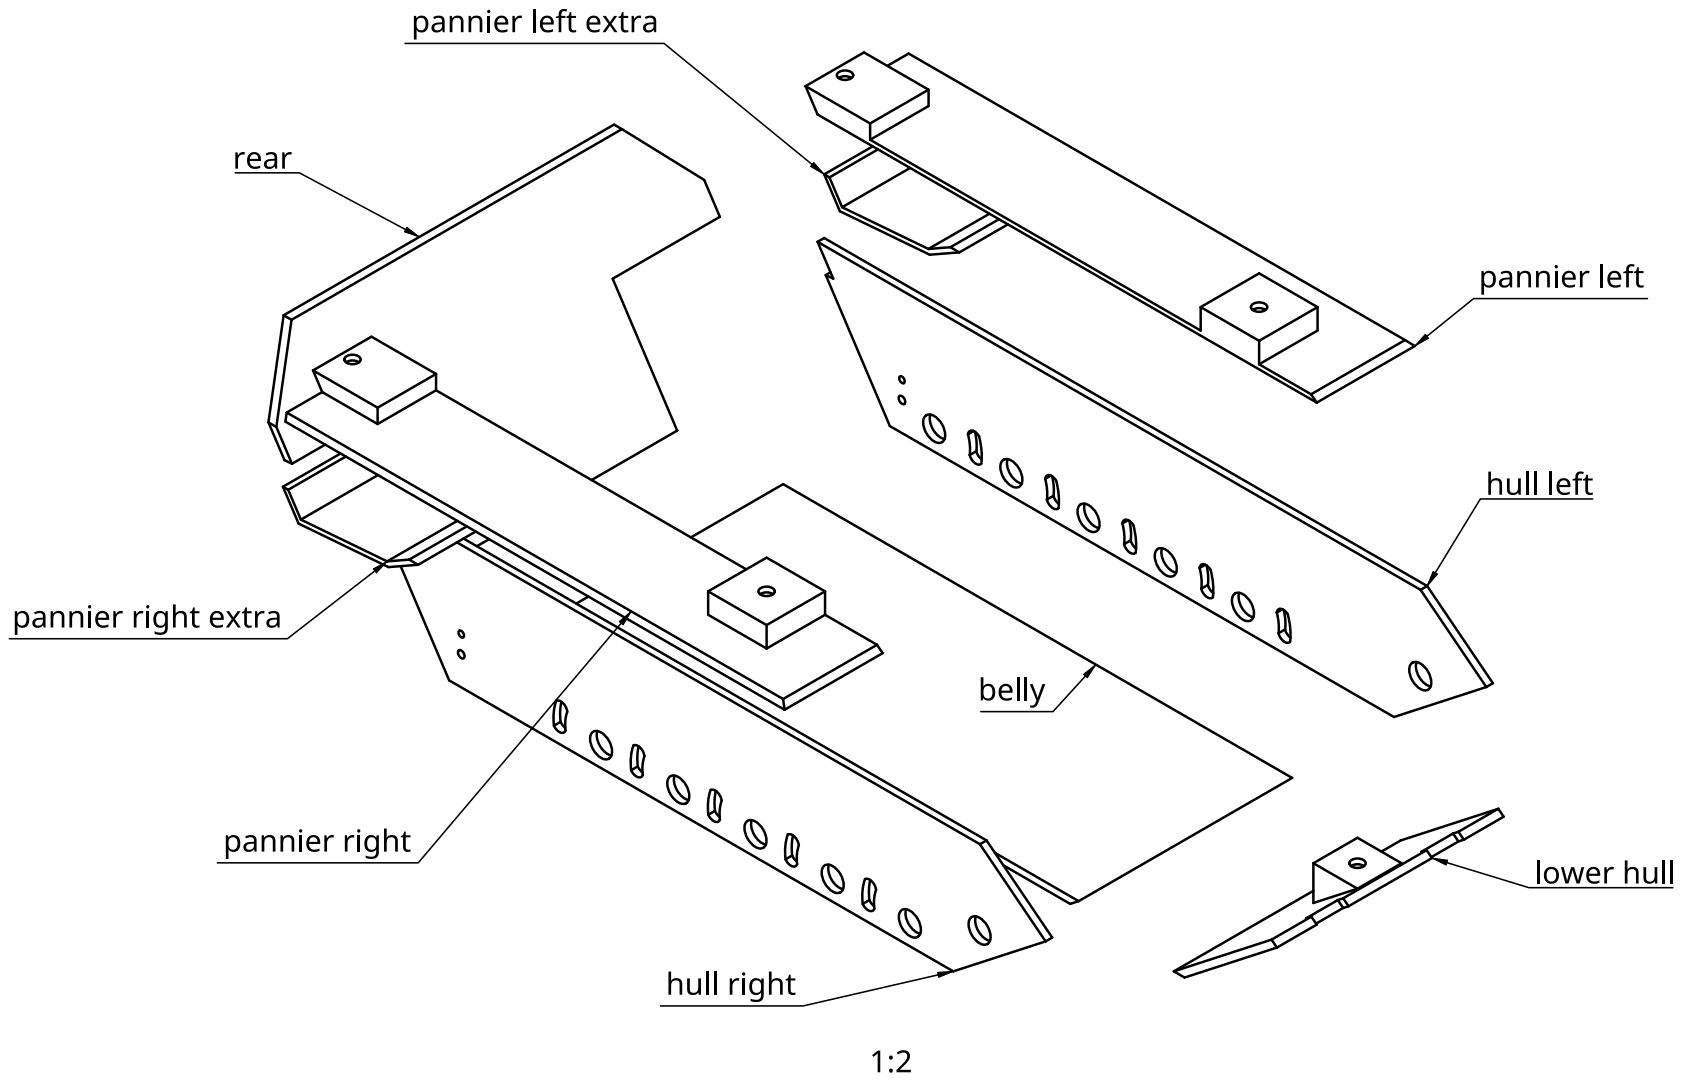
[picture p100: page 1]
