edumardo/VK-16.02-Leopard/suspension/suspension assembly.pdf

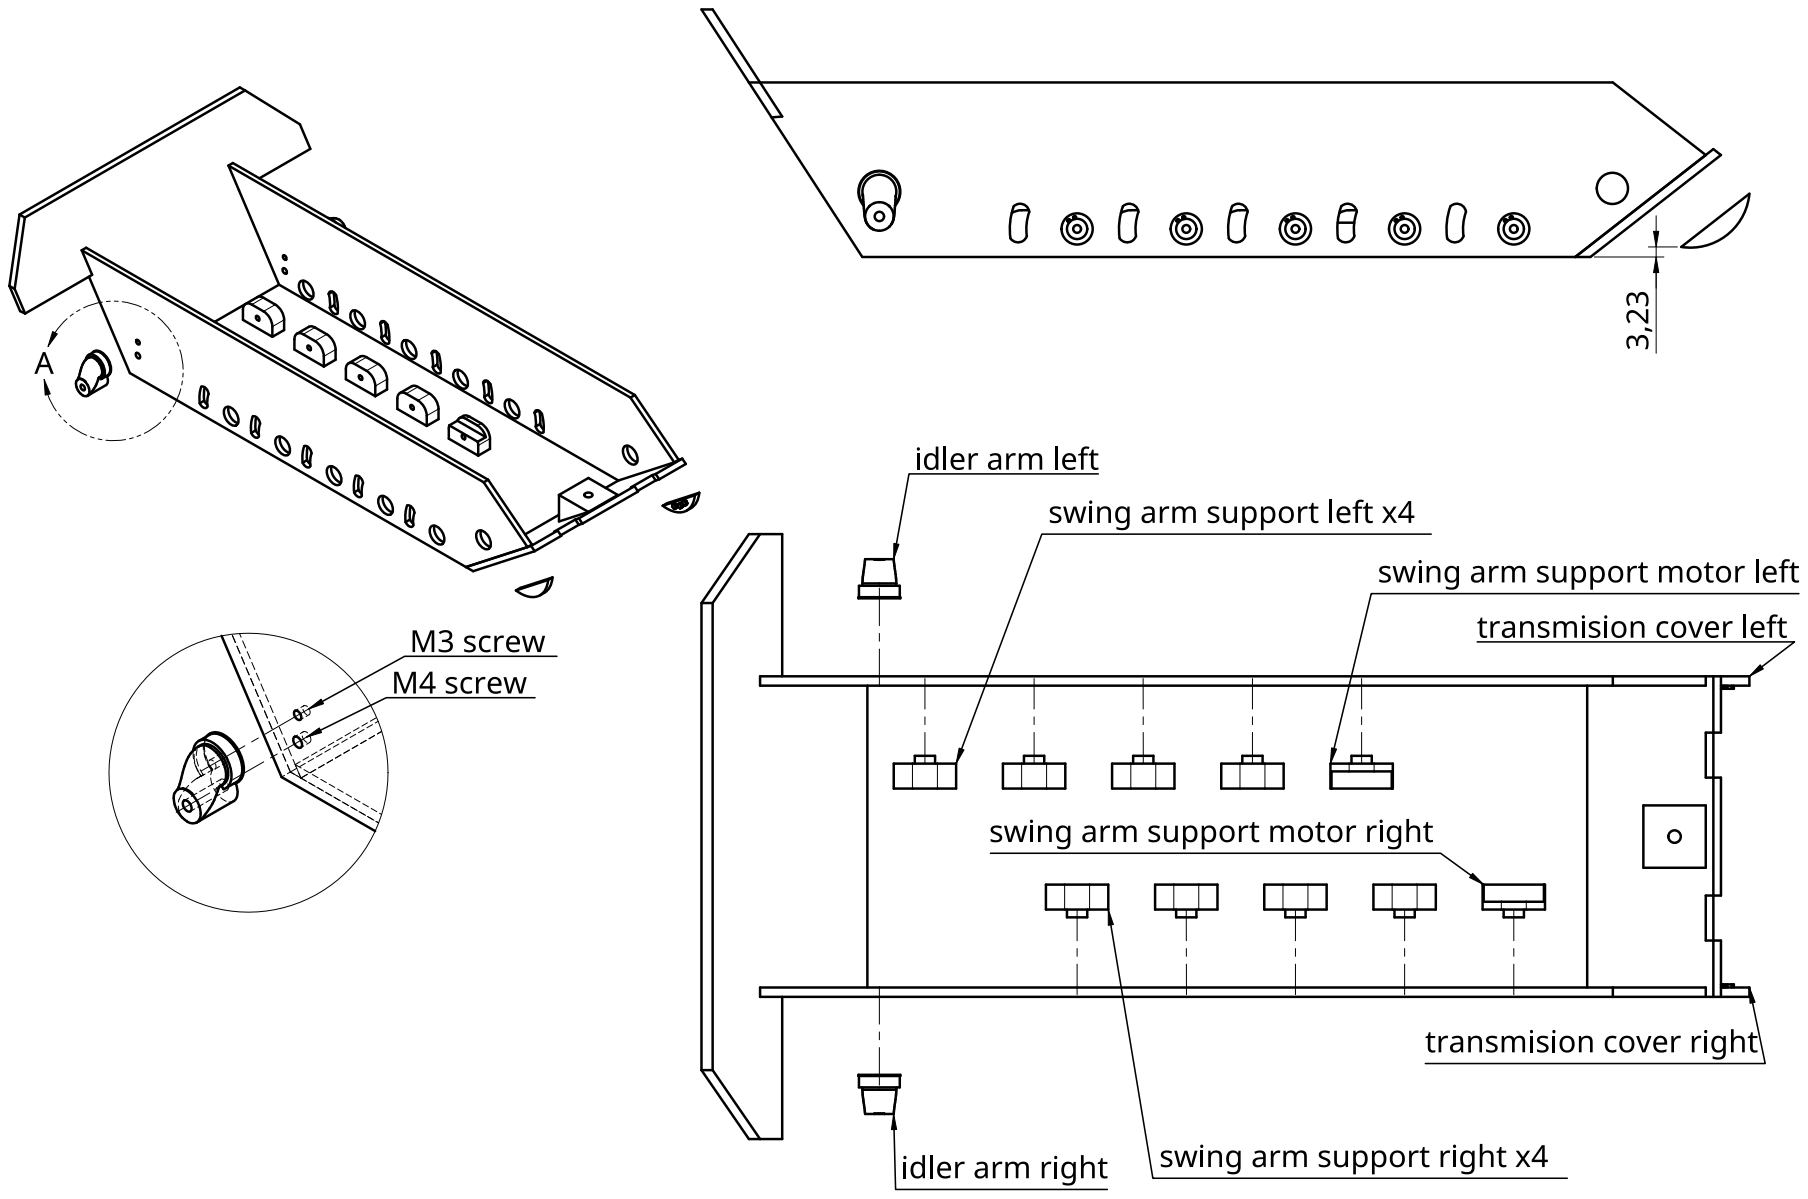
[picture p101: page 1]
