edumardo/VK-16.02-Leopard/rear stuff/rear stuff assembly.pdf

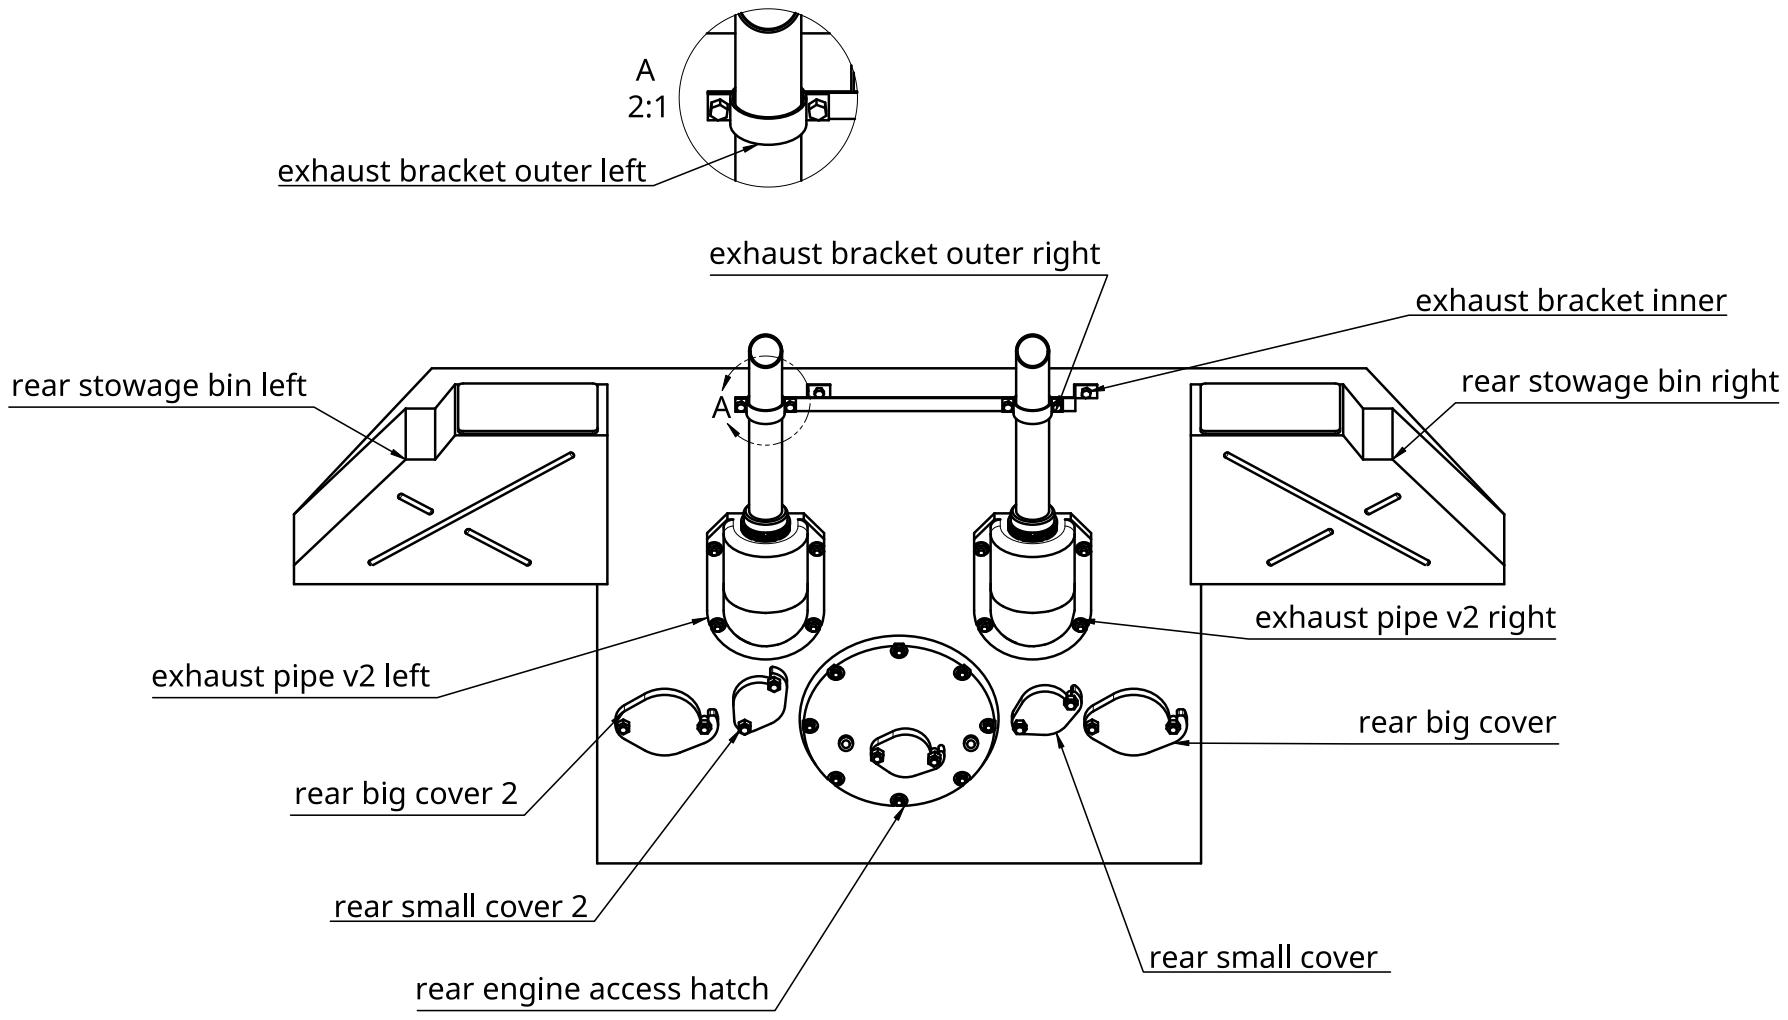
[picture p102: page 1]
