edumardo/VK-16.02-Leopard/(commit log)

2022-01-26 hull files
    [belly.stl, hull left.stl, hull right.stl, lower hull.stl, pannier left extra.stl, pannier left.stl, pannier right extra.stl, pannier right.stl]
2022-01-26 hull assembly image
2022-02-18 suspension files
    [idler arm left.stl, idler arm right.stl, swing arm support left x5.stl, swing arm support right x5.stl, transmission cover left.stl, transmission cover right.stl]
2022-04-29 idler arm position clarification
2022-04-29 init rear stuff
    [exhaust bracket outer left.stl, exhaust bracket outer right.stl, exhaust brackets inner.stl, exhaust pipe v2 left.stl, exhaust pipe v2 right.stl, rear big cover 2.stl, rear big cover.stl, rear engine access hatch.stl]
2022-06-15 Magnet supports in panniers and idler arm holes
    [hull - all parts.stl, hull left.stl, hull right.stl, pannier left.stl, pannier right.stl]
2022-06-15 Enlarged holes in idler arms and all parts file
    [idler arm left.stl, idler arm right.stl]
2022-06-15 electronics and heng long non-printable parts
2022-06-21 Swing arm supports new quantity
    [swing arm support left x4.stl, swing arm support right x4.stl]
2022-06-21 fix swing arm supports right position and motors
    [swing arm support motor left.stl, swing arm support motor right.stl]
2022-06-27 lower hull magnet
    [hull - all parts.stl, lower hull.stl]
2022-07-21 init upper hull
    [air exhaust cover x2.stl, air intake cover front x2.stl, air intake cover rear x2.stl, air intake x4.stl, big hook x6.stl, coolant filler cap.stl, deck A.stl, deck B.stl]
2022-10-20 hatch hinges and track link holder
    [driver hatch.stl, radio hatch.stl, spare track link holder.stl, spare track link pin.stl]
2022-11-24 init turret
    [antenna.stl, big hook x3.stl, gun barrel - part a.stl, gun barrel - part b.stl, gun barrel.stl, gun bracket x2.stl, gun mantlet.stl, gun pivot support.stl]
2022-12-05 fix turret base fit
    [turret base.stl]
2026-04-24 Hollowed gun barrel. 4 spaces for bearings in turret base
    [gun barrel - hollow part a.stl, gun barrel - hollow part b.stl, gun barrel hollow.stl, turret base.stl]
